msinger/gbreveng/pcb/fpgaboard/bom.ods

Designator | MPN/Seeed SKU | Qty | Link | Unit Price | Qty Price | Footprint | Value
X1 | ASTX-H11-12.000MHZ-T | 1 | https://eu.mouser.com/ProductDetail/ABRACON/ASTX-H11-12000MHZ-T?qs=tfZGHB2PWd3hgco%252bnV3PjQ%3d%3d | $3.170 | $3.170 | 3.2 mm x 2.5 mm | 12 MHz
X2 | LFSPXO054791Cutt | 1 | https://eu.mouser.com/ProductDetail/IQD/LFSPXO054791Cutt?qs=SNm0F99quPHVYfHQp5%2fdgA%3d%3d | $1.680 | $1.680 | 3.2 mm x 2.5 mm | 16.777216 MHz
C1,C2,C3,C9,C16,C17,C29,C81 | CC0603KRX5R6BB106 | 8 | https://statics3.seeedstudio.com/images/opl/datasheet/302010103.pdf | $0.020 | $0.160 | 0603 | 10µF
C12,C13 | CC0805MKX5R5BB226 | 2 | https://statics3.seeedstudio.com/images/opl/datasheet/302010171.pdf | $0.024 | $0.048 | 0805 | 22µF
C109,C110,C111,C113 | GRM31CR60J107ME39L | 4 | https://statics3.seeedstudio.com/images/opl/datasheet/302010183.pdf | $0.400 | $1.600 | 1206 | 100µF
C4,C5,C6,C11,C14,C15,C20,C21,C23,C24,C25,C26,C28,C30,C31,C32,C33,C35,C37,C38,C39,C40,C41,C42,C43,C44,C45,C46,C47,C48,C49,C50,C51,C52,C53,C54,C55,C56,C57,C58,C59,C60,C61,C62,C63,C64,C65,C66,C67,C68,C69,C70,C71,C72,C73,C74,C75,C76,C77,C78,C79,C80,C83,C85,C86,C91,C92,C93,C94,C95,C96,C97,C98,C99,C100,C104,C105,C112 | CC0402KRX7R8BB104 | 78 | https://statics3.seeedstudio.com/images/opl/datasheet/302010024.pdf | $0.010 | $0.780 | 0402 | 100nF
C7,C8,C22,C27,C84 | CC0402KRX7R9BB103 | 5 | https://statics3.seeedstudio.com/images/opl/datasheet/302010006.pdf | $0.010 | $0.050 | 0402 | 10nF
C10,C34,C36 | CC0603KRX5R6BB475 | 3 | https://statics3.seeedstudio.com/images/opl/datasheet/302010111.pdf | $0.010 | $0.030 | 0603 | 4.7µF
C18,C19,C82,C101,C102,C103 | CC0402KRX5R6BB105 | 6 | https://statics3.seeedstudio.com/images/opl/datasheet/302010040.pdf | $0.010 | $0.060 | 0402 | 1µF
C87,C88,C89,C90 | CC0402JRNPO9BN101 | 4 | https://statics3.seeedstudio.com/images/opl/datasheet/302010012.pdf | $0.010 | $0.040 | 0402 | 100pF
C106,C107,C108 | CC0402KRX7R8BB473 | 3 | https://statics3.seeedstudio.com/images/opl/datasheet/302010002.pdf | $0.010 | $0.030 | 0402 | 47nF
R1,R2,R13 | RC0805JR-07100RL | 3 | https://statics3.seeedstudio.com/images/opl/datasheet/301010319.pdf | $0.010 | $0.030 | 0805 | 100Ω
R3,R4,R20,R124 | RC0402JR-071ML | 4 | https://statics3.seeedstudio.com/images/opl/datasheet/301010009.pdf | $0.010 | $0.040 | 0402 | 1MΩ
R5,R6,R7,R8,R9,R17,R19,R21,R27,R28,R29,R30,R32,R33,R37,R38,R39,R40,R41,R42,R43,R44,R47,R48,R49,R50,R51,R52,R53,R54,R55,R56,R57,R58,R59,R60,R61,R62,R63,R64,R65,R66,R83,R84,R85,R86,R87,R88,R89,R91,R92,R93,R94,R103,R104,R105,R106,R107,R108,R109,R110,R111,R112,R114,R115,R125,R126,R128,R129,R135,R136,R137,R138,R139 | RC0402JR-0710KL | 74 | https://statics3.seeedstudio.com/images/opl/datasheet/301010004.pdf | $0.010 | $0.740 | 0402 | 10kΩ
R10 | WR04X3573FTL | 1 | https://eu.mouser.com/ProductDetail/Walsin/WR04X3573FTL?qs=t1sE%252bOcWp5vGlB9Bewecbg%3d%3d | $0.124 | $0.124 | 0402 | 1% 357kΩ
R11 | AC0402FR-07210KL | 1 | https://eu.mouser.com/ProductDetail/Yageo/AC0402FR-07210KL?qs=ygRr%2ftkhtev38ZlIvvgTpQ%3d%3d | $0.100 | $0.100 | 0402 | 1% 210kΩ
R18,R67,R68,R69,R70,R71,R72,R73,R74,R75,R76,R77,R78,R79,R80,R81,R82 | RC0402JR-071KL | 17 | https://statics3.seeedstudio.com/images/opl/datasheet/301010006.pdf | $0.010 | $0.170 | 0402 | 1kΩ
R22,R24 | RC0402JR-072K2L | 2 | https://statics3.seeedstudio.com/images/opl/datasheet/301010039.pdf | $0.011 | $0.022 | 0402 | 2.2kΩ
R23 | RC0402FR-0712KL | 1 | https://statics3.seeedstudio.com/images/opl/datasheet/resistance-series.pdf | $0.010 | $0.010 | 0402 | 1% 12kΩ
R36 | RC0402FR-07649RL | 1 | https://eu.mouser.com/ProductDetail/Yageo/RC0402FR-07649RL?qs=Is6ZsIPfHkYMbt18SYSi%252bQ%3d%3d | $0.100 | $0.100 | 0402 | 1% 649Ω
R95,R96,R97,R98,R99,R100,R101,R102,R116,R117,R118,R119,R120,R121,R122,R123 | RC0603JR-0710RL | 16 | https://statics3.seeedstudio.com/images/opl/datasheet/301010096.pdf | $0.010 | $0.160 | 0603 | 10Ω
R12,R130,R131,R132,R133 | RC0805JR-07220RL | 5 | https://statics3.seeedstudio.com/images/opl/datasheet/301010315.pdf | $0.010 | $0.050 | 0805 | 220Ω
R140,R141,R142 | RC0402JR-0747RL | 3 | https://statics3.seeedstudio.com/images/opl/datasheet/resistance-series.pdf | $0.010 | $0.030 | 0402 | 47Ω
RV1,RV2,RV3 | TS53YL102MR10 | 3 | https://eu.mouser.com/ProductDetail/Vishay-Sfernice/TS53YL102MR10?qs=R4%2fAj8xQbdWvnedTKTFTKg%3d%3d | $1.660 | $4.980 | Vishay TS53YL | 1kΩ
Q1,Q2 | BSS138W-7-F | 2 | https://statics3.seeedstudio.com/images/opl/datasheet/305030000.pdf | $0.033 | $0.066 | SOT-323 | BSS138
L5,L6 | Murata;LQW15AN33NJ00D | 2 | https://statics3.seeedstudio.com/images/opl/datasheet/303010106.pdf | $0.024 | $0.048 | 0402 | 33nH
L1,L2,L3,L4 | MMZ1608B601C | 4 | https://eu.mouser.com/ProductDetail/TDK/MMZ1608B601C?qs=fOf5s7IOgVG9xKc6xJGMYw%3d%3d | $0.100 | $0.400 | 0603 | 600Ω 500mA
SW0,SW1,SW2,SW3 | TD-1183SN-A3N-D1R | 4 | https://statics3.seeedstudio.com/fusion/opl/datasheet/311020740.pdf | $0.256 | $1.024 | 3 mm x 2.5 mm
SW4,SW5 | CTS;206-8 | 2 | https://eu.mouser.com/ProductDetail/CTS-Electronic-Components/206-8?qs=qNzHFtQhdJ%252bV9O%2fUzcUFng%3d%3d | $0.914 | $1.828 | W 7.63 mm
D0,D1,D2,D3,D4,D5,D6,D7,D8,D9,D10,D11,D12,D13,D14,D15 | 17-215SURC/S530-A2/TR8 | 16 | https://statics3.seeedstudio.com/images/opl/datasheet/304090046.pdf | $0.026 | $0.416 | 0805 | red
D17,D18 | 17-215SYGC/S530-E2/TR8 | 2 | https://statics3.seeedstudio.com/images/opl/datasheet/304090057.pdf | $0.026 | $0.052 | 0805 | green
D16 | CDBU0520 | 1 | https://eu.mouser.com/ProductDetail/Comchip-Technology/CDBU0520?qs=QrYNfmA0esYvGSGDalbccA%3d%3d | $0.452 | $0.452 | 0603 | CDBU0520
D19,D20,D21,D22 | BAV199WQ-7 | 4 | https://eu.mouser.com/ProductDetail/Diodes-Incorporated/BAV199WQ-7?qs=xLhQT1EE4V%252brO8tFabP6bQ%3d%3d | $0.271 | $1.084 | SOT-323 | BAV199WQ
D23 | BAV100-GS08 | 1 | https://eu.mouser.com/ProductDetail/Vishay-Semiconductors/BAV100-GS08?qs=WLTup5mM6hiycTaKo%2fbC7A%3d%3d | $0.201 | $0.201 | MiniMELF | BAV100
J2 | 105017-0001 | 1 | https://eu.mouser.com/ProductDetail/Molex/105017-0001?qs=hlXxxvYE36k7QcsR97GUKA%3d%3d | $0.783 | $0.783
J11 | DM3AT-SF-PEJM5 | 1 | https://eu.mouser.com/ProductDetail/Hirose-Connector/DM3AT-SF-PEJM5?qs=LZSZKJVF%252b2WTDKp%252bR7IYAQ%3d%3d | $2.630 | $2.630
J28 | SJ1-3533NG | 1 | https://eu.mouser.com/ProductDetail/CUI/SJ1-3533NG?qs=WyjlAZoYn53GjNky%252bNFGCA%3d%3d | $1.170 | $1.170
J6 | 52045-2145 | 1 | https://eu.mouser.com/ProductDetail/Molex/52045-2145?qs=g5f4E6w8l8i4Jv%252bBEK7mDw%3d%3d | $0.794 | $0.794
U1 | LT3030EFE#PBF | 1 | https://www.digikey.com/short/pcf4ht | $7.120 | $7.120 | 20-ETSSOP
U2 | W25Q32JVSSIM TR | 1 | https://eu.mouser.com/ProductDetail/Winbond/W25Q32JVSSIM-TR?qs=qSfuJ%252bfl%2fd55hO45Ox4sXQ%3d%3d | $0.823 | $0.823 | SOIC-8 208 | 4M x 8bit
U3 | ICE40HX8K-CT256 | 1 | https://eu.mouser.com/ProductDetail/Lattice/iCE40HX8K-CT256?qs=F9A14TELRMtUXwpvAxLNcw%3d%3d | $11.350 | $11.350 | 256-CABGA
U4 | 93LC56BT-I/SN | 1 | https://eu.mouser.com/ProductDetail/Microchip-Technology/93LC56BT-I-SN?qs=lQv0JY93vreW%252bBssv4v8RA%3d%3d | $0.251 | $0.251 | SOIC-8 150 | 128 x 16bit
U5 | FT2232HL-REEL | 1 | https://eu.mouser.com/ProductDetail/FTDI/FT2232HL-REEL?qs=D1%2fPMqvA100v7FHcEx164g%3d%3d | $6.740 | $6.740 | LQFP-64
U6,U7,U8,U9,U10,U11,U12,U13,U14,U15,U16 | SN74LVCH8T245PWR | 11 | https://eu.mouser.com/ProductDetail/Texas-Instruments/SN74LVCH8T245PWR?qs=H8TbSl0SgbH0mxJKLczsYg%3d%3d | $1.320 | $14.520 | 24-TSSOP
U19 | SN74AHC1GU04DCK3 | 1 | https://eu.mouser.com/ProductDetail/Texas-Instruments/SN74AHC1GU04DCK3?qs=HtiCF%252bSLVmeK2lzXvlFtoA%3d%3d | $0.412 | $0.412 | SC-70-5
U18,U21 | IS62WV10248EBLL-45TLI | 2 | https://eu.mouser.com/ProductDetail/ISSI/IS62WV10248EBLL-45TLI?qs=uCnMRCNammlHlbXwB0OS3A%3d%3d | $6.080 | $12.160 | 44-400mil-TSOP-2 | 1M x 8bit
U17,U20,U22 | IS62WV1288BLL-55QLI | 3 | https://eu.mouser.com/ProductDetail/ISSI/IS62WV1288BLL-55QLI?qs=YdQ7Kj7W0byrjrEhKf64%2fw%3d%3d | $2.550 | $7.650 | 32-SOP | 128k x 8bit
 |  | 310 |  |  | $86.178
