msinger/gbreveng/(threads)

Thread 1 (2024-06-24):

Missing m1 in TRI_BUF_IF0

ogamespec, 2024-06-24:
Missed a little metal tail here:

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

msinger, 2024-06-24:
Right. Output of P1 is not connected anywhere if this bridge is missing. I wonder why I drew the schematics correctly then without noticing this.

Thread 2 (2024-09-17):

CK1_CK2 Pad

ogamespec, 2024-09-17:
Hi, I rebuilt the CK1_CK2 (OSC) masks and it looks like your transistor circuit and logic interpretation is different from what it actually is.

More details here:
https://github.com/emu-russia/dmgcpu/blob/main/wiki/soc/pads.md#osc

msinger, 2024-09-17:
Oh, nice. Then I should take my schematic of this cell down. It was just a guess, based on the other I/O cells, since I haven't done its layout yet.

Did you look at the SCK pad? It also has more logic than the others. Maybe I got this wrong too.

ogamespec, 2024-09-17:
As part of my analysis, I plan to do cross-checking with your results, everything I can get my hands on, including the rest of the pads :)

ogamespec, 2024-09-20:
Better view of CK1/CK2 internal logic:

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

msinger, 2024-09-20:
Great, thanks. I'm wondering about the bottom part a bit more. Is this what I see?
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

And then the same thing basically mirrored for the ground side?
Do you know why this is? Could this be protection against voltage spikes that may be generated by the crystal? I don't know much about analog stuff. Does a crystal have characteristics of an inductor maybe? If the voltage at the pad rises and then suddenly stops, that the crystal keeps pulling it up further, way past VDD? So, it could work like the diodes. But why aren't the diodes then enough?

My thought is that if you apply a voltage at the pad, which is higher than VDD, then VDD becomes ground, and then the transistor I've drawn at the right gets conductive and pulls the voltage at the pad down to VDD.

What is your thought about these transistors in the bottom part? Did I misunderstand something? I'm not sure.

ogamespec, 2024-09-20:
Yes it is, one of the two transistors in each of the “pieces” is “disabled” for some reason. I see this often, most likely it is just to regulate the power of the output signal (the more transistors “in parallel” - the more powerful the signal).
Analog electronics specialists will tell you more, I am not one of them :-)

Thread 4 (2024-09-25):

Strange sense amp in SRAM

ogamespec, 2024-09-25:
I found that the Sense Amp, which is just above the Column Mux for some reason works “in reverse” - it amplifies the value from the data bus instead of the cell. What do you think about it?

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

msinger, 2024-09-25:
I'm not an expert in SRAM terminology. :)
I think it is not the sense amp. I think the sense amps are the ones at the top in your picture, because they amplify the value read from the cell. I don't know what the "reverse sense amps" are typically called, but you need a strong driver to flip the value in the cells when writing. And those strong drivers need to drive the value through the column muxers at the bottom, so they need to be very big too.

ogamespec, 2024-09-25:
So there is no canonical Sense Amp in the circuit?

msinger, 2024-09-25:
Ah, okay, sorry, I understand. It's a picture of a sense amplifier. I think they don't need a circuit like this, because they use dynamic logic. Since the bit lines go through the column multiplexer, which consists of only NMOS transistors, the bit lines can only drive low states. So in your sense amplifier circuit, M3 and M4 are driven directly by the bit lines, and M1 and M2 provide the complementary, based on the output of M3 and M4. In the Game Boy, they provide the complementary by precharging, using transistors P8 and P9.
I think in a standard SRAM chip, you don't want dynamic logic, because you would need a clock for controlling that, so they use the circuit you provided. In the Game Boy, they have the clock anyway, so maybe it's simpler to implement using precharging.

msinger, 2024-09-26:
After sleeping over it, of course what I wrote makes no sense. You need to precharge the bit lines anyway. I don't know why they implemented the sensing differently.

ogamespec, 2024-09-27:
Thanks, yes I also think that because of precharge they don't need to add Sense Amp and even the output nor latch doesn't play a “sense” role here, it's just used as a flip/flop to keep the bus going (“bus keeper”).
Why I asked all this - you have “sense amp” in your Cells Reference, so I just wanted to clarify.
I think we can close :-)

ogamespec, 2024-09-27:
My part of the SRAM elements research:
https://github.com/ogamespec/dmgcpu/blob/main/wiki/soc/hram.md

It's not finished, but the other elements have already been explored by you and are pretty simple and of little interest (Cell Array, Row Decoder).

Closed 2024-09-27.

Thread 5 (2025-03-09):

/CS link broken

ogamespec, 2025-03-09:
In section: http://iceboy.a-singer.de/doc/dmg_cells.html#obuf_a

If you click on `CS`, it doesn't link anywhere. Probably meant `/CS`.

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

msinger, 2025-03-09:
Yes, thank you!

Closed 2025-03-09.
