msinger/gbreveng/pcb/disp_bridge/disp_bridge.kicad_pcb

## KiCad design pcb/disp_bridge/disp_bridge.kicad_pcb (2024-06-20)

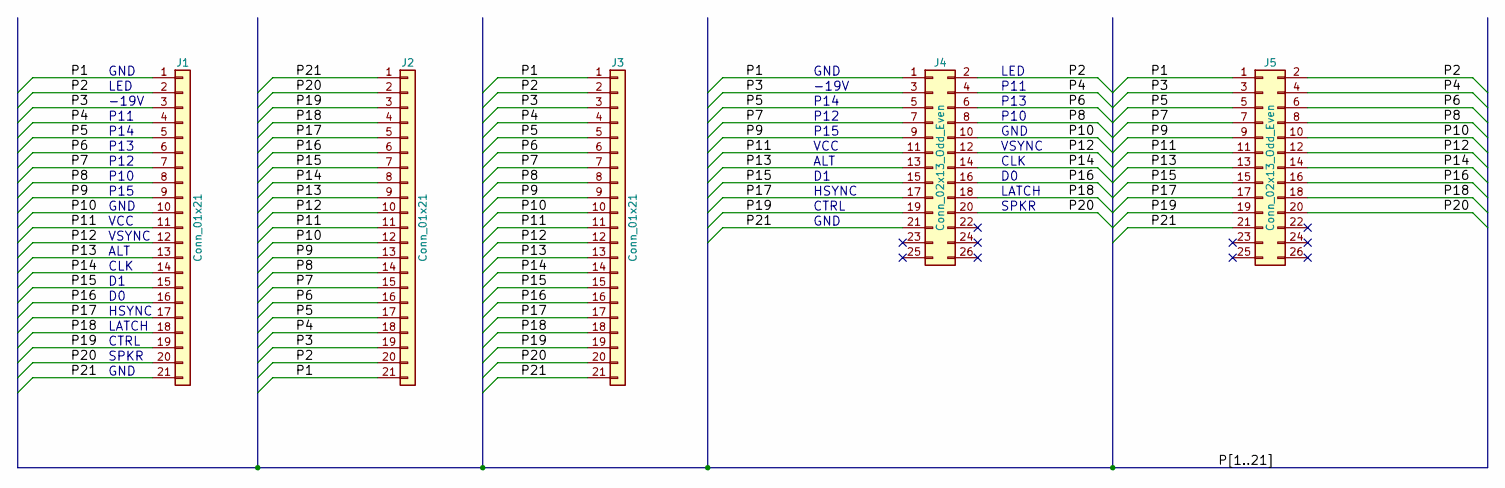
[picture p1: schematic disp_bridge.kicad_sch, Display Bridge]

Parts:
J1, J2, J3: Conn_01x21; DMG_FFC_LCD-Board_21Pin
J4, J5: Conn_02x13_Odd_Even; PinHeader_2x13_P2.54mm_Vertical

Connections:
/P1: J1.1, J2.21, J3.1, J4.1, J5.1
/P2: J1.2, J2.20, J3.2, J4.2, J5.2
/P3: J1.3, J2.19, J3.3, J4.3, J5.3
/P4: J1.4, J2.18, J3.4, J4.4, J5.4
/P5: J1.5, J2.17, J3.5, J4.5, J5.5
/P6: J1.6, J2.16, J3.6, J4.6, J5.6
/P7: J1.7, J2.15, J3.7, J4.7, J5.7
/P8: J1.8, J2.14, J3.8, J4.8, J5.8
/P9: J1.9, J2.13, J3.9, J4.9, J5.9
/P10: J1.10, J2.12, J3.10, J4.10, J5.10
/P11: J1.11, J2.11, J3.11, J4.11, J5.11
/P12: J1.12, J2.10, J3.12, J4.12, J5.12
/P13: J1.13, J2.9, J3.13, J4.13, J5.13
/P14: J1.14, J2.8, J3.14, J4.14, J5.14
/P15: J1.15, J2.7, J3.15, J4.15, J5.15
/P16: J1.16, J2.6, J3.16, J4.16, J5.16
/P17: J1.17, J2.5, J3.17, J4.17, J5.17
/P18: J1.18, J2.4, J3.18, J4.18, J5.18
/P19: J1.19, J2.3, J3.19, J4.19, J5.19
/P20: J1.20, J2.2, J3.20, J4.20, J5.20
/P21: J1.21, J2.1, J3.21, J4.21, J5.21

Notes on the sheet:
SPKR
LATCH
P15
VSYNC
P11
P13
GND
P14
HSYNC
P12
-19V
VCC
P10
CLK
ALT
LED
CTRL

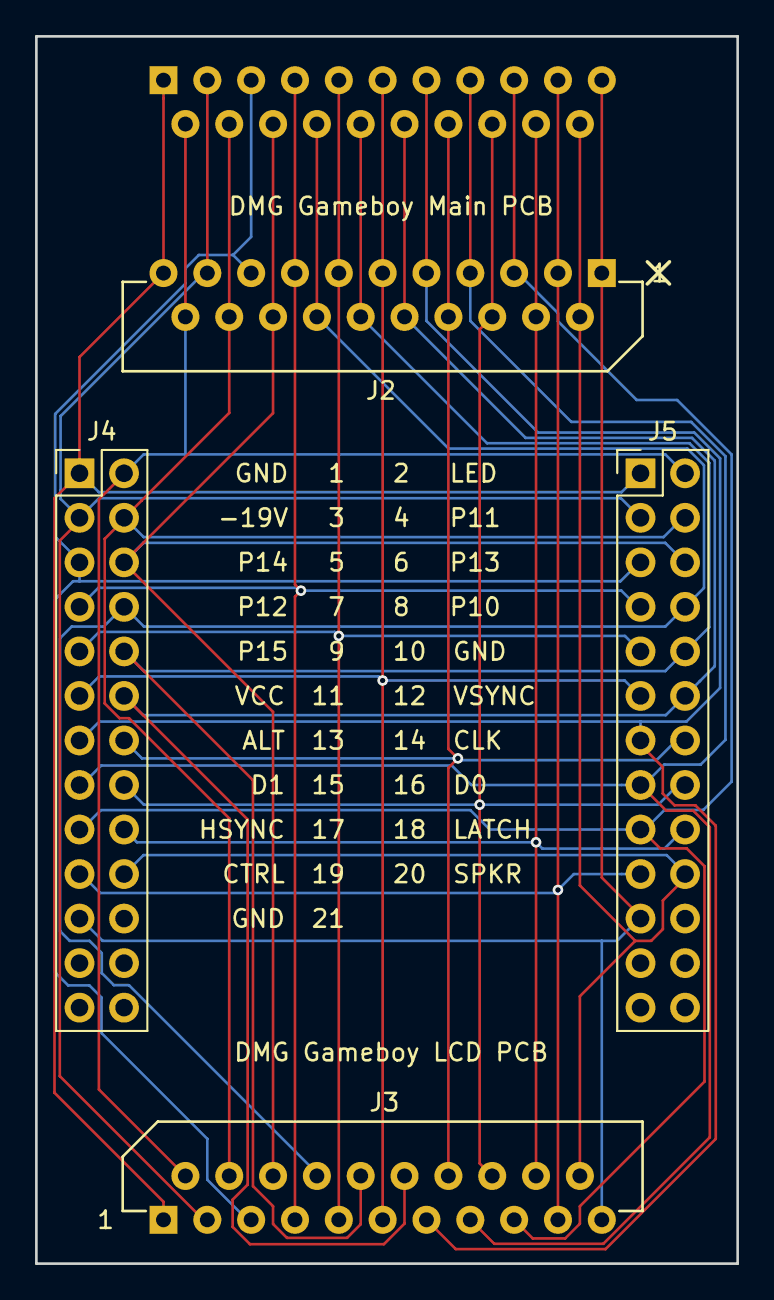
[picture p2: board disp_bridge.kicad_pcb from above]

Board: 2 copper layers, 40.0 x 70.0 mm, 5 parts (1 on the bottom side), 21 nets.
