msinger/gbreveng/pcb/lcdpwr/lcdpwr.kicad_pcb

## KiCad design pcb/lcdpwr/lcdpwr.kicad_pcb (2024-06-20)

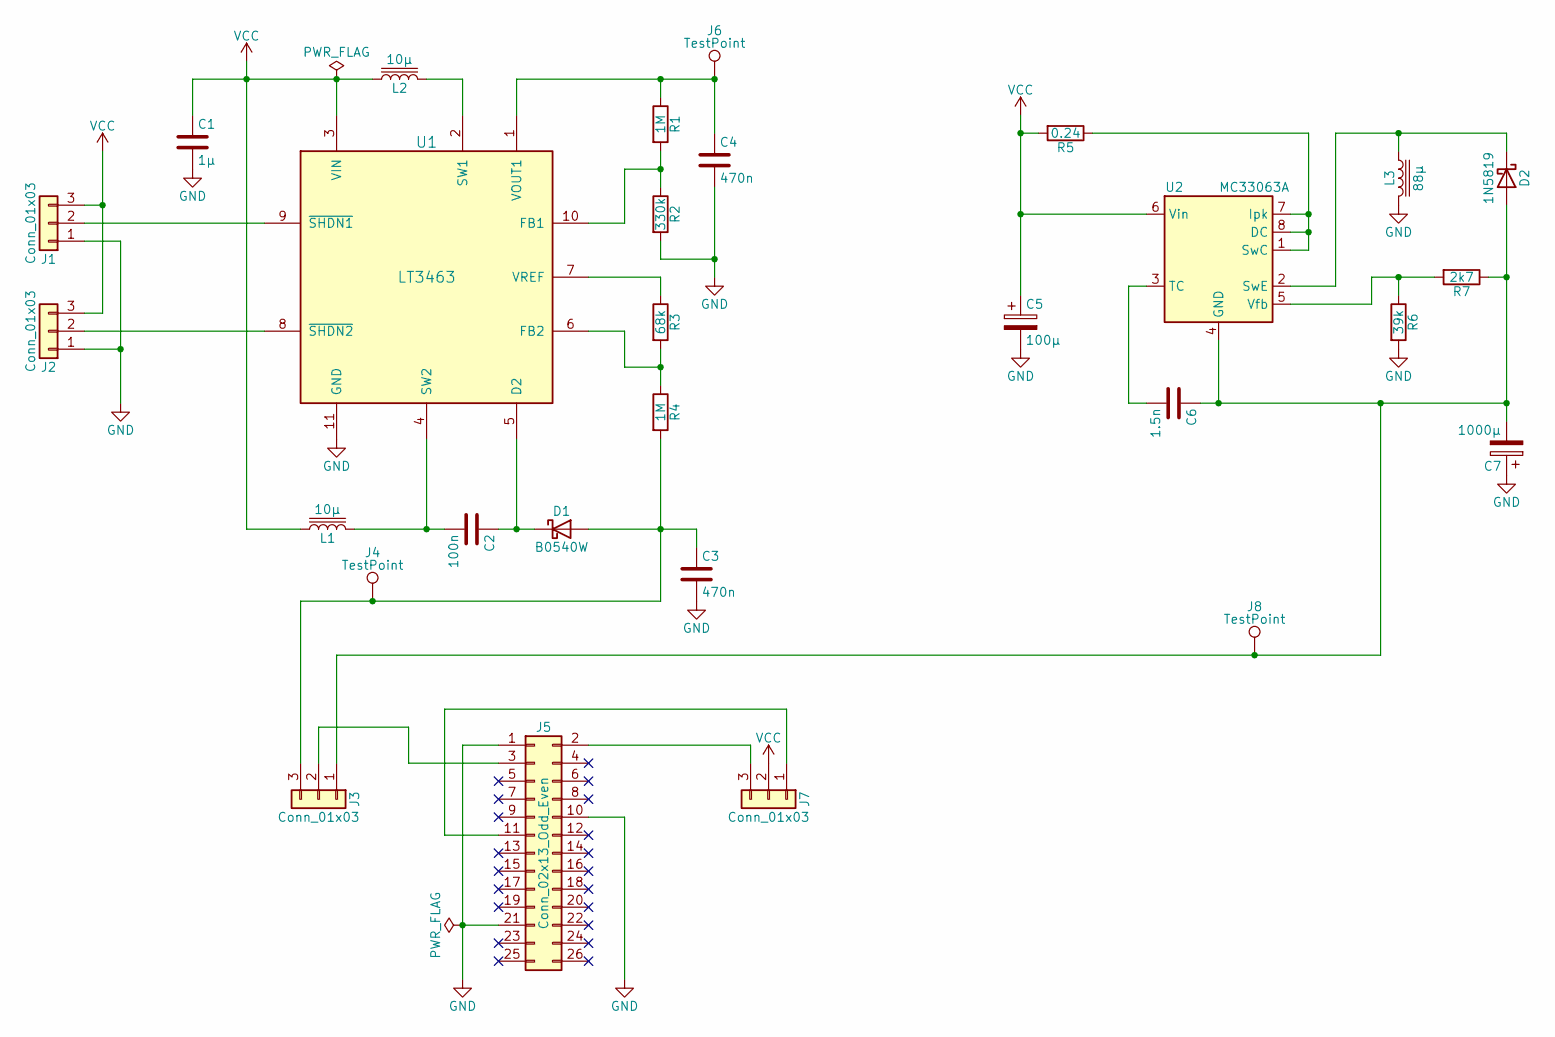
[picture p3: schematic lcdpwr.kicad_sch, DMG LCD Power]

Parts:
C1: 1µ; C_Disc_D4.3mm_W1.9mm_P5.00mm
C2: 100n; C_Disc_D3.0mm_W1.6mm_P2.50mm
C3, C4: 470n; C_Rect_L13.0mm_W4.0mm_P10.00mm_FKS3_FKP3_MKS4
C5: 100µ; CP_Radial_D5.0mm_P2.50mm
C6: 1.5n; C_Disc_D4.3mm_W1.9mm_P5.00mm
C7: 1000µ; CP_Radial_D10.0mm_P5.00mm
D1: B0540W; D_SOD-123
D2: 1N5819; D_A-405_P10.16mm_Horizontal
J1, J2, J3, J7: Conn_01x03; PinHeader_1x03_P2.54mm_Vertical
J4, J6, J8: TestPoint; TestPoint_Keystone_5010-5014_Multipurpose
J5: Conn_02x13_Odd_Even; PinHeader_2x13_P2.54mm_Vertical
L1, L2: 10µ; L_Radial_D7.0mm_P3.00mm
L3: 88µ; L_Radial_D12.5mm_P7.00mm_Fastron_09HCP
R1, R4: 1M; R_Axial_DIN0207_L6.3mm_D2.5mm_P10.16mm_Horizontal
R2: 330k; R_Axial_DIN0207_L6.3mm_D2.5mm_P10.16mm_Horizontal
R3: 68k; R_Axial_DIN0207_L6.3mm_D2.5mm_P10.16mm_Horizontal
R5: 0.24; R_Axial_DIN0411_L9.9mm_D3.6mm_P12.70mm_Horizontal
R6: 39k; R_Axial_DIN0207_L6.3mm_D2.5mm_P10.16mm_Horizontal
R7: 2k7; R_Axial_DIN0207_L6.3mm_D2.5mm_P10.16mm_Horizontal
U1: LT3463; DFN-10-1EP_3x3mm_P0.5mm_EP1.55x2.48mm
U2: MC33063A; DIP-8_W7.62mm_Socket_LongPads

Connections:
GND: C1.2, C3.2, C4.2, C5.2, C7.1, J1.1, J2.1, J5.1, J5.10, J5.21, L3.2, R2.2, R6.2, U1.11 (GND)
unnamed: C3.1, D1.2 (A), J3.3, J4.1, R4.2
unnamed: C2.1, D1.1 (K), U1.5 (D2)
unnamed: C6.1, C7.2, D2.2 (A), J3.1, J8.1, R7.1, U2.4 (GND)
unnamed: D2.1 (K), L3.1, U2.2 (SwE)
unnamed: J1.2, U1.9 (~SHDN1)
unnamed: J2.2, U1.8 (~SHDN2)
unnamed: J3.2, J5.3
unnamed: J5.2, J7.3
unnamed: J5.11, J7.1
unnamed: R1.2, R2.1, U1.10 (FB1)
unnamed: R3.2, R4.1, U1.6 (FB2)
unnamed: L2.2, U1.2 (SW1)
unnamed: C2.2, L1.2, U1.4 (SW2)
unnamed: C4.1, J6.1, R1.1, U1.1 (VOUT1)
unnamed: R3.1, U1.7 (VREF)
unnamed: R5.1, U2.1 (SwC), U2.7 (Ipk), U2.8 (DC)
unnamed: C6.2, U2.3 (TC)
unnamed: R6.1, R7.2, U2.5 (Vfb)
VCC: C1.1, C5.1, J1.3, J2.3, J7.2, L1.1, L2.1, R5.2, U1.3 (VIN), U2.6 (Vin)

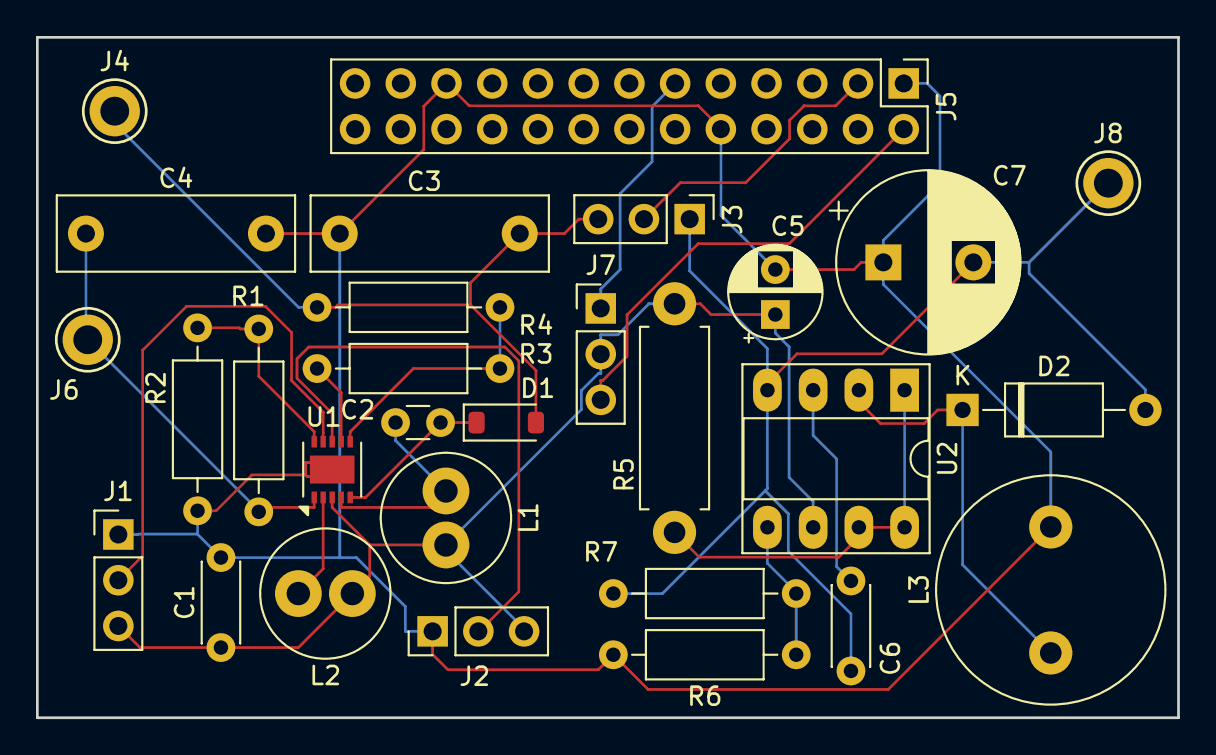
[picture p4: board lcdpwr.kicad_pcb from above]

Board: 2 copper layers, 63.4 x 37.8 mm, 29 parts (0 on the bottom side), 20 nets.
