msinger/gbreveng/pcb/soundfix/soundfix.kicad_pcb

## KiCad design pcb/soundfix/soundfix.kicad_pcb (2024-06-20)

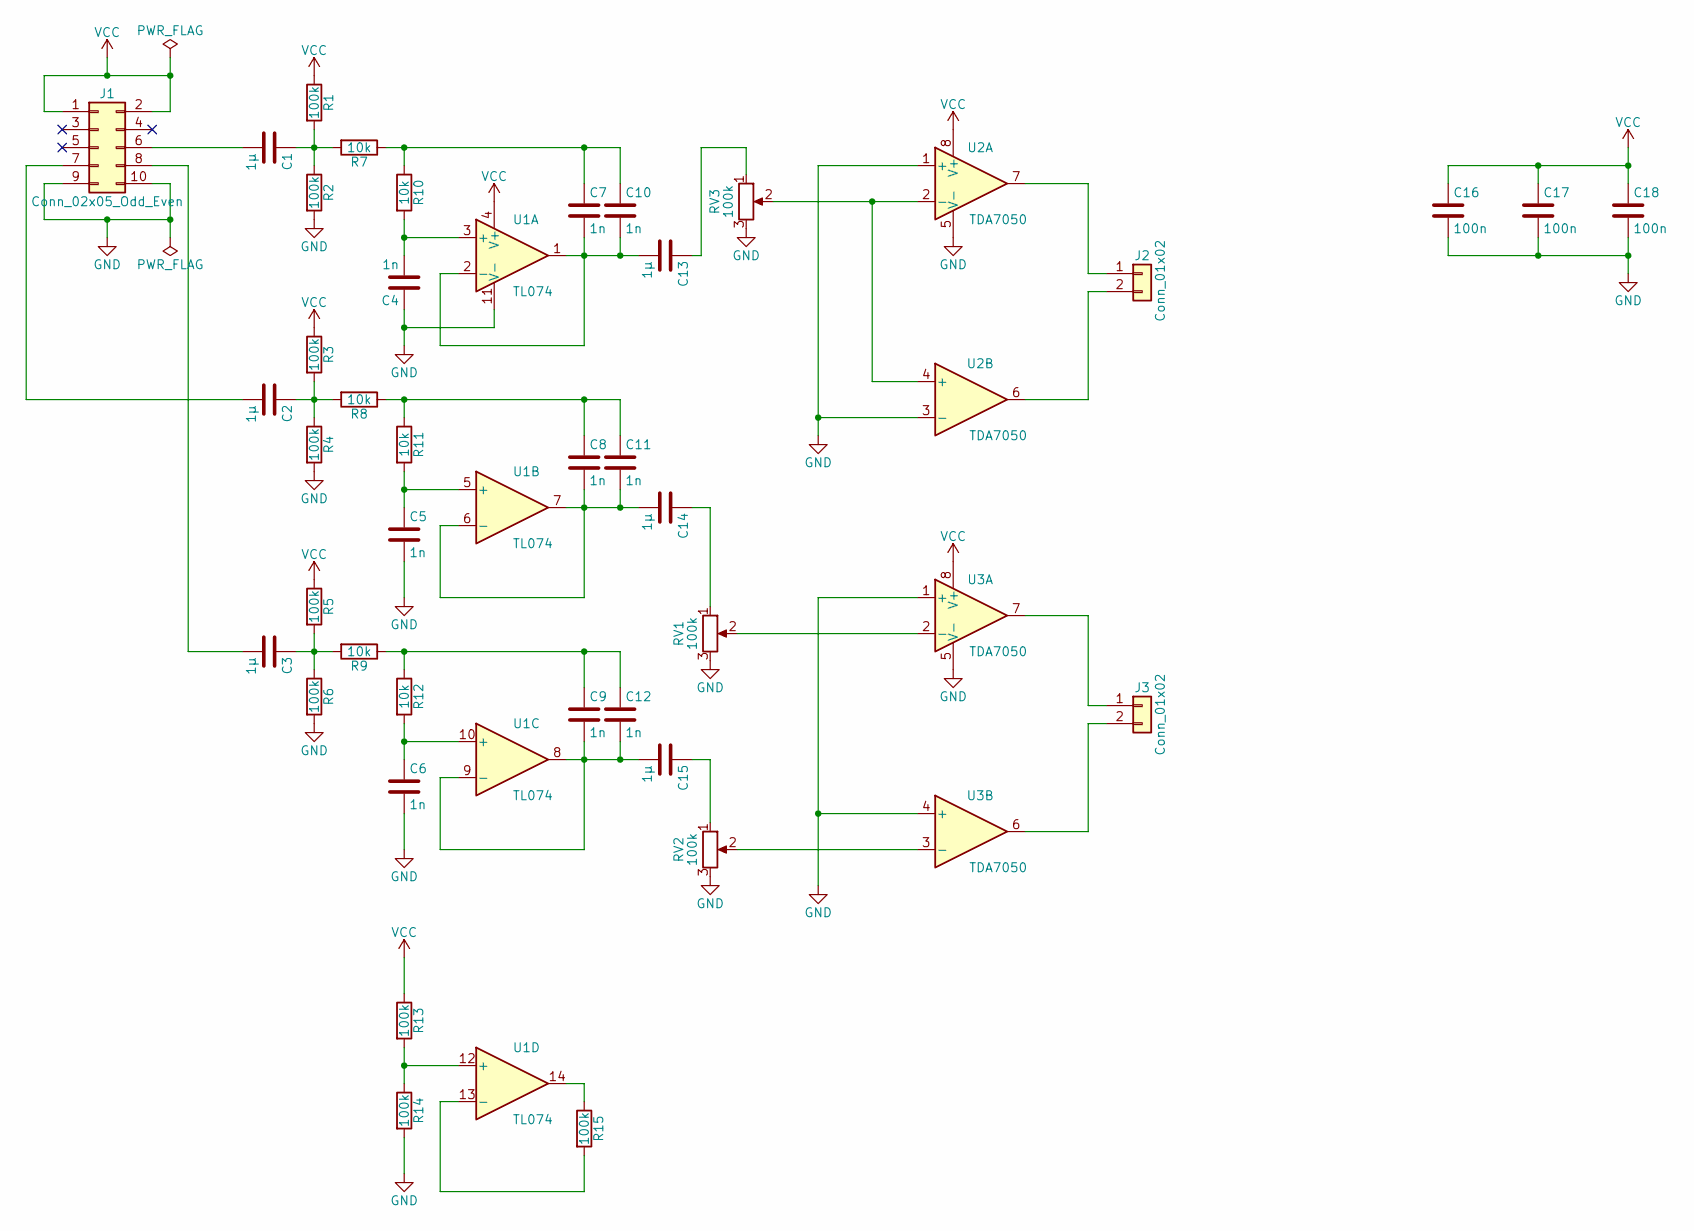
[picture p5: schematic soundfix.kicad_sch, Sound Fix for gbreveng board]

Parts:
C1, C2, C3, C13, C14, C15: 1µ; C_Disc_D5.0mm_W2.5mm_P5.00mm
C4, C5, C6, C7, C8, C9, C10, C11, C12: 1n; C_Disc_D3.0mm_W2.0mm_P2.50mm
C16, C17, C18: 100n; C_Disc_D3.0mm_W2.0mm_P2.50mm
J1: Conn_02x05_Odd_Even; PinSocket_2x05_P2.54mm_Vertical
J2, J3: Conn_01x02; PinHeader_1x02_P2.54mm_Vertical
R1, R2, R3, R4, R5, R6, R13, R14, R15: 100k; R_Axial_DIN0207_L6.3mm_D2.5mm_P2.54mm_Vertical
R7, R8, R9, R10, R11, R12: 10k; R_Axial_DIN0207_L6.3mm_D2.5mm_P2.54mm_Vertical
RV1, RV2, RV3: 100k; Potentiometer_ACP_CA9-H2,5_Horizontal
U1: TL074; DIP-14_W7.62mm_Socket
U2, U3: TDA7050; DIP-8_W7.62mm_Socket

Connections:
GND: C4.1, C5.2, C6.2, C16.2, C17.2, C18.2, J1.9, J1.10, R2.2, R4.2, R6.2, R14.2, RV1.3, RV2.3, RV3.3, U1.11 (V-), U2.1 (+), U2.3 (-), U2.5 (V-), U3.1 (+), U3.4 (+), U3.5 (V-)
unnamed: C1.1, R1.2, R2.1, R7.2
unnamed: C2.1, R3.2, R4.1, R8.2
unnamed: C3.1, R5.2, R6.1, R9.2
unnamed: C7.1, C10.1, R7.1, R10.1
unnamed: C8.1, C11.1, R8.1, R11.1
unnamed: C9.1, C12.1, R9.1, R12.1
unnamed: C13.1, RV3.1
unnamed: C14.1, RV1.1
unnamed: C15.1, RV2.1
unnamed: C1.2, J1.6
unnamed: C2.2, J1.7
unnamed: C3.2, J1.8
unnamed: J2.1, U2.7
unnamed: J2.2, U2.6
unnamed: J3.1, U3.7
unnamed: J3.2, U3.6
unnamed: R15.1, U1.14
unnamed: C4.2, R10.2, U1.3 (+)
unnamed: C7.2, C10.2, C13.2, U1.1, U1.2 (-)
unnamed: C5.1, R11.2, U1.5 (+)
unnamed: C8.2, C11.2, C14.2, U1.6 (-), U1.7
unnamed: C6.1, R12.2, U1.10 (+)
unnamed: C9.2, C12.2, C15.2, U1.8, U1.9 (-)
unnamed: R13.2, R14.1, U1.12 (+)
unnamed: R15.2, U1.13 (-)
unnamed: RV3.2, U2.2 (-), U2.4 (+)
unnamed: RV1.2, U3.2 (-)
unnamed: RV2.2, U3.3 (-)
VCC: C16.1, C17.1, C18.1, J1.1, J1.2, R1.1, R3.1, R5.1, R13.1, U1.4 (V+), U2.8 (V+), U3.8 (V+)

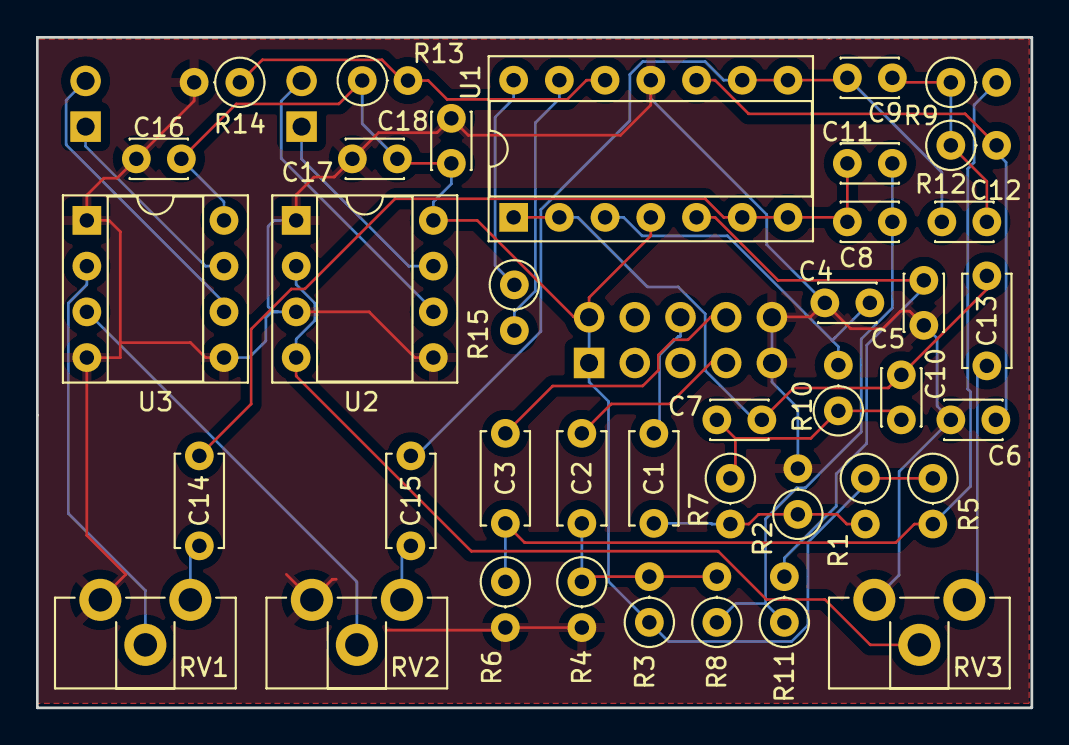
[picture p6: board soundfix.kicad_pcb from above]

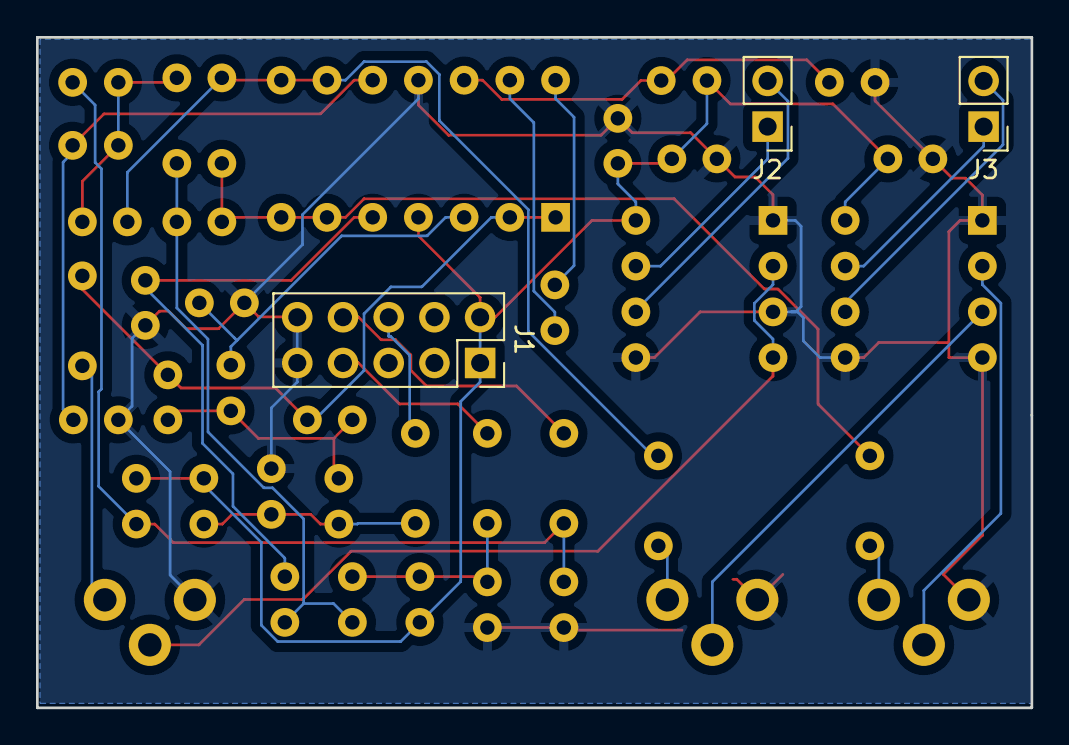
[picture p7: board soundfix.kicad_pcb from below]

Board: 2 copper layers, 55.2 x 37.2 mm, 42 parts (3 on the bottom side), 30 nets.
