msinger/gbreveng/pcb/fpgaboard/fpgaboard.kicad_pcb

## KiCad design pcb/fpgaboard/fpgaboard.kicad_pcb (2021-10-21)

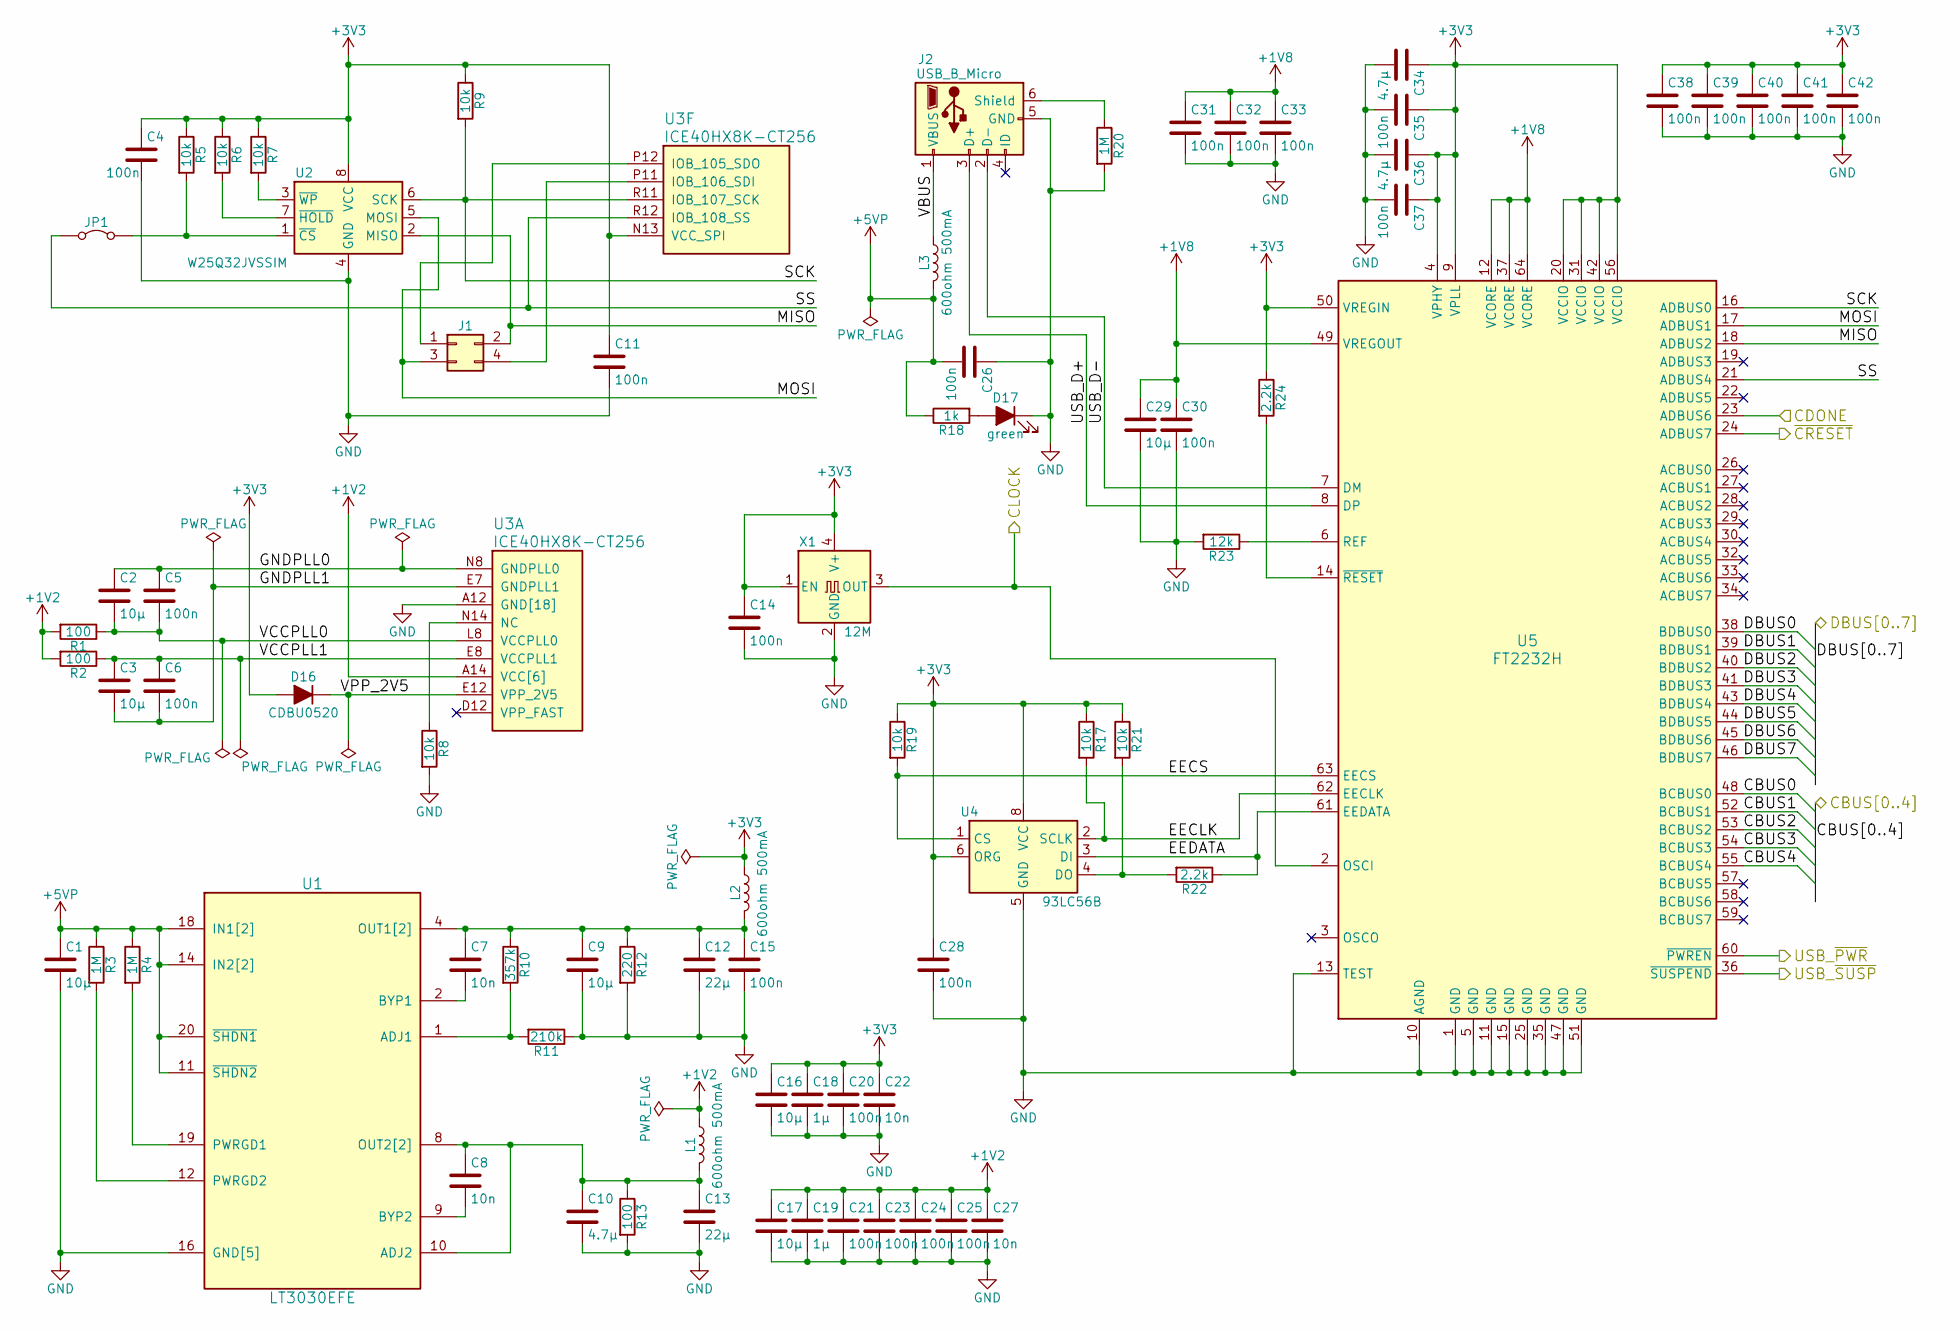
[picture p8: schematic power.kicad_sch, Game Boy reverse eng. FPGA board]

Parts:
C1, C2, C3, C9, C16, C17, C29: 10µ; C_0603_1608Metric
C4, C5, C6, C11, C14, C15, C20, C25, C26, C28, C30, C31, C32, C33, C35, C37, C38, C39, C40, C41, C42: 100n; C_0402_1005Metric_Pad0.74x0.62mm_HandSolder
C7, C8, C22: 10n; C_0402_1005Metric_Pad0.74x0.62mm_HandSolder
C10, C34, C36: 4.7µ; C_0603_1608Metric
C12, C13: 22µ; C_0805_2012Metric
C18, C19: 1µ; C_0402_1005Metric_Pad0.74x0.62mm_HandSolder
C21, C23, C24: 100n; C_0402_1005Metric
C27: 10n; C_0402_1005Metric
D16: CDBU0520; D_0603_1608Metric
D17: green; LED_0805_2012Metric_Pad1.15x1.40mm_HandSolder
J1: Conn_02x02_Odd_Even; PinHeader_2x02_P2.54mm_Vertical
J2: USB_B_Micro; USB_Micro-B_Molex-105017-0001
JP1: Jumper_2_Bridged; PinHeader_1x02_P2.54mm_Vertical
L1, L2, L3: 600ohm 500mA; L_0603_1608Metric
R1, R2, R13: 100; R_0805_2012Metric
R3, R4, R20: 1M; R_0402_1005Metric
R5, R6, R7, R8, R9, R17, R19, R21: 10k; R_0402_1005Metric
R10: 357k; R_0402_1005Metric
R11: 210k; R_0402_1005Metric
R12: 220; R_0805_2012Metric
R18: 1k; R_0402_1005Metric
R22, R24: 2.2k; R_0402_1005Metric
R23: 12k; R_0402_1005Metric
U1: LT3030EFE; ETSSOP-20-1EP_4.4x6.5mm_P0.65mm_EP3x4.2mm
U2: W25Q32JVSSIM; SOIC-8W_5.3x5.3mm_P1.27mm
U3: ICE40HX8K-CT256; BGA-256_14.0x14.0mm_Layout16x16_P0.8mm_Ball0.45mm_Pad0.32mm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
U4: 93LC56B; SOIC-8_3.9x4.9mm_P1.27mm
U5: FT2232H; LQFP-64_10x10mm_P0.5mm
X1: 12M; Oscillator_SMD_EuroQuartz_XO32-4Pin_3.2x2.5mm_HandSoldering

Connections:
+1V2: C17.1, C19.1, C21.1, C23.1, C24.1, C25.1, C27.1, L1.1, R1.2, R2.2, U3.A14 (VCC[6]), U3.F6 (VCC[6]), U3.F10 (VCC[6]), U3.K6 (VCC[6]), U3.K10 (VCC[6]), U3.L2 (VCC[6])
+1V8: C29.1, C30.1, C31.1, C32.1, C33.1, U5.12 (VCORE), U5.37 (VCORE), U5.49 (VREGOUT), U5.64 (VCORE)
+3V3: C4.1, C11.1, C14.1, C16.1, C18.1, C20.1, C22.1, C28.1, C34.1, C35.1, C36.1, C37.1, C38.1, C39.1, C40.1, C41.1, C42.1, D16.2 (A), L2.1, R5.1, R6.1, R7.1, R9.1, R17.1, R19.1, R21.1, R24.1, U2.8 (VCC), U3.N13 (VCC_SPI), U4.6 (ORG), U4.8 (VCC), U5.4 (VPHY), U5.9 (VPLL), U5.20 (VCCIO), U5.31 (VCCIO), U5.42 (VCCIO), U5.50 (VREGIN), U5.56 (VCCIO), X1.1 (EN), X1.4 (V+); also elsewhere on the board
+5VP: C1.1, C26.2, L3.1, R3.1, R4.1, R18.1, U1.11 (~SHDN2), U1.13 (IN2[2]), U1.14 (IN2[2]), U1.17 (IN1[2]), U1.18 (IN1[2]), U1.20 (~SHDN1); also elsewhere on the board
/Bank0: Display, Keyboard, Clock/CBUS0: U5.48 (BCBUS0); also elsewhere on the board
/Bank0: Display, Keyboard, Clock/CBUS1: U5.52 (BCBUS1); also elsewhere on the board
/Bank0: Display, Keyboard, Clock/CBUS2: U5.53 (BCBUS2); also elsewhere on the board
/Bank0: Display, Keyboard, Clock/CBUS3: U5.54 (BCBUS3); also elsewhere on the board
/Bank0: Display, Keyboard, Clock/CBUS4: U5.55 (BCBUS4); also elsewhere on the board
/Bank0: Display, Keyboard, Clock/DBUS0: U5.38 (BDBUS0); also elsewhere on the board
/Bank0: Display, Keyboard, Clock/DBUS1: U5.39 (BDBUS1); also elsewhere on the board
/Bank0: Display, Keyboard, Clock/DBUS2: U5.40 (BDBUS2); also elsewhere on the board
/Bank0: Display, Keyboard, Clock/DBUS3: U5.41 (BDBUS3); also elsewhere on the board
/Bank0: Display, Keyboard, Clock/DBUS4: U5.43 (BDBUS4); also elsewhere on the board
/Bank0: Display, Keyboard, Clock/DBUS5: U5.44 (BDBUS5); also elsewhere on the board
/Bank0: Display, Keyboard, Clock/DBUS6: U5.45 (BDBUS6); also elsewhere on the board
/Bank0: Display, Keyboard, Clock/DBUS7: U5.46 (BDBUS7); also elsewhere on the board
/Bank0: Display, Keyboard, Clock/USB_~PWR: U5.60 (~PWREN); also elsewhere on the board
/Bank0: Display, Keyboard, Clock/USB_~SUSP: U5.36 (~SUSPEND); also elsewhere on the board
/Bank2: SDCard/CDONE: U5.23 (ADBUS6); also elsewhere on the board
/Bank2: SDCard/~CRESET: U5.24 (ADBUS7); also elsewhere on the board
/Bank3: LEDs, Switches/CLOCK: U5.2 (OSCI), X1.3 (OUT); also elsewhere on the board
/Power, USB, SPI/EECLK: R17.2, U4.2 (SCLK), U5.62 (EECLK)
/Power, USB, SPI/EECS: R19.2, U4.1 (CS), U5.63 (EECS)
/Power, USB, SPI/EEDATA: R22.1, U4.3 (DI), U5.61 (EEDATA)
/Power, USB, SPI/GNDPLL0: C2.1, C5.1, U3.N8 (GNDPLL0)
/Power, USB, SPI/GNDPLL1: C3.2, C6.2, U3.E7 (GNDPLL1)
/Power, USB, SPI/MISO: J1.2, U2.2 (MISO), U5.18 (ADBUS2)
/Power, USB, SPI/MOSI: J1.3, U2.5 (MOSI), U5.17 (ADBUS1)
/Power, USB, SPI/SCK: R9.2, U2.6 (SCK), U3.R11 (IOB_107_SCK), U5.16 (ADBUS0)
/Power, USB, SPI/SS: JP1.1 (A), U3.R12 (IOB_108_SS), U5.21 (ADBUS4)
/Power, USB, SPI/USB_D+: J2.3 (D+), U5.8 (DP)
/Power, USB, SPI/USB_D-: J2.2 (D-), U5.7 (DM)
/Power, USB, SPI/VBUS: J2.1 (VBUS), L3.2
/Power, USB, SPI/VCCPLL0: C2.2, C5.2, R1.1, U3.L8 (VCCPLL0)
/Power, USB, SPI/VCCPLL1: C3.1, C6.1, R2.1, U3.E8 (VCCPLL1)
/Power, USB, SPI/VPP_2V5: D16.1 (K), U3.E12 (VPP_2V5)
GND: C1.2, C4.2, C9.2, C10.2, C11.2, C12.2, C13.2, C14.2, C15.2, C16.2, C17.2, C18.2, C19.2, C20.2, C21.2, C22.2, C23.2, C24.2, C25.2, C26.1, C27.2, C28.2, C29.2, C30.2, C31.2, C32.2, C33.2, C34.2, C35.2, C36.2, C37.2, C38.2, C39.2, C40.2, C41.2, C42.2, D17.1 (K), J2.5 (GND), R8.2, R11.1, R12.2, R13.2, R20.2, R23.2, U1.5 (GND[5]), U1.6 (GND[5]), U1.15 (GND[5]), U1.16 (GND[5]), U1.21 (GND[5]), U2.4 (GND), U3.A4 (GND[18]), U3.A12 (GND[18]), U3.E15 (GND[18]), U3.G7 (GND[18]), U3.G8 (GND[18]), U3.G9 (GND[18]), U3.H7 (GND[18]), U3.H8 (GND[18]), U3.H9 (GND[18]), U3.J7 (GND[18]), U3.J8 (GND[18]), U3.J9 (GND[18]), U3.K2 (GND[18]), U3.K7 (GND[18]), U3.L15 (GND[18]), U3.R7 (GND[18]), U3.T4 (GND[18]), U3.T12 (GND[18]), U4.5 (GND), U5.1 (GND), U5.5 (GND), U5.10 (AGND), U5.11 (GND), U5.13 (TEST), U5.15 (GND), U5.25 (GND), U5.35 (GND), U5.47 (GND), U5.51 (GND), X1.2 (GND); also elsewhere on the board
unnamed: C7.2, U1.2 (BYP1)
unnamed: C8.2, U1.9 (BYP2)
unnamed: C8.1, C10.1, C13.1, L1.2, R13.1, U1.7 (OUT2[2]), U1.8 (OUT2[2]), U1.10 (ADJ2)
unnamed: C7.1, C9.1, C12.1, C15.1, L2.2, R10.1, R12.1, U1.3 (OUT1[2]), U1.4 (OUT1[2])
unnamed: D17.2 (A), R18.2
unnamed: J1.1, U3.P12 (IOB_105_SDO)
unnamed: J1.4, U3.P11 (IOB_106_SDI)
unnamed: J2.6 (Shield), R20.1
unnamed: JP1.2 (B), R5.2, U2.1 (~CS)
unnamed: R3.2, U1.12 (PWRGD2)
unnamed: R4.2, U1.19 (PWRGD1)
unnamed: R6.2, U2.7 (~HOLD)
unnamed: R7.2, U2.3 (~WP)
unnamed: R8.1, U3.N14 (NC)
unnamed: R10.2, R11.2, U1.1 (ADJ1)
unnamed: R21.2, R22.2, U4.4 (DO)
unnamed: R23.1, U5.6 (REF)
unnamed: R24.2, U5.14 (~RESET)
