msinger/gbreveng/pcb/fpgaboard/fpgaboard.kicad_pcb

## KiCad design pcb/fpgaboard/fpgaboard.kicad_pcb (continued)

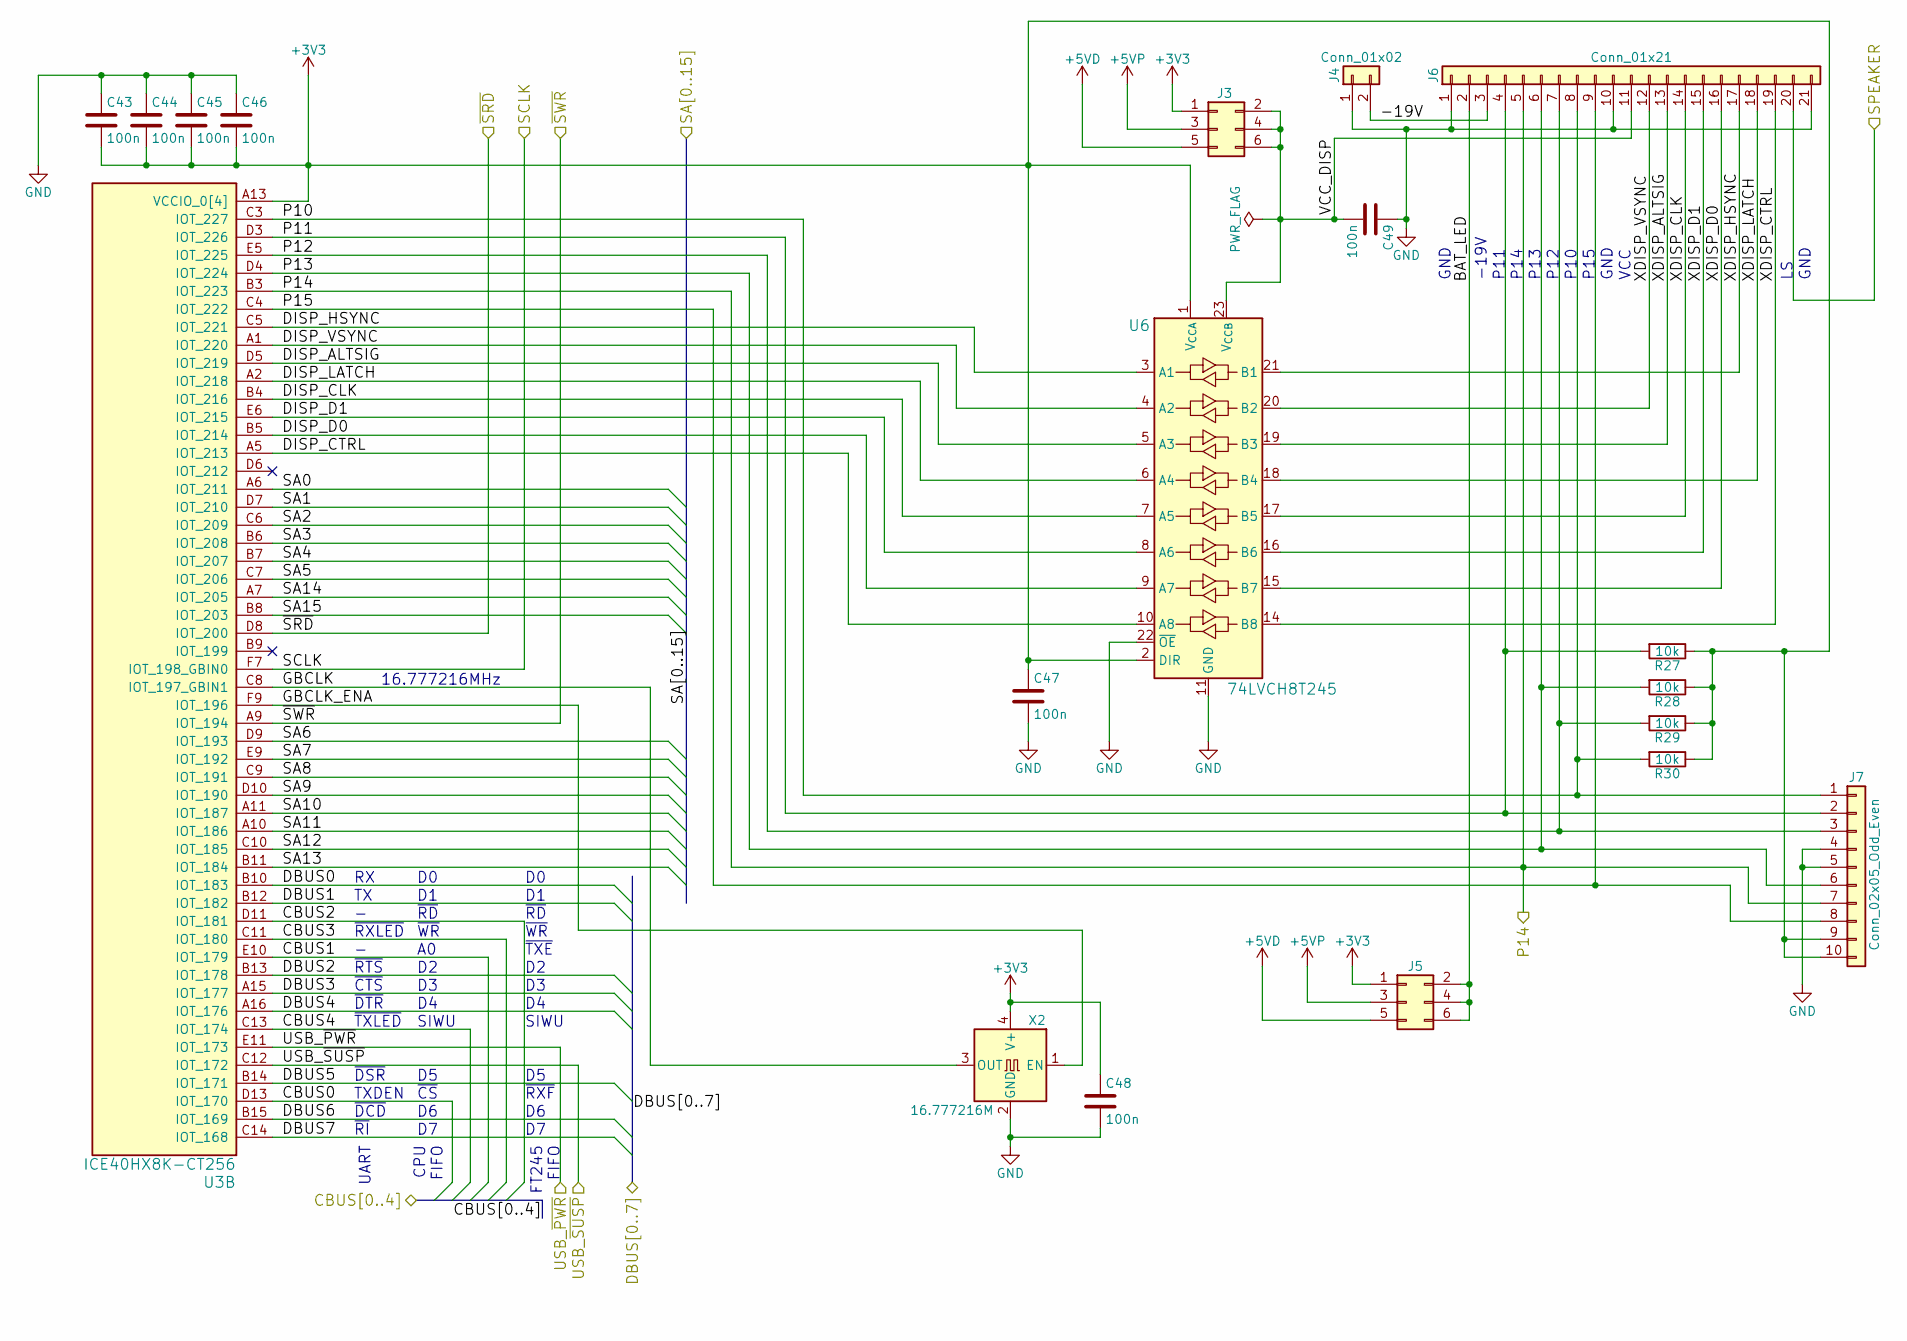
[picture p9: schematic bank0.kicad_sch, Game Boy reverse eng. FPGA board]

Parts:
C43, C44, C45, C46, C47, C48, C49: 100n; C_0402_1005Metric_Pad0.74x0.62mm_HandSolder
J3, J5: Conn_02x03_Odd_Even; PinHeader_2x03_P2.54mm_Vertical
J4: Conn_01x02; PinHeader_1x02_P2.54mm_Vertical
J6: Conn_01x21; DMG_FFC_LCD-Board_21Pin
J7: Conn_02x05_Odd_Even; PinHeader_2x05_P2.54mm_Vertical
R27, R28, R29, R30: 10k; R_0402_1005Metric
U3: ICE40HX8K-CT256; BGA-256_14.0x14.0mm_Layout16x16_P0.8mm_Ball0.45mm_Pad0.32mm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
U6: 74LVCH8T245; TSSOP-24_4.4x7.8mm_P0.65mm
X2: 16.777216M; Oscillator_SMD_EuroQuartz_XO32-4Pin_3.2x2.5mm_HandSoldering

Connections:
+3V3: C43.2, C44.2, C45.2, C46.2, C47.1, C48.1, J3.1, J5.1, J7.9, J7.10, R27.1, R28.1, R29.1, R30.1, U3.A3 (VCCIO_0[4]), U3.A8 (VCCIO_0[4]), U3.A13 (VCCIO_0[4]), U3.F8 (VCCIO_0[4]), U6.1 (V_{CCA}), U6.2 (DIR), X2.4 (V+); also elsewhere on the board
+5VD: J3.5, J5.5; also elsewhere on the board
+5VP: J3.3, J5.3; also elsewhere on the board
/Audio/SPEAKER: J6.20; also elsewhere on the board
/Bank0: Display, Keyboard, Clock/-19V: J4.2, J6.3
/Bank0: Display, Keyboard, Clock/A0: U3.A6 (IOT_211); also elsewhere on the board
/Bank0: Display, Keyboard, Clock/A1: U3.D7 (IOT_210); also elsewhere on the board
/Bank0: Display, Keyboard, Clock/A2: U3.C6 (IOT_209); also elsewhere on the board
/Bank0: Display, Keyboard, Clock/A3: U3.B6 (IOT_208); also elsewhere on the board
/Bank0: Display, Keyboard, Clock/A4: U3.B7 (IOT_207); also elsewhere on the board
/Bank0: Display, Keyboard, Clock/A5: U3.C7 (IOT_206); also elsewhere on the board
/Bank0: Display, Keyboard, Clock/A6: U3.D9 (IOT_193); also elsewhere on the board
/Bank0: Display, Keyboard, Clock/A7: U3.E9 (IOT_192); also elsewhere on the board
/Bank0: Display, Keyboard, Clock/A8: U3.C9 (IOT_191); also elsewhere on the board
/Bank0: Display, Keyboard, Clock/A9: U3.D10 (IOT_190); also elsewhere on the board
/Bank0: Display, Keyboard, Clock/A10: U3.A11 (IOT_187); also elsewhere on the board
/Bank0: Display, Keyboard, Clock/A11: U3.A10 (IOT_186); also elsewhere on the board
/Bank0: Display, Keyboard, Clock/A12: U3.C10 (IOT_185); also elsewhere on the board
/Bank0: Display, Keyboard, Clock/A13: U3.B11 (IOT_184); also elsewhere on the board
/Bank0: Display, Keyboard, Clock/A14: U3.A7 (IOT_205); also elsewhere on the board
/Bank0: Display, Keyboard, Clock/A15: U3.B8 (IOT_203); also elsewhere on the board
/Bank0: Display, Keyboard, Clock/BAT_LED: J5.2, J5.4, J5.6, J6.2
/Bank0: Display, Keyboard, Clock/CART_SL_CLK: U3.F7 (IOT_198_GBIN0); also elsewhere on the board
/Bank0: Display, Keyboard, Clock/CART_SL_~RD: U3.D8 (IOT_200); also elsewhere on the board
/Bank0: Display, Keyboard, Clock/CART_SL_~WR: U3.A9 (IOT_194); also elsewhere on the board
/Bank0: Display, Keyboard, Clock/CBUS0: U3.D13 (IOT_170); also elsewhere on the board
/Bank0: Display, Keyboard, Clock/CBUS1: U3.E10 (IOT_179); also elsewhere on the board
/Bank0: Display, Keyboard, Clock/CBUS2: U3.D11 (IOT_181); also elsewhere on the board
/Bank0: Display, Keyboard, Clock/CBUS3: U3.C11 (IOT_180); also elsewhere on the board
/Bank0: Display, Keyboard, Clock/CBUS4: U3.C13 (IOT_174); also elsewhere on the board
/Bank0: Display, Keyboard, Clock/DBUS0: U3.B10 (IOT_183); also elsewhere on the board
/Bank0: Display, Keyboard, Clock/DBUS1: U3.B12 (IOT_182); also elsewhere on the board
/Bank0: Display, Keyboard, Clock/DBUS2: U3.B13 (IOT_178); also elsewhere on the board
/Bank0: Display, Keyboard, Clock/DBUS3: U3.A15 (IOT_177); also elsewhere on the board
/Bank0: Display, Keyboard, Clock/DBUS4: U3.A16 (IOT_176); also elsewhere on the board
/Bank0: Display, Keyboard, Clock/DBUS5: U3.B14 (IOT_171); also elsewhere on the board
/Bank0: Display, Keyboard, Clock/DBUS6: U3.B15 (IOT_169); also elsewhere on the board
/Bank0: Display, Keyboard, Clock/DBUS7: U3.C14 (IOT_168); also elsewhere on the board
/Bank0: Display, Keyboard, Clock/DISP_ALTSIG: U3.D5 (IOT_219), U6.5 (A3)
/Bank0: Display, Keyboard, Clock/DISP_CLK: U3.B4 (IOT_216), U6.7 (A5)
/Bank0: Display, Keyboard, Clock/DISP_CTRL: U3.A5 (IOT_213), U6.10 (A8)
/Bank0: Display, Keyboard, Clock/DISP_D0: U3.B5 (IOT_214), U6.9 (A7)
/Bank0: Display, Keyboard, Clock/DISP_D1: U3.E6 (IOT_215), U6.8 (A6)
/Bank0: Display, Keyboard, Clock/DISP_HSYNC: U3.C5 (IOT_221), U6.3 (A1)
/Bank0: Display, Keyboard, Clock/DISP_LATCH: U3.A2 (IOT_218), U6.6 (A4)
/Bank0: Display, Keyboard, Clock/DISP_VSYNC: U3.A1 (IOT_220), U6.4 (A2)
/Bank0: Display, Keyboard, Clock/GBCLK: U3.C8 (IOT_197_GBIN1), X2.3 (OUT)
/Bank0: Display, Keyboard, Clock/GBCLK_ENA: U3.F9 (IOT_196), X2.1 (EN)
/Bank0: Display, Keyboard, Clock/P10: J6.8, J7.1, R30.2, U3.C3 (IOT_227)
/Bank0: Display, Keyboard, Clock/P11: J6.4, J7.2, R27.2, U3.D3 (IOT_226)
/Bank0: Display, Keyboard, Clock/P12: J6.7, J7.3, R29.2, U3.E5 (IOT_225)
/Bank0: Display, Keyboard, Clock/P13: J6.6, J7.6, R28.2, U3.D4 (IOT_224)
/Bank0: Display, Keyboard, Clock/P14: J6.5, J7.7, U3.B3 (IOT_223); also elsewhere on the board
/Bank0: Display, Keyboard, Clock/P15: J6.9, J7.8, U3.C4 (IOT_222)
/Bank0: Display, Keyboard, Clock/USB_~PWR: U3.E11 (IOT_173); also elsewhere on the board
/Bank0: Display, Keyboard, Clock/USB_~SUSP: U3.C12 (IOT_172); also elsewhere on the board
/Bank0: Display, Keyboard, Clock/VCC_DISP: C49.2, J3.2, J3.4, J3.6, J6.11, U6.23 (V_{CCB}), U6.24 (V_{CCB})
/Bank0: Display, Keyboard, Clock/XDISP_ALTSIG: J6.13, U6.19 (B3)
/Bank0: Display, Keyboard, Clock/XDISP_CLK: J6.14, U6.17 (B5)
/Bank0: Display, Keyboard, Clock/XDISP_CTRL: J6.19, U6.14 (B8)
/Bank0: Display, Keyboard, Clock/XDISP_D0: J6.16, U6.15 (B7)
/Bank0: Display, Keyboard, Clock/XDISP_D1: J6.15, U6.16 (B6)
/Bank0: Display, Keyboard, Clock/XDISP_HSYNC: J6.17, U6.21 (B1)
/Bank0: Display, Keyboard, Clock/XDISP_LATCH: J6.18, U6.18 (B4)
/Bank0: Display, Keyboard, Clock/XDISP_VSYNC: J6.12, U6.20 (B2)
GND: C43.1, C44.1, C45.1, C46.1, C47.2, C48.2, C49.1, J4.1, J6.1, J6.10, J6.21, J7.4, J7.5, U6.11 (GND), U6.12 (GND), U6.13 (GND), U6.22 (~OE), X2.2 (GND); also elsewhere on the board

Notes on the sheet:
~{TXLED}
~{WR}
~{RXLED}
~{RI}
CPU FIFO
SIWU
16.777216MHz
P11
P12
-19V
VCC
FT245 FIFO
GND
~{DSR}
~{RTS}
~{DCD}
~{DTR}
P14
~{CTS}
P15
UART
~{RD}
~{CS}
TXDEN
~{RXF}
~{TXE}
P13
P10

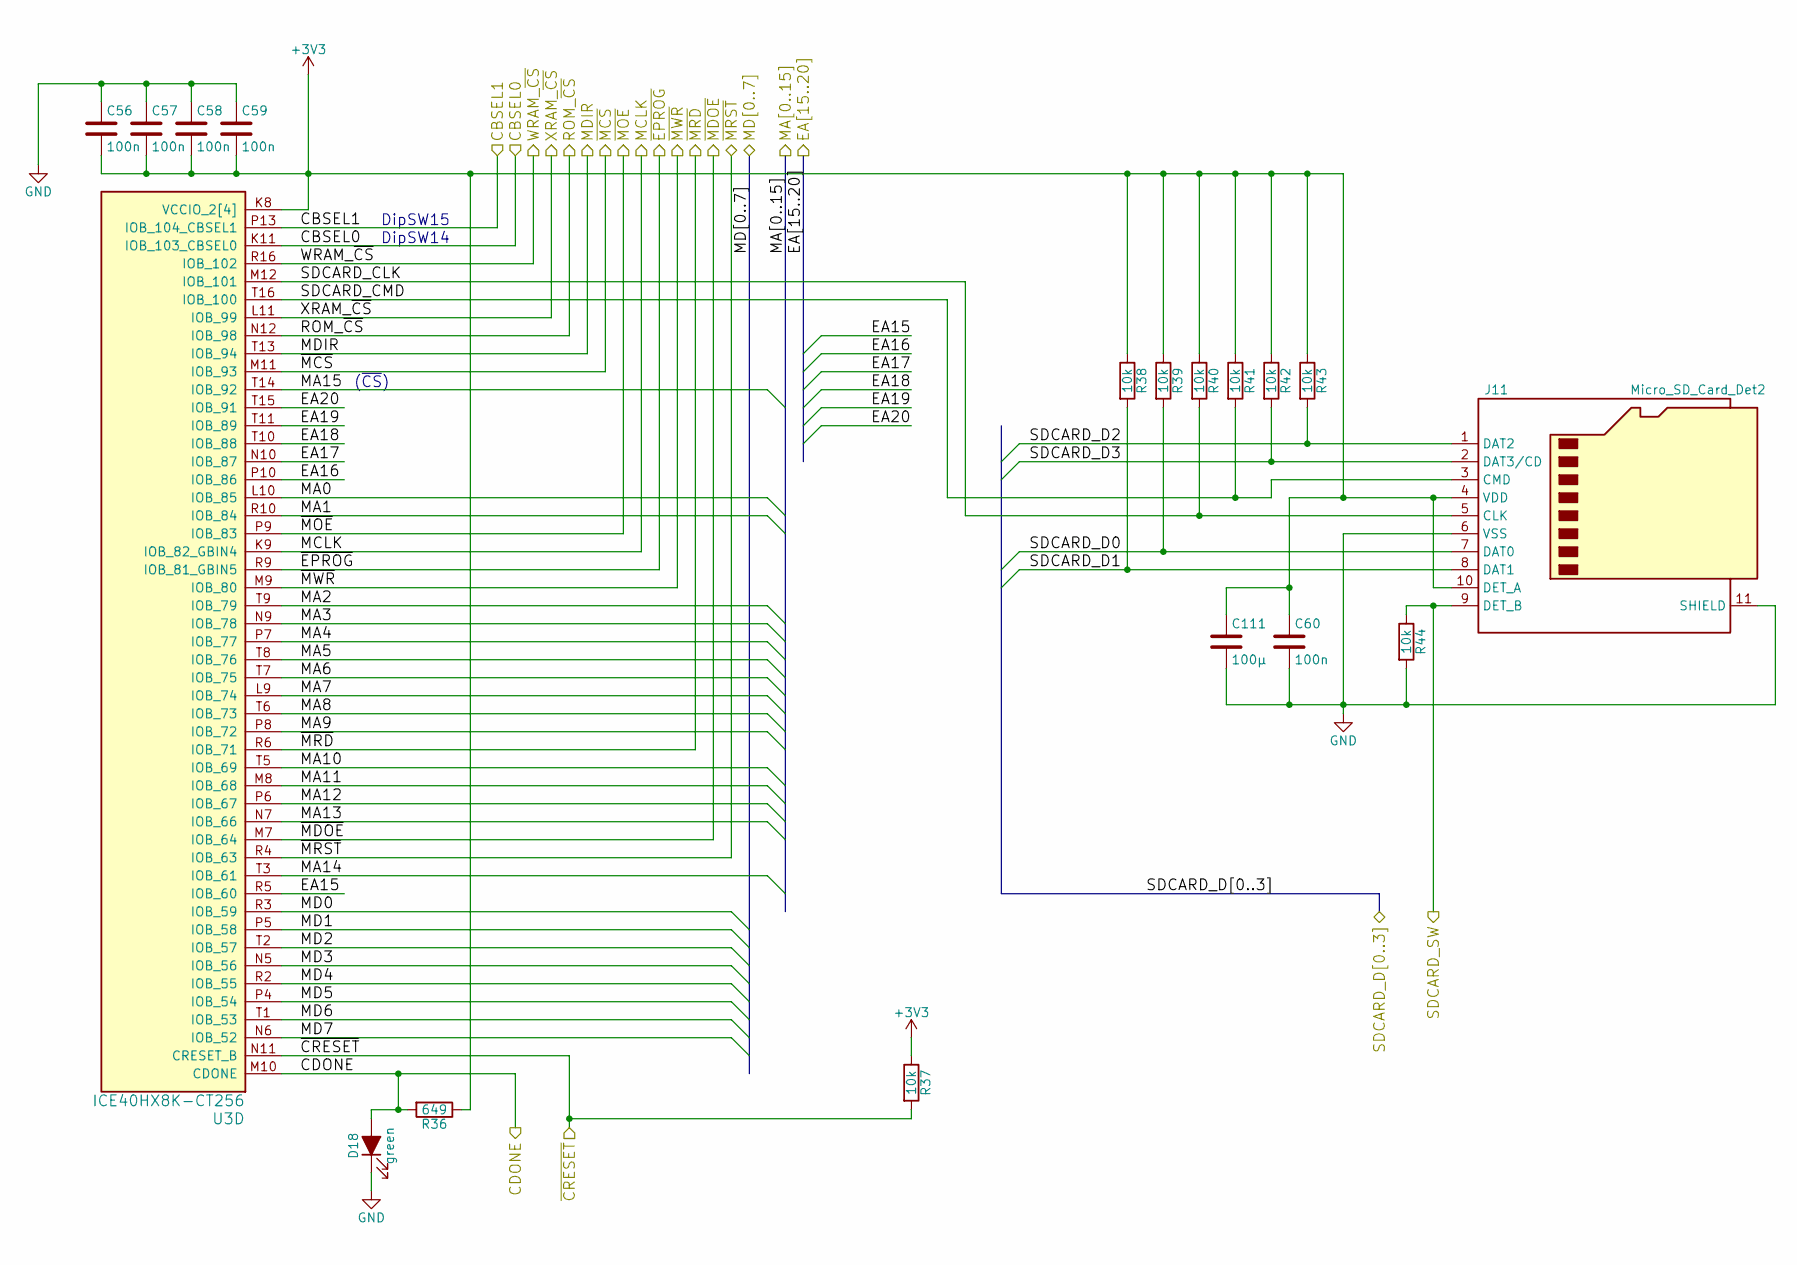
[picture p10: schematic bank2.kicad_sch, Game Boy reverse eng. FPGA board]

Parts:
C56, C57, C58, C59, C60: 100n; C_0402_1005Metric_Pad0.74x0.62mm_HandSolder
C111: 100µ; C_1206_3216Metric
D18: green; LED_0805_2012Metric_Pad1.15x1.40mm_HandSolder
J11: Micro_SD_Card_Det2; microSD_HC_Hirose_DM3AT-SF-PEJM5
R36: 649; R_0402_1005Metric
R37, R38, R39, R40, R41, R42, R43, R44: 10k; R_0402_1005Metric
U3: ICE40HX8K-CT256; BGA-256_14.0x14.0mm_Layout16x16_P0.8mm_Ball0.45mm_Pad0.32mm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

Connections:
+3V3: C56.2, C57.2, C58.2, C59.2, C60.1, C111.1, J11.4 (VDD), J11.10 (DET_A), R36.1, R37.1, R38.1, R39.1, R40.1, R41.1, R42.1, R43.1, U3.K8 (VCCIO_2[4]), U3.P3 (VCCIO_2[4]), U3.R8 (VCCIO_2[4]), U3.R13 (VCCIO_2[4]); also elsewhere on the board
/Bank1: GPIOA/SDCARD_SW: J11.9 (DET_B), R44.1; also elsewhere on the board
/Bank2: SDCard/CART_MA_CLK: U3.K9 (IOB_82_GBIN4); also elsewhere on the board
/Bank2: SDCard/CART_MA_DIR: U3.T13 (IOB_94); also elsewhere on the board
/Bank2: SDCard/CART_MA_~CS: U3.M11 (IOB_93); also elsewhere on the board
/Bank2: SDCard/CART_MA_~OE: U3.P9 (IOB_83); also elsewhere on the board
/Bank2: SDCard/CART_MA_~OE~_DATA: U3.M7 (IOB_64); also elsewhere on the board
/Bank2: SDCard/CART_MA_~RST: U3.R4 (IOB_63); also elsewhere on the board
/Bank2: SDCard/CBSEL0: U3.K11 (IOB_103_CBSEL0); also elsewhere on the board
/Bank2: SDCard/CBSEL1: U3.P13 (IOB_104_CBSEL1); also elsewhere on the board
/Bank2: SDCard/CDONE: D18.2 (A), R36.2, U3.M10 (CDONE); also elsewhere on the board
/Bank2: SDCard/EA15: U3.R5 (IOB_60); also elsewhere on the board
/Bank2: SDCard/EA16: U3.P10 (IOB_86); also elsewhere on the board
/Bank2: SDCard/EA17: U3.N10 (IOB_87); also elsewhere on the board
/Bank2: SDCard/EA18: U3.T10 (IOB_88); also elsewhere on the board
/Bank2: SDCard/EA19: U3.T11 (IOB_89); also elsewhere on the board
/Bank2: SDCard/EA20: U3.T15 (IOB_91); also elsewhere on the board
/Bank2: SDCard/MA0: U3.L10 (IOB_85); also elsewhere on the board
/Bank2: SDCard/MA1: U3.R10 (IOB_84); also elsewhere on the board
/Bank2: SDCard/MA2: U3.T9 (IOB_79); also elsewhere on the board
/Bank2: SDCard/MA3: U3.N9 (IOB_78); also elsewhere on the board
/Bank2: SDCard/MA4: U3.P7 (IOB_77); also elsewhere on the board
/Bank2: SDCard/MA5: U3.T8 (IOB_76); also elsewhere on the board
/Bank2: SDCard/MA6: U3.T7 (IOB_75); also elsewhere on the board
/Bank2: SDCard/MA7: U3.L9 (IOB_74); also elsewhere on the board
/Bank2: SDCard/MA8: U3.T6 (IOB_73); also elsewhere on the board
/Bank2: SDCard/MA9: U3.P8 (IOB_72); also elsewhere on the board
/Bank2: SDCard/MA10: U3.T5 (IOB_69); also elsewhere on the board
/Bank2: SDCard/MA11: U3.M8 (IOB_68); also elsewhere on the board
/Bank2: SDCard/MA12: U3.P6 (IOB_67); also elsewhere on the board
/Bank2: SDCard/MA13: U3.N7 (IOB_66); also elsewhere on the board
/Bank2: SDCard/MA14: U3.T3 (IOB_61); also elsewhere on the board
/Bank2: SDCard/MA15: U3.T14 (IOB_92); also elsewhere on the board
/Bank2: SDCard/MD0: U3.R3 (IOB_59); also elsewhere on the board
/Bank2: SDCard/MD1: U3.P5 (IOB_58); also elsewhere on the board
/Bank2: SDCard/MD2: U3.T2 (IOB_57); also elsewhere on the board
/Bank2: SDCard/MD3: U3.N5 (IOB_56); also elsewhere on the board
/Bank2: SDCard/MD4: U3.R2 (IOB_55); also elsewhere on the board
/Bank2: SDCard/MD5: U3.P4 (IOB_54); also elsewhere on the board
/Bank2: SDCard/MD6: U3.T1 (IOB_53); also elsewhere on the board
/Bank2: SDCard/MD7: U3.N6 (IOB_52); also elsewhere on the board
/Bank2: SDCard/ONBRD_~PROG: U3.R9 (IOB_81_GBIN5); also elsewhere on the board
/Bank2: SDCard/ROM_~CS: U3.N12 (IOB_98); also elsewhere on the board
/Bank2: SDCard/SD0: J11.7 (DAT0), R39.2; also elsewhere on the board
/Bank2: SDCard/SD1: J11.8 (DAT1), R38.2; also elsewhere on the board
/Bank2: SDCard/SD2: J11.1 (DAT2), R43.2; also elsewhere on the board
/Bank2: SDCard/SD3: J11.2 (DAT3/CD), R42.2; also elsewhere on the board
/Bank2: SDCard/SDCARD_CLK: J11.5 (CLK), R40.2, U3.M12 (IOB_101)
/Bank2: SDCard/SDCARD_CMD: J11.3 (CMD), R41.2, U3.T16 (IOB_100)
/Bank2: SDCard/WRAM_~CS: U3.R16 (IOB_102); also elsewhere on the board
/Bank2: SDCard/XRAM_~CS: U3.L11 (IOB_99); also elsewhere on the board
/Bank2: SDCard/~CRESET: R37.2, U3.N11 (CRESET_B); also elsewhere on the board
/~MRD: U3.R6 (IOB_71); also elsewhere on the board
/~MWR: U3.M9 (IOB_80); also elsewhere on the board
GND: C56.1, C57.1, C58.1, C59.1, C60.2, C111.2, D18.1 (K), J11.6 (VSS), J11.11 (SHIELD), R44.2; also elsewhere on the board

Notes on the sheet:
DipSW14
(~{CS})
DipSW15

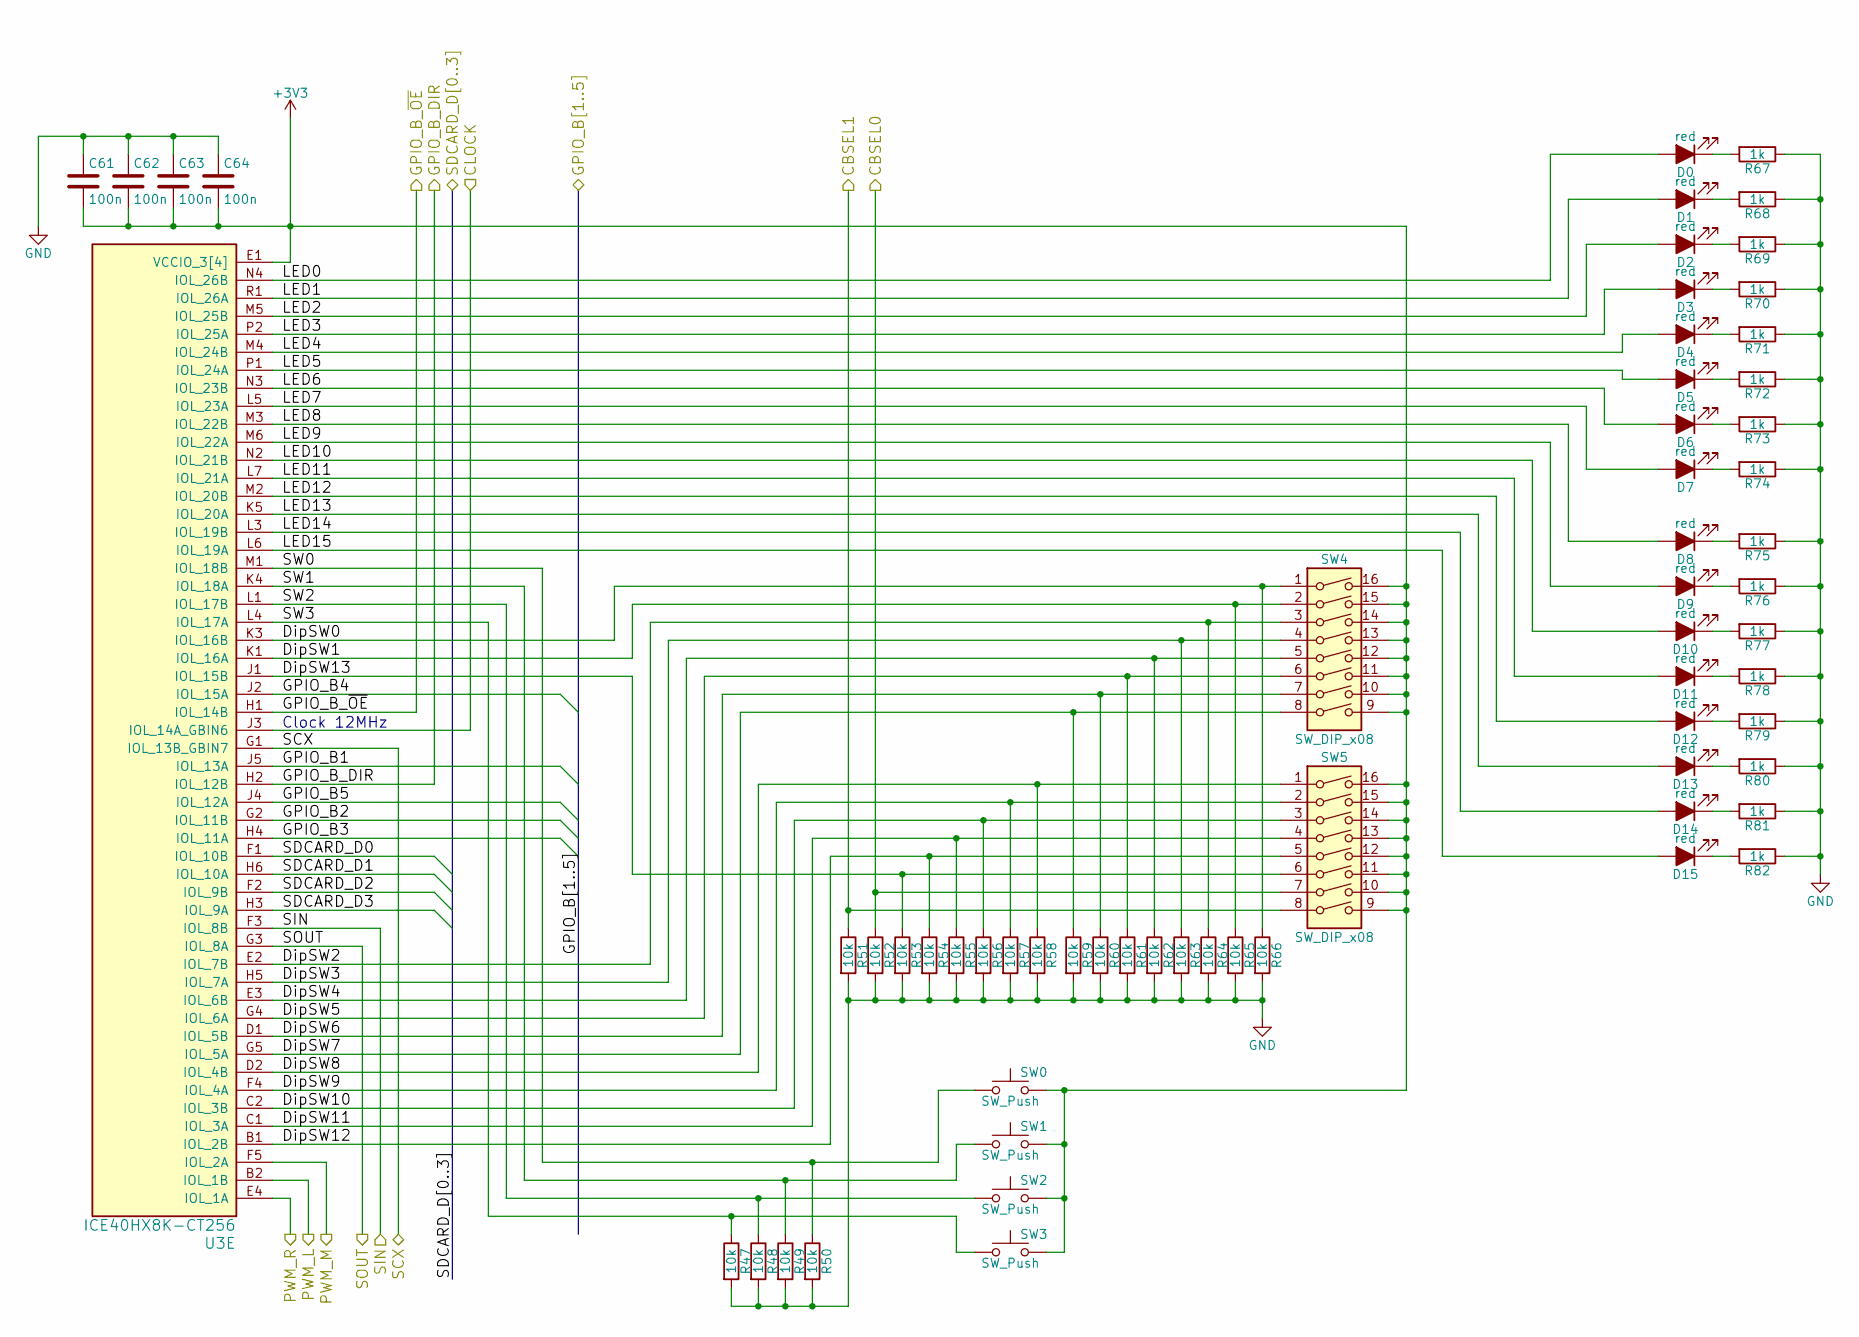
[picture p11: schematic bank3.kicad_sch, Game Boy reverse eng. FPGA board]

Parts:
C61, C62, C63, C64: 100n; C_0402_1005Metric_Pad0.74x0.62mm_HandSolder
D0, D1, D2, D3, D4, D5, D6, D7, D8, D9, D10, D11, D12, D13, D14, D15: red; LED_0805_2012Metric_Pad1.15x1.40mm_HandSolder
R47, R48, R49, R50, R51, R52, R53, R54, R55, R56, R57, R58, R59, R60, R61, R62, R63, R64, R65, R66: 10k; R_0402_1005Metric
R67, R68, R69, R70, R71, R72, R73, R74, R75, R76, R77, R78, R79, R80, R81, R82: 1k; R_0402_1005Metric
SW0, SW1, SW2, SW3: SW_Push; SW_SPST_B3U-1000P-B
SW4, SW5: SW_DIP_x08; SW_DIP_SPSTx08_Slide_9.78x22.5mm_W7.62mm_P2.54mm
U3: ICE40HX8K-CT256; BGA-256_14.0x14.0mm_Layout16x16_P0.8mm_Ball0.45mm_Pad0.32mm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

Connections:
+3V3: C61.2, C62.2, C63.2, C64.2, SW0.2, SW1.2, SW2.2, SW3.2, SW4.9, SW4.10, SW4.11, SW4.12, SW4.13, SW4.14, SW4.15, SW4.16, SW5.9, SW5.10, SW5.11, SW5.12, SW5.13, SW5.14, SW5.15, SW5.16, U3.E1 (VCCIO_3[4]), U3.G6 (VCCIO_3[4]), U3.J6 (VCCIO_3[4]), U3.N1 (VCCIO_3[4]); also elsewhere on the board
/Audio/PWM_L: U3.B2 (IOL_1B); also elsewhere on the board
/Audio/PWM_M: U3.F5 (IOL_2A); also elsewhere on the board
/Audio/PWM_R: U3.E4 (IOL_1A); also elsewhere on the board
/Bank2: SDCard/CBSEL0: R52.1, SW5.7; also elsewhere on the board
/Bank2: SDCard/CBSEL1: R51.1, SW5.8; also elsewhere on the board
/Bank2: SDCard/SD0: U3.F1 (IOL_10B); also elsewhere on the board
/Bank2: SDCard/SD1: U3.H6 (IOL_10A); also elsewhere on the board
/Bank2: SDCard/SD2: U3.F2 (IOL_9B); also elsewhere on the board
/Bank2: SDCard/SD3: U3.H3 (IOL_9A); also elsewhere on the board
/Bank3: LEDs, Switches/CLOCK: U3.J3 (IOL_14A_GBIN6); also elsewhere on the board
/Bank3: LEDs, Switches/DipSW0: R66.1, SW4.1, U3.K3 (IOL_16B)
/Bank3: LEDs, Switches/DipSW1: R65.1, SW4.2, U3.K1 (IOL_16A)
/Bank3: LEDs, Switches/DipSW2: R64.1, SW4.3, U3.E2 (IOL_7B)
/Bank3: LEDs, Switches/DipSW3: R63.1, SW4.4, U3.H5 (IOL_7A)
/Bank3: LEDs, Switches/DipSW4: R62.1, SW4.5, U3.E3 (IOL_6B)
/Bank3: LEDs, Switches/DipSW5: R61.1, SW4.6, U3.G4 (IOL_6A)
/Bank3: LEDs, Switches/DipSW6: R60.1, SW4.7, U3.D1 (IOL_5B)
/Bank3: LEDs, Switches/DipSW7: R59.1, SW4.8, U3.G5 (IOL_5A)
/Bank3: LEDs, Switches/DipSW8: R58.1, SW5.1, U3.D2 (IOL_4B)
/Bank3: LEDs, Switches/DipSW9: R57.1, SW5.2, U3.F4 (IOL_4A)
/Bank3: LEDs, Switches/DipSW10: R56.1, SW5.3, U3.C2 (IOL_3B)
/Bank3: LEDs, Switches/DipSW11: R55.1, SW5.4, U3.C1 (IOL_3A)
/Bank3: LEDs, Switches/DipSW12: R54.1, SW5.5, U3.B1 (IOL_2B)
/Bank3: LEDs, Switches/DipSW13: R53.1, SW5.6, U3.J1 (IOL_15B)
/Bank3: LEDs, Switches/GPIO_B1: U3.J5 (IOL_13A); also elsewhere on the board
/Bank3: LEDs, Switches/GPIO_B2: U3.G2 (IOL_11B); also elsewhere on the board
/Bank3: LEDs, Switches/GPIO_B3: U3.H4 (IOL_11A); also elsewhere on the board
/Bank3: LEDs, Switches/GPIO_B4: U3.J2 (IOL_15A); also elsewhere on the board
/Bank3: LEDs, Switches/GPIO_B5: U3.J4 (IOL_12A); also elsewhere on the board
/Bank3: LEDs, Switches/GPIO_B_~OE: U3.H1 (IOL_14B); also elsewhere on the board
/Bank3: LEDs, Switches/LED0: D0.2 (A), U3.N4 (IOL_26B)
/Bank3: LEDs, Switches/LED1: D1.2 (A), U3.R1 (IOL_26A)
/Bank3: LEDs, Switches/LED2: D2.2 (A), U3.M5 (IOL_25B)
/Bank3: LEDs, Switches/LED3: D3.2 (A), U3.P2 (IOL_25A)
/Bank3: LEDs, Switches/LED4: D4.2 (A), U3.M4 (IOL_24B)
/Bank3: LEDs, Switches/LED5: D5.2 (A), U3.P1 (IOL_24A)
/Bank3: LEDs, Switches/LED6: D6.2 (A), U3.N3 (IOL_23B)
/Bank3: LEDs, Switches/LED7: D7.2 (A), U3.L5 (IOL_23A)
/Bank3: LEDs, Switches/LED8: D8.2 (A), U3.M3 (IOL_22B)
/Bank3: LEDs, Switches/LED9: D9.2 (A), U3.M6 (IOL_22A)
/Bank3: LEDs, Switches/LED10: D10.2 (A), U3.N2 (IOL_21B)
/Bank3: LEDs, Switches/LED11: D11.2 (A), U3.L7 (IOL_21A)
/Bank3: LEDs, Switches/LED12: D12.2 (A), U3.M2 (IOL_20B)
/Bank3: LEDs, Switches/LED13: D13.2 (A), U3.K5 (IOL_20A)
/Bank3: LEDs, Switches/LED14: D14.2 (A), U3.L3 (IOL_19B)
/Bank3: LEDs, Switches/LED15: D15.2 (A), U3.L6 (IOL_19A)
/Bank3: LEDs, Switches/SCX: U3.G1 (IOL_13B_GBIN7); also elsewhere on the board
/Bank3: LEDs, Switches/SOUT: U3.G3 (IOL_8A); also elsewhere on the board
/Bank3: LEDs, Switches/SW0: R50.1, SW0.1, U3.M1 (IOL_18B)
/Bank3: LEDs, Switches/SW1: R49.1, SW1.1, U3.K4 (IOL_18A)
/Bank3: LEDs, Switches/SW2: R48.1, SW2.1, U3.L1 (IOL_17B)
/Bank3: LEDs, Switches/SW3: R47.1, SW3.1, U3.L4 (IOL_17A)
/External Link Port, GPIOB/DIR: U3.H2 (IOL_12B); also elsewhere on the board
/SIN: U3.F3 (IOL_8B); also elsewhere on the board
GND: C61.1, C62.1, C63.1, C64.1, R47.2, R48.2, R49.2, R50.2, R51.2, R52.2, R53.2, R54.2, R55.2, R56.2, R57.2, R58.2, R59.2, R60.2, R61.2, R62.2, R63.2, R64.2, R65.2, R66.2, R67.1, R68.1, R69.1, R70.1, R71.1, R72.1, R73.1, R74.1, R75.1, R76.1, R77.1, R78.1, R79.1, R80.1, R81.1, R82.1; also elsewhere on the board
unnamed: D0.1 (K), R67.2
unnamed: D1.1 (K), R68.2
unnamed: D2.1 (K), R69.2
unnamed: D3.1 (K), R70.2
unnamed: D4.1 (K), R71.2
unnamed: D5.1 (K), R72.2
unnamed: D6.1 (K), R73.2
unnamed: D7.1 (K), R74.2
unnamed: D8.1 (K), R75.2
unnamed: D9.1 (K), R76.2
unnamed: D10.1 (K), R77.2
unnamed: D11.1 (K), R78.2
unnamed: D12.1 (K), R79.2
unnamed: D13.1 (K), R80.2
unnamed: D14.1 (K), R81.2
unnamed: D15.1 (K), R82.2

Notes on the sheet:
Clock 12MHz

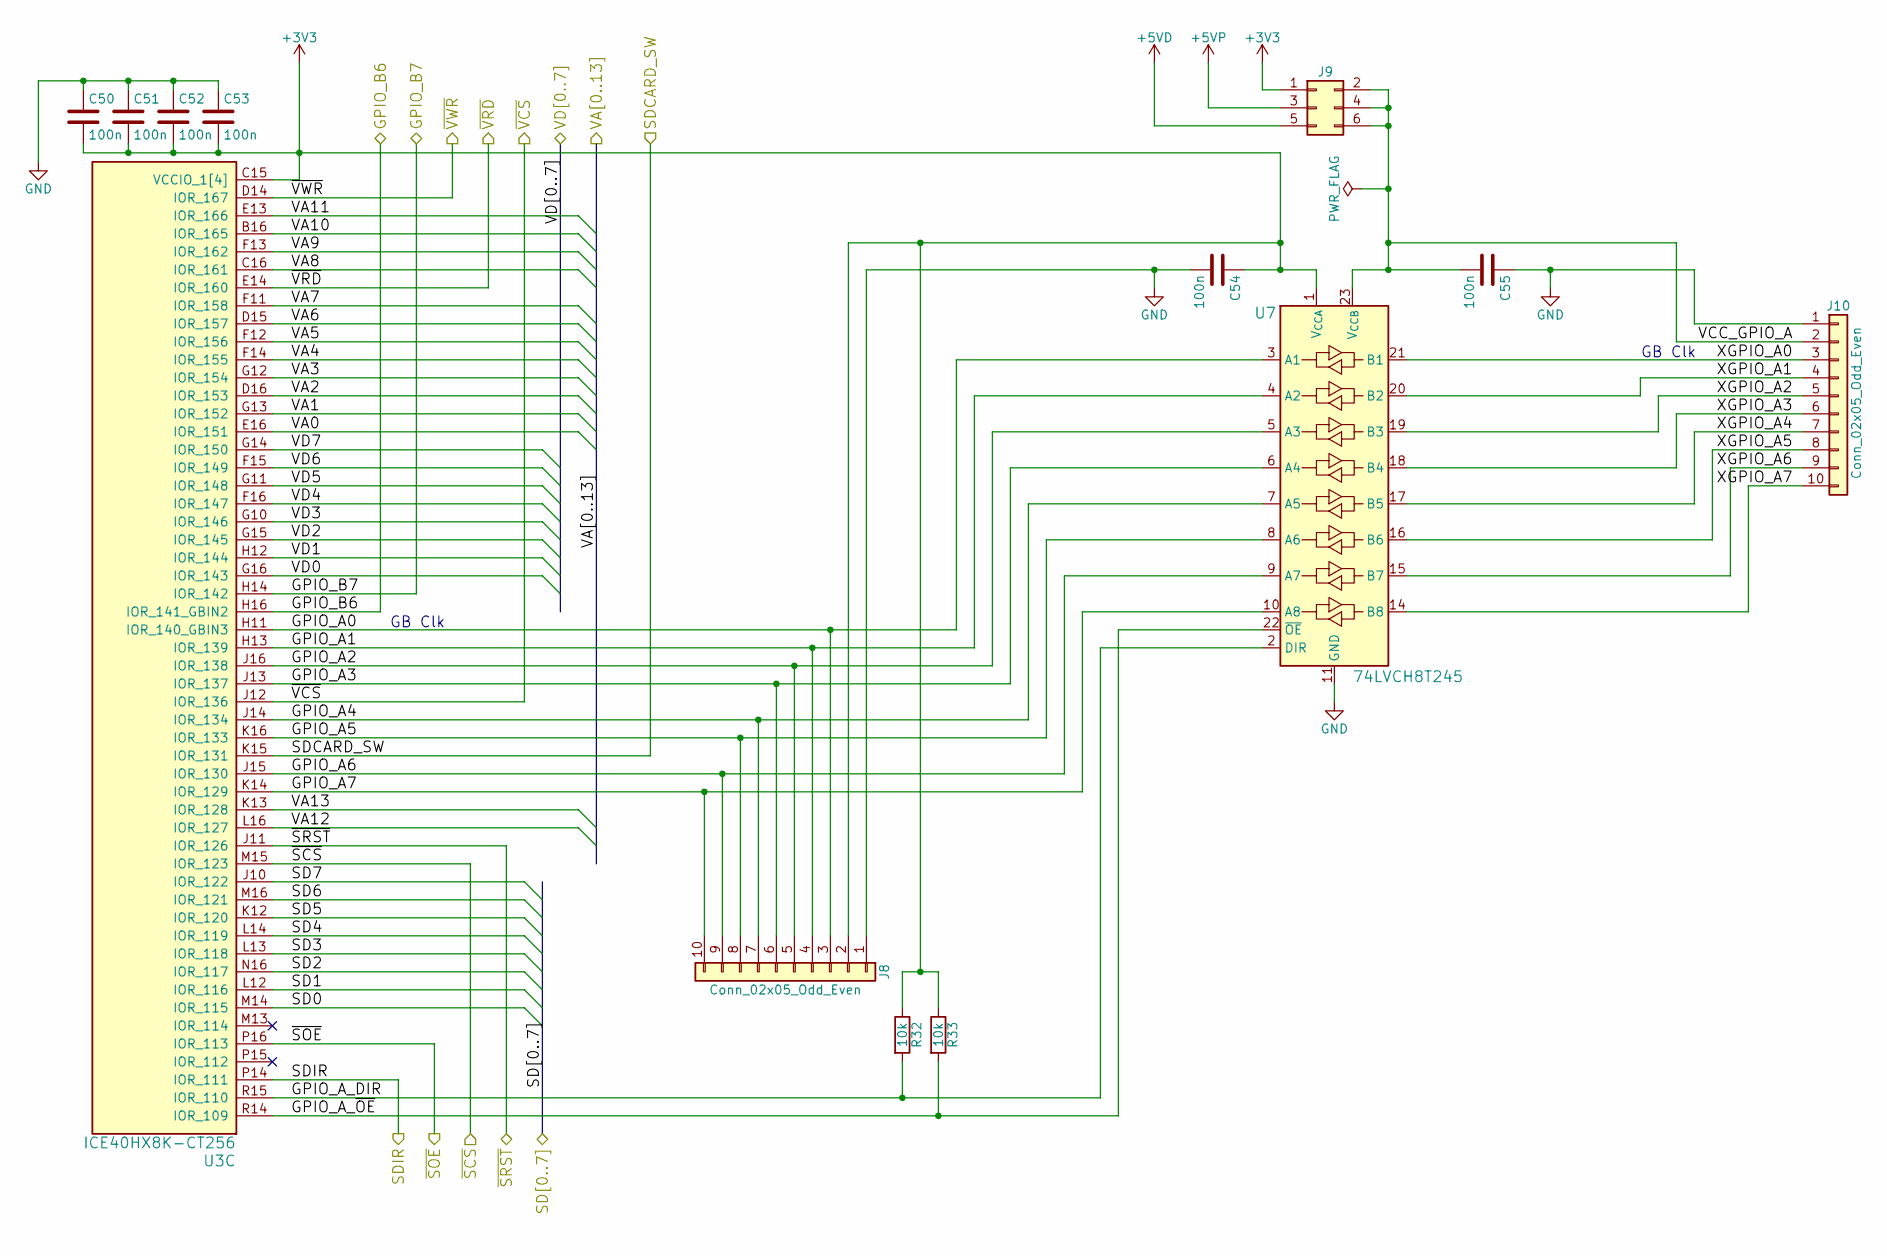
[picture p12: schematic bank1.kicad_sch, Game Boy reverse eng. FPGA board]

Parts:
C50, C51, C52, C53, C54, C55: 100n; C_0402_1005Metric_Pad0.74x0.62mm_HandSolder
J8, J10: Conn_02x05_Odd_Even; PinHeader_2x05_P2.54mm_Vertical
J9: Conn_02x03_Odd_Even; PinHeader_2x03_P2.54mm_Vertical
R32, R33: 10k; R_0402_1005Metric
U3: ICE40HX8K-CT256; BGA-256_14.0x14.0mm_Layout16x16_P0.8mm_Ball0.45mm_Pad0.32mm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
U7: 74LVCH8T245; TSSOP-24_4.4x7.8mm_P0.65mm

Connections:
+3V3: C50.2, C51.2, C52.2, C53.2, C54.1, J8.2, J9.1, R32.1, R33.1, U3.C15 (VCCIO_1[4]), U3.H10 (VCCIO_1[4]), U3.H15 (VCCIO_1[4]), U3.N15 (VCCIO_1[4]), U7.1 (V_{CCA}); also elsewhere on the board
+5VD: J9.5; also elsewhere on the board
+5VP: J9.3; also elsewhere on the board
/Bank1: GPIOA/CART_SL_DIR: U3.P14 (IOR_111); also elsewhere on the board
/Bank1: GPIOA/CART_SL_~CS: U3.M15 (IOR_123); also elsewhere on the board
/Bank1: GPIOA/CART_SL_~OE: U3.P16 (IOR_113); also elsewhere on the board
/Bank1: GPIOA/CART_SL_~RST: U3.J11 (IOR_126); also elsewhere on the board
/Bank1: GPIOA/D0: U3.M14 (IOR_115); also elsewhere on the board
/Bank1: GPIOA/D1: U3.L12 (IOR_116); also elsewhere on the board
/Bank1: GPIOA/D2: U3.N16 (IOR_117); also elsewhere on the board
/Bank1: GPIOA/D3: U3.L13 (IOR_118); also elsewhere on the board
/Bank1: GPIOA/D4: U3.L14 (IOR_119); also elsewhere on the board
/Bank1: GPIOA/D5: U3.K12 (IOR_120); also elsewhere on the board
/Bank1: GPIOA/D6: U3.M16 (IOR_121); also elsewhere on the board
/Bank1: GPIOA/D7: U3.J10 (IOR_122); also elsewhere on the board
/Bank1: GPIOA/GPIO_A0: J8.3, U3.H11 (IOR_140_GBIN3), U7.3 (A1)
/Bank1: GPIOA/GPIO_A1: J8.4, U3.H13 (IOR_139), U7.4 (A2)
/Bank1: GPIOA/GPIO_A2: J8.5, U3.J16 (IOR_138), U7.5 (A3)
/Bank1: GPIOA/GPIO_A3: J8.6, U3.J13 (IOR_137), U7.6 (A4)
/Bank1: GPIOA/GPIO_A4: J8.7, U3.J14 (IOR_134), U7.7 (A5)
/Bank1: GPIOA/GPIO_A5: J8.8, U3.K16 (IOR_133), U7.8 (A6)
/Bank1: GPIOA/GPIO_A6: J8.9, U3.J15 (IOR_130), U7.9 (A7)
/Bank1: GPIOA/GPIO_A7: J8.10, U3.K14 (IOR_129), U7.10 (A8)
/Bank1: GPIOA/GPIO_A_DIR: R32.2, U3.R15 (IOR_110), U7.2 (DIR)
/Bank1: GPIOA/GPIO_A_~OE: R33.2, U3.R14 (IOR_109), U7.22 (~OE)
/Bank1: GPIOA/SDCARD_SW: U3.K15 (IOR_131); also elsewhere on the board
/Bank1: GPIOA/VA0: U3.E16 (IOR_151); also elsewhere on the board
/Bank1: GPIOA/VA1: U3.G13 (IOR_152); also elsewhere on the board
/Bank1: GPIOA/VA2: U3.D16 (IOR_153); also elsewhere on the board
/Bank1: GPIOA/VA3: U3.G12 (IOR_154); also elsewhere on the board
/Bank1: GPIOA/VA4: U3.F14 (IOR_155); also elsewhere on the board
/Bank1: GPIOA/VA5: U3.F12 (IOR_156); also elsewhere on the board
/Bank1: GPIOA/VA6: U3.D15 (IOR_157); also elsewhere on the board
/Bank1: GPIOA/VA7: U3.F11 (IOR_158); also elsewhere on the board
/Bank1: GPIOA/VA8: U3.C16 (IOR_161); also elsewhere on the board
/Bank1: GPIOA/VA9: U3.F13 (IOR_162); also elsewhere on the board
/Bank1: GPIOA/VA10: U3.B16 (IOR_165); also elsewhere on the board
/Bank1: GPIOA/VA11: U3.E13 (IOR_166); also elsewhere on the board
/Bank1: GPIOA/VA12: U3.L16 (IOR_127); also elsewhere on the board
/Bank1: GPIOA/VA13: U3.K13 (IOR_128); also elsewhere on the board
/Bank1: GPIOA/VCC_GPIO_A: C55.2, J9.2, J9.4, J9.6, J10.2, U7.23 (V_{CCB}), U7.24 (V_{CCB})
/Bank1: GPIOA/VD0: U3.G16 (IOR_143); also elsewhere on the board
/Bank1: GPIOA/VD1: U3.H12 (IOR_144); also elsewhere on the board
/Bank1: GPIOA/VD2: U3.G15 (IOR_145); also elsewhere on the board
/Bank1: GPIOA/VD3: U3.G10 (IOR_146); also elsewhere on the board
/Bank1: GPIOA/VD4: U3.F16 (IOR_147); also elsewhere on the board
/Bank1: GPIOA/VD5: U3.G11 (IOR_148); also elsewhere on the board
/Bank1: GPIOA/VD6: U3.F15 (IOR_149); also elsewhere on the board
/Bank1: GPIOA/VD7: U3.G14 (IOR_150); also elsewhere on the board
/Bank1: GPIOA/XGPIO_A0: J10.3, U7.21 (B1)
/Bank1: GPIOA/XGPIO_A1: J10.4, U7.20 (B2)
/Bank1: GPIOA/XGPIO_A2: J10.5, U7.19 (B3)
/Bank1: GPIOA/XGPIO_A3: J10.6, U7.18 (B4)
/Bank1: GPIOA/XGPIO_A4: J10.7, U7.17 (B5)
/Bank1: GPIOA/XGPIO_A5: J10.8, U7.16 (B6)
/Bank1: GPIOA/XGPIO_A6: J10.9, U7.15 (B7)
/Bank1: GPIOA/XGPIO_A7: J10.10, U7.14 (B8)
/GPIO_B6: U3.H16 (IOR_141_GBIN2); also elsewhere on the board
/GPIO_B7: U3.H14 (IOR_142); also elsewhere on the board
/~VCS: U3.J12 (IOR_136); also elsewhere on the board
/~VRD: U3.E14 (IOR_160); also elsewhere on the board
/~VWR: U3.D14 (IOR_167); also elsewhere on the board
GND: C50.1, C51.1, C52.1, C53.1, C54.2, C55.1, J8.1, J10.1, U7.11 (GND), U7.12 (GND), U7.13 (GND); also elsewhere on the board

Notes on the sheet:
GB Clk
