msinger/gbreveng/pcb/fpgaboard/fpgaboard.kicad_pcb

## KiCad design pcb/fpgaboard/fpgaboard.kicad_pcb (continued)

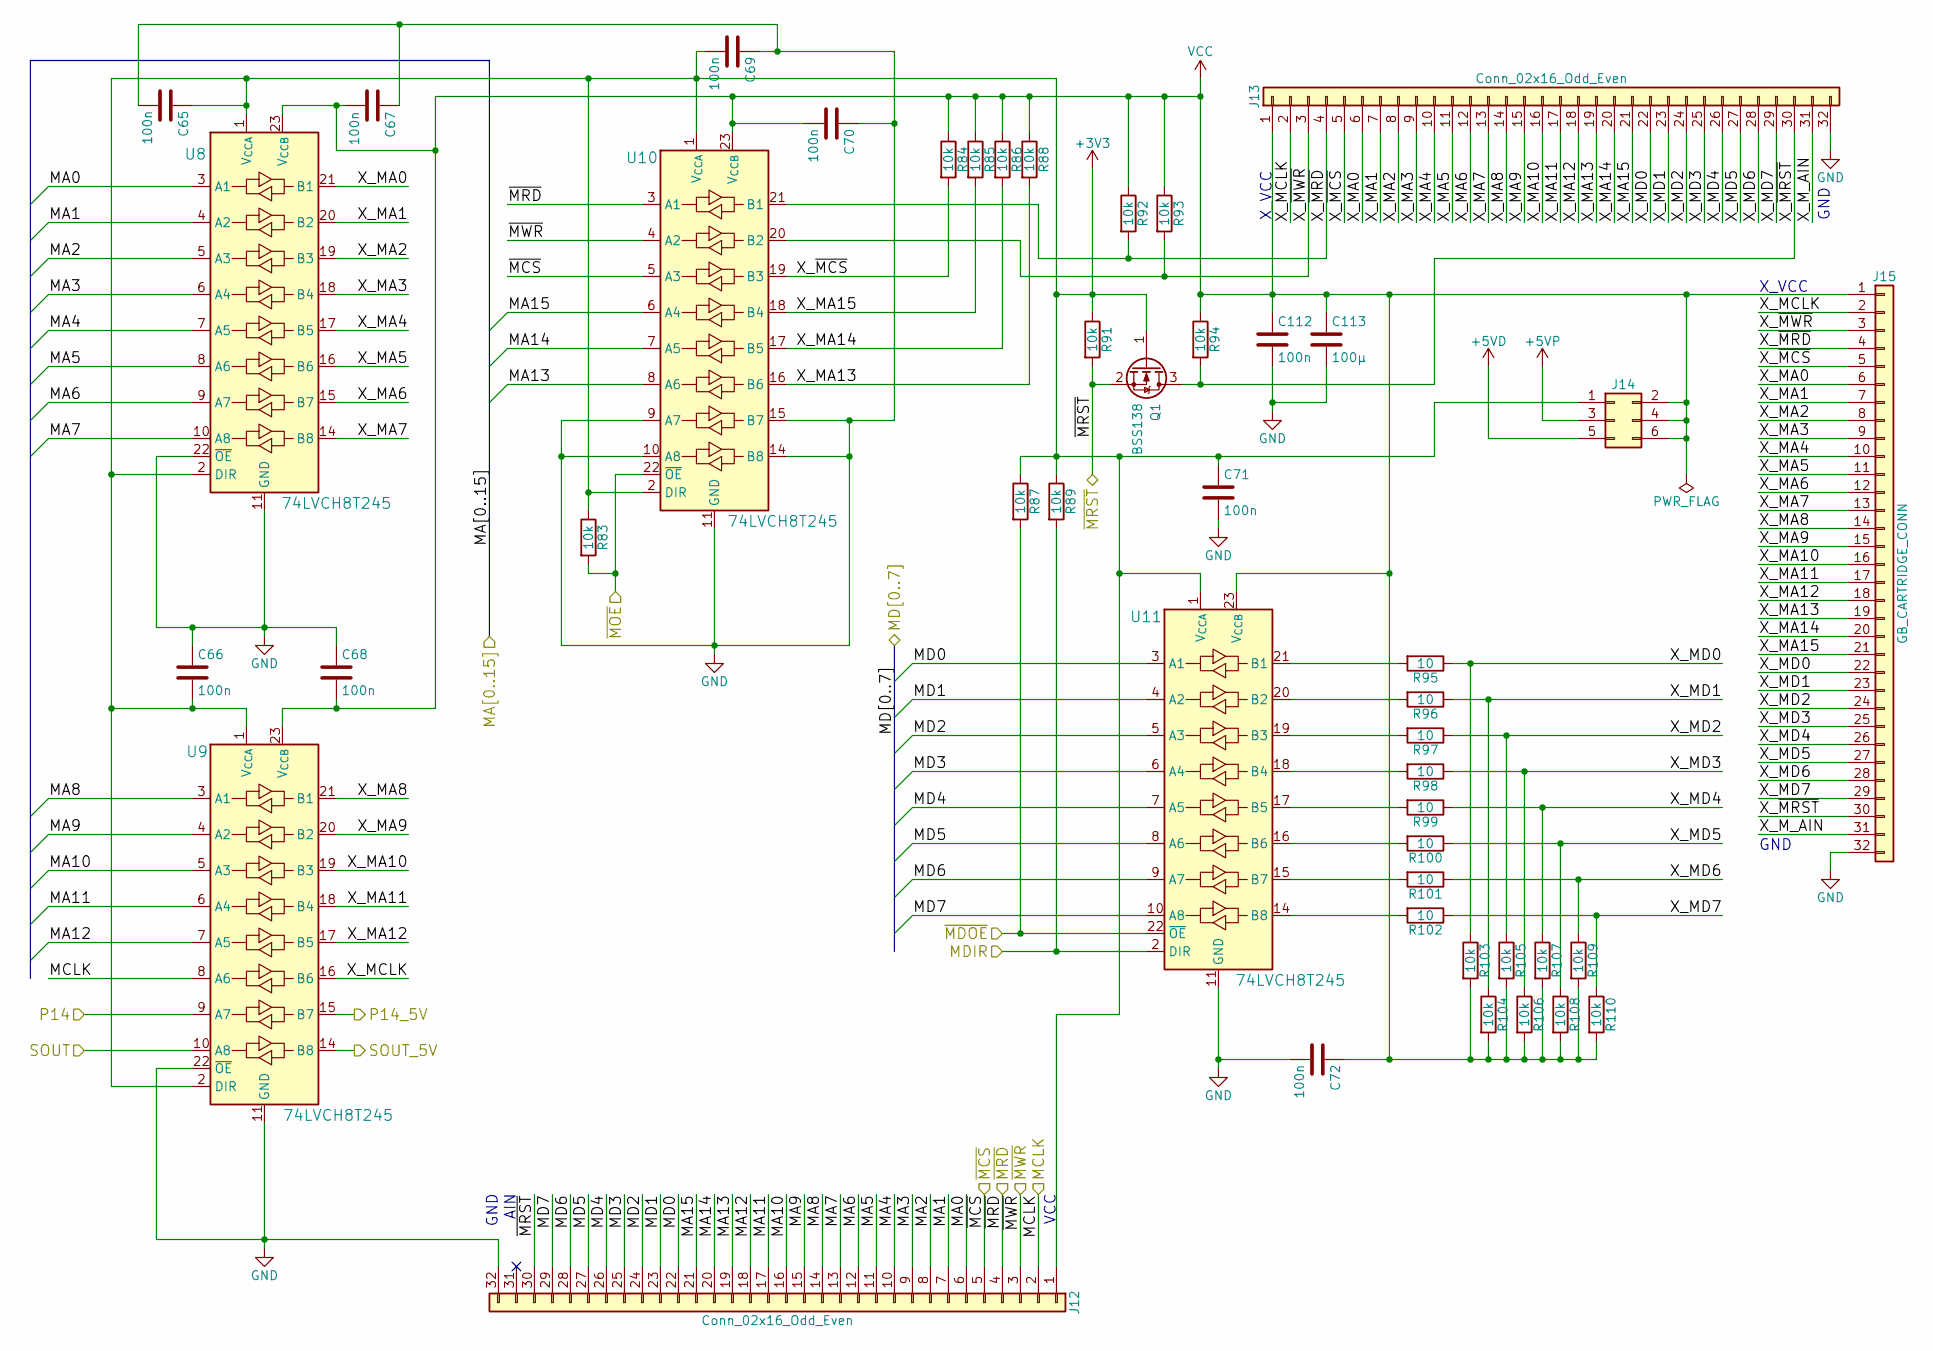
[picture p13: schematic cart_ma.kicad_sch, Game Boy reverse eng. FPGA board]

Parts:
C65, C66, C67, C68, C69, C70, C71, C72, C112: 100n; C_0402_1005Metric_Pad0.74x0.62mm_HandSolder
C113: 100µ; C_1206_3216Metric
J12, J13: Conn_02x16_Odd_Even; PinHeader_2x16_P2.54mm_Vertical
J14: Conn_02x03_Odd_Even; PinHeader_2x03_P2.54mm_Vertical
J15: GB_CARTRIDGE_CONN; Cartridge_Socket_SMD
Q1: BSS138; SOT-323_SC-70
R83, R84, R85, R86, R87, R88, R89, R91, R92, R93, R94, R103, R104, R105, R106, R107, R108, R109, R110: 10k; R_0402_1005Metric
R95, R96, R97, R98, R99, R100, R101, R102: 10; R_0603_1608Metric
U8, U9, U10, U11: 74LVCH8T245; TSSOP-24_4.4x7.8mm_P0.65mm

Connections:
+3V3: C65.1, C66.2, C69.2, C71.1, J12.1, J14.1, Q1.1 (G), R83.1, R87.1, R89.1, R91.1, U8.1 (V_{CCA}), U8.2 (DIR), U9.1 (V_{CCA}), U9.2 (DIR), U10.1 (V_{CCA}), U10.2 (DIR), U11.1 (V_{CCA}); also elsewhere on the board
+5VD: J14.5; also elsewhere on the board
+5VP: J14.3; also elsewhere on the board
/Bank0: Display, Keyboard, Clock/P14: U9.9 (A7); also elsewhere on the board
/Bank2: SDCard/CART_MA_CLK: J12.2, U9.8 (A6); also elsewhere on the board
/Bank2: SDCard/CART_MA_DIR: R89.2, U11.2 (DIR); also elsewhere on the board
/Bank2: SDCard/CART_MA_~CS: J12.5, U10.5 (A3); also elsewhere on the board
/Bank2: SDCard/CART_MA_~OE: R83.2, U10.22 (~OE); also elsewhere on the board
/Bank2: SDCard/CART_MA_~OE~_DATA: R87.2, U11.22 (~OE); also elsewhere on the board
/Bank2: SDCard/CART_MA_~RST: J12.30, Q1.2 (S), R91.2; also elsewhere on the board
/Bank2: SDCard/MA0: J12.6, U8.3 (A1); also elsewhere on the board
/Bank2: SDCard/MA1: J12.7, U8.4 (A2); also elsewhere on the board
/Bank2: SDCard/MA2: J12.8, U8.5 (A3); also elsewhere on the board
/Bank2: SDCard/MA3: J12.9, U8.6 (A4); also elsewhere on the board
/Bank2: SDCard/MA4: J12.10, U8.7 (A5); also elsewhere on the board
/Bank2: SDCard/MA5: J12.11, U8.8 (A6); also elsewhere on the board
/Bank2: SDCard/MA6: J12.12, U8.9 (A7); also elsewhere on the board
/Bank2: SDCard/MA7: J12.13, U8.10 (A8); also elsewhere on the board
/Bank2: SDCard/MA8: J12.14, U9.3 (A1); also elsewhere on the board
/Bank2: SDCard/MA9: J12.15, U9.4 (A2); also elsewhere on the board
/Bank2: SDCard/MA10: J12.16, U9.5 (A3); also elsewhere on the board
/Bank2: SDCard/MA11: J12.17, U9.6 (A4); also elsewhere on the board
/Bank2: SDCard/MA12: J12.18, U9.7 (A5); also elsewhere on the board
/Bank2: SDCard/MA13: J12.19, U10.8 (A6); also elsewhere on the board
/Bank2: SDCard/MA14: J12.20, U10.7 (A5); also elsewhere on the board
/Bank2: SDCard/MA15: J12.21, U10.6 (A4); also elsewhere on the board
/Bank2: SDCard/MD0: J12.22, U11.3 (A1); also elsewhere on the board
/Bank2: SDCard/MD1: J12.23, U11.4 (A2); also elsewhere on the board
/Bank2: SDCard/MD2: J12.24, U11.5 (A3); also elsewhere on the board
/Bank2: SDCard/MD3: J12.25, U11.6 (A4); also elsewhere on the board
/Bank2: SDCard/MD4: J12.26, U11.7 (A5); also elsewhere on the board
/Bank2: SDCard/MD5: J12.27, U11.8 (A6); also elsewhere on the board
/Bank2: SDCard/MD6: J12.28, U11.9 (A7); also elsewhere on the board
/Bank2: SDCard/MD7: J12.29, U11.10 (A8); also elsewhere on the board
/Bank3: LEDs, Switches/SOUT: U9.10 (A8); also elsewhere on the board
/Cartridge Master Slot/P14_5V: U9.15 (B7); also elsewhere on the board
/Cartridge Master Slot/SOUT_5V: U9.14 (B8); also elsewhere on the board
/Cartridge Master Slot/X_AIN: J13.31, J15.31
/Cartridge Master Slot/X_MA0: J13.6, J15.6, U8.21 (B1)
/Cartridge Master Slot/X_MA1: J13.7, J15.7, U8.20 (B2)
/Cartridge Master Slot/X_MA2: J13.8, J15.8, U8.19 (B3)
/Cartridge Master Slot/X_MA3: J13.9, J15.9, U8.18 (B4)
/Cartridge Master Slot/X_MA4: J13.10, J15.10, U8.17 (B5)
/Cartridge Master Slot/X_MA5: J13.11, J15.11, U8.16 (B6)
/Cartridge Master Slot/X_MA6: J13.12, J15.12, U8.15 (B7)
/Cartridge Master Slot/X_MA7: J13.13, J15.13, U8.14 (B8)
/Cartridge Master Slot/X_MA8: J13.14, J15.14, U9.21 (B1)
/Cartridge Master Slot/X_MA9: J13.15, J15.15, U9.20 (B2)
/Cartridge Master Slot/X_MA10: J13.16, J15.16, U9.19 (B3)
/Cartridge Master Slot/X_MA11: J13.17, J15.17, U9.18 (B4)
/Cartridge Master Slot/X_MA12: J13.18, J15.18, U9.17 (B5)
/Cartridge Master Slot/X_MA13: J13.19, J15.19, R88.2, U10.16 (B6)
/Cartridge Master Slot/X_MA14: J13.20, J15.20, R86.2, U10.17 (B5)
/Cartridge Master Slot/X_MA15: J13.21, J15.21, R85.2, U10.18 (B4)
/Cartridge Master Slot/X_MCLK: J13.2, J15.2, U9.16 (B6)
/Cartridge Master Slot/X_MD0: J13.22, J15.22, R95.1, R103.1
/Cartridge Master Slot/X_MD1: J13.23, J15.23, R96.1, R104.1
/Cartridge Master Slot/X_MD2: J13.24, J15.24, R97.1, R105.1
/Cartridge Master Slot/X_MD3: J13.25, J15.25, R98.1, R106.1
/Cartridge Master Slot/X_MD4: J13.26, J15.26, R99.1, R107.1
/Cartridge Master Slot/X_MD5: J13.27, J15.27, R100.1, R108.1
/Cartridge Master Slot/X_MD6: J13.28, J15.28, R101.1, R109.1
/Cartridge Master Slot/X_MD7: J13.29, J15.29, R102.1, R110.1
/Cartridge Master Slot/X_~MCS: J13.5, J15.5, R84.2, U10.19 (B3)
/Cartridge Master Slot/X_~MRD: J13.4, J15.4, R92.2, U10.21 (B1)
/Cartridge Master Slot/X_~MRST: J13.30, J15.30, Q1.3 (D), R94.2
/Cartridge Master Slot/X_~MWR: J13.3, J15.3, R93.2, U10.20 (B2)
/~MRD: J12.4, U10.3 (A1); also elsewhere on the board
/~MWR: J12.3, U10.4 (A2); also elsewhere on the board
GND: C65.2, C66.1, C67.2, C68.1, C69.1, C70.1, C71.2, C72.2, C112.2, C113.2, J12.32, J13.32, J15.32, U8.11 (GND), U8.12 (GND), U8.13 (GND), U8.22 (~OE), U9.11 (GND), U9.12 (GND), U9.13 (GND), U9.22 (~OE), U10.9 (A7), U10.10 (A8), U10.11 (GND), U10.12 (GND), U10.13 (GND), U10.14 (B8), U10.15 (B7), U11.11 (GND), U11.12 (GND), U11.13 (GND); also elsewhere on the board
unnamed: R95.2, U11.21 (B1)
unnamed: R96.2, U11.20 (B2)
unnamed: R97.2, U11.19 (B3)
unnamed: R98.2, U11.18 (B4)
unnamed: R99.2, U11.17 (B5)
unnamed: R100.2, U11.16 (B6)
unnamed: R101.2, U11.15 (B7)
unnamed: R102.2, U11.14 (B8)
VCC: C67.1, C68.2, C70.2, C72.1, C112.1, C113.1, J13.1, J14.2, J14.4, J14.6, J15.1, R84.1, R85.1, R86.1, R88.1, R92.1, R93.1, R94.1, R103.2, R104.2, R105.2, R106.2, R107.2, R108.2, R109.2, R110.2, U8.23 (V_{CCB}), U8.24 (V_{CCB}), U9.23 (V_{CCB}), U9.24 (V_{CCB}), U10.23 (V_{CCB}), U10.24 (V_{CCB}), U11.23 (V_{CCB}), U11.24 (V_{CCB}); also elsewhere on the board

Notes on the sheet:
X_VCC
VCC
AIN
GND

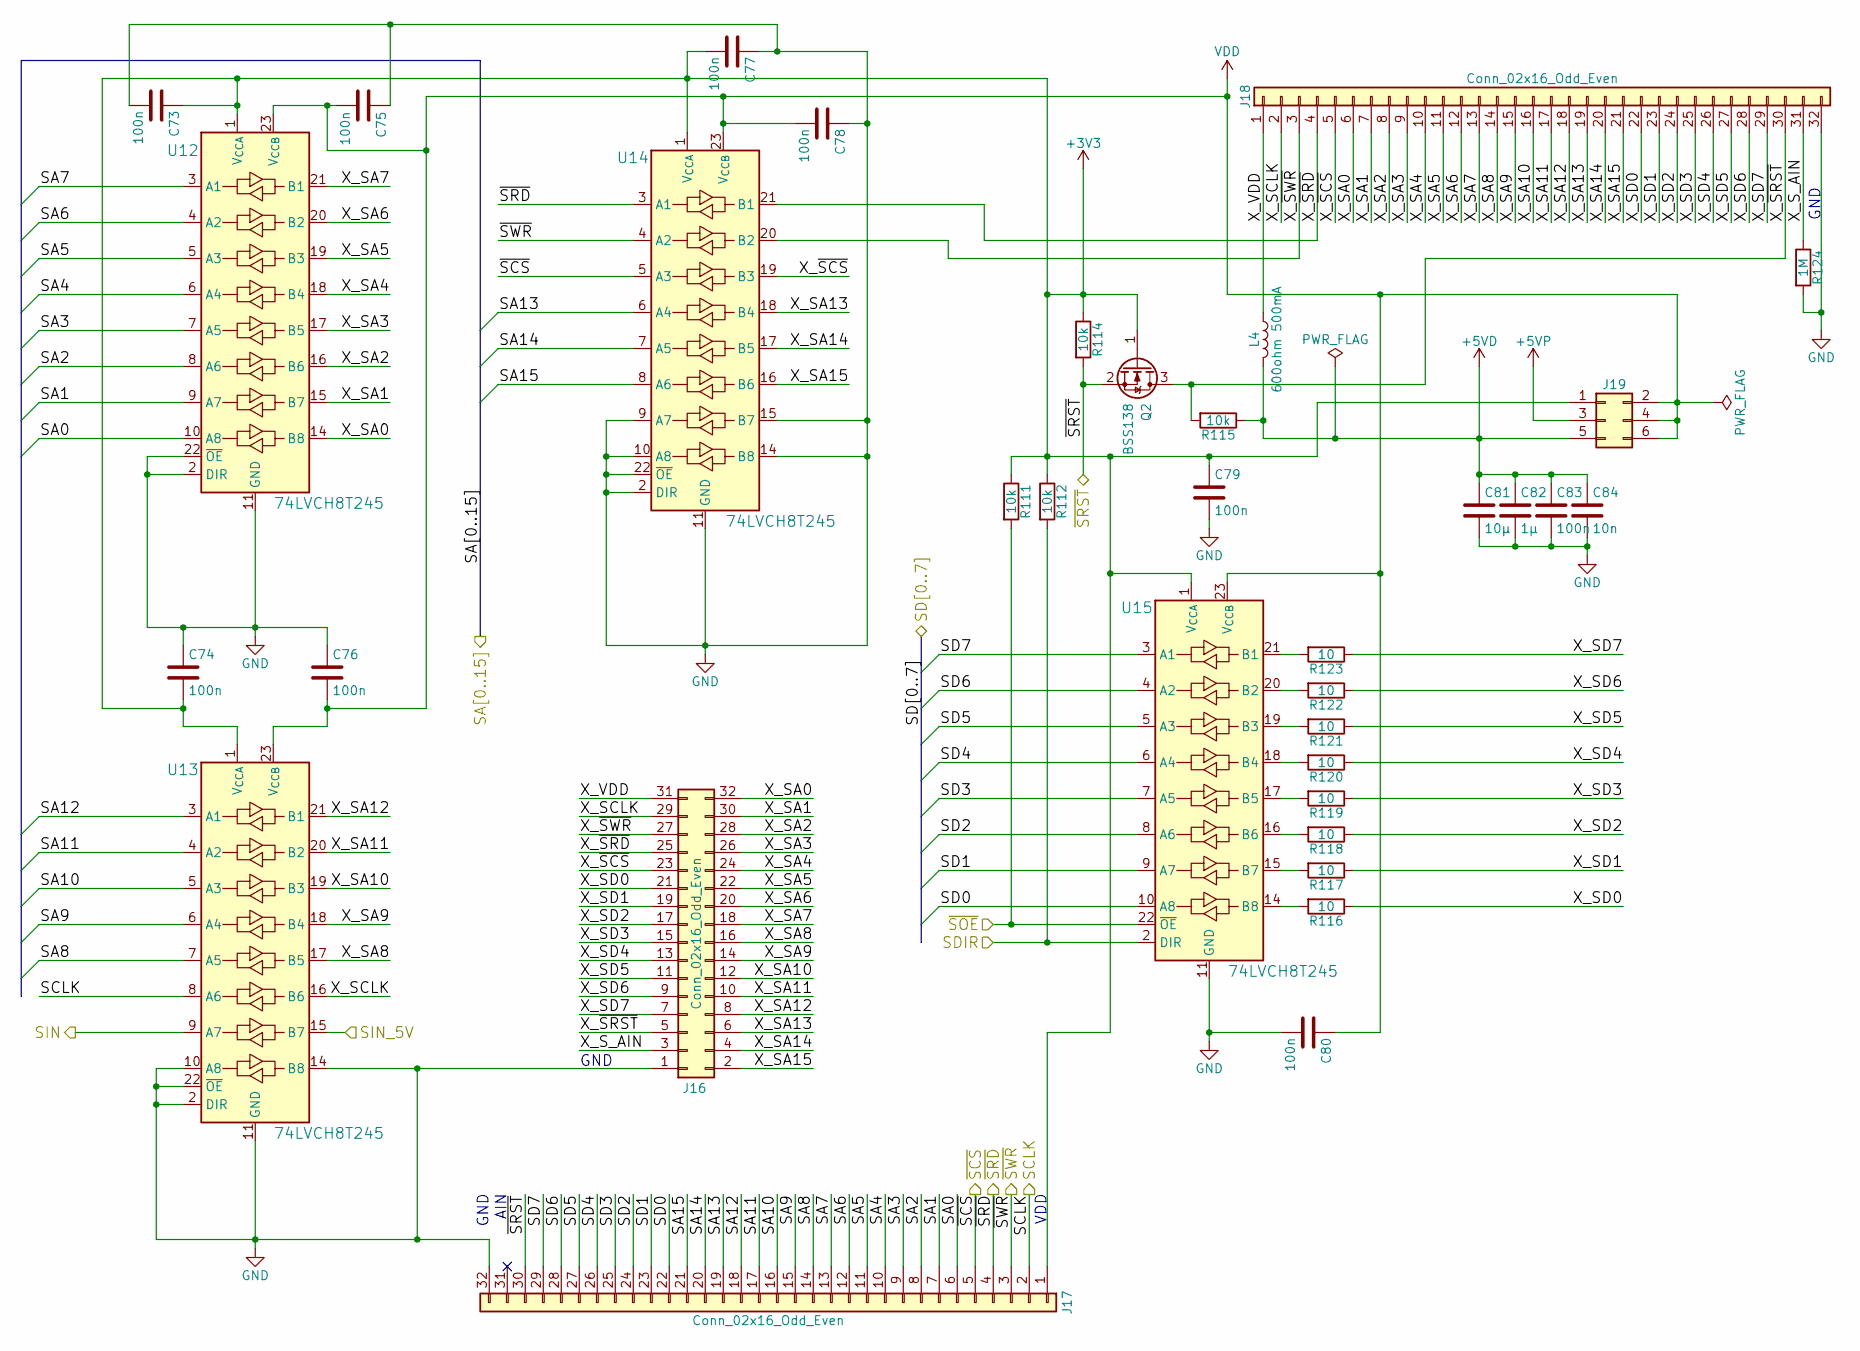
[picture p14: schematic cart_sl.kicad_sch, Game Boy reverse eng. FPGA board]

Parts:
C73, C74, C75, C76, C77, C78, C79, C80, C83: 100n; C_0402_1005Metric_Pad0.74x0.62mm_HandSolder
C81: 10µ; C_0603_1608Metric
C82: 1µ; C_0402_1005Metric_Pad0.74x0.62mm_HandSolder
C84: 10n; C_0402_1005Metric_Pad0.74x0.62mm_HandSolder
J16, J17, J18: Conn_02x16_Odd_Even; PinHeader_2x16_P2.54mm_Vertical
J19: Conn_02x03_Odd_Even; PinHeader_2x03_P2.54mm_Vertical
L4: 600ohm 500mA; L_0603_1608Metric
Q2: BSS138; SOT-323_SC-70
R111, R112, R114, R115: 10k; R_0402_1005Metric
R116, R117, R118, R119, R120, R121, R122, R123: 10; R_0603_1608Metric
R124: 1M; R_0402_1005Metric
U12, U13, U14, U15: 74LVCH8T245; TSSOP-24_4.4x7.8mm_P0.65mm

Connections:
+3V3: C73.1, C74.2, C77.2, C79.1, J17.1, J19.1, Q2.1 (G), R111.1, R112.1, R114.1, U12.1 (V_{CCA}), U13.1 (V_{CCA}), U14.1 (V_{CCA}), U15.1 (V_{CCA}); also elsewhere on the board
+5VD: C81.1, C82.1, C83.1, C84.1, J19.5, L4.2, R115.1; also elsewhere on the board
+5VP: J19.3; also elsewhere on the board
/Bank0: Display, Keyboard, Clock/A0: J17.6, U12.10 (A8); also elsewhere on the board
/Bank0: Display, Keyboard, Clock/A1: J17.7, U12.9 (A7); also elsewhere on the board
/Bank0: Display, Keyboard, Clock/A2: J17.8, U12.8 (A6); also elsewhere on the board
/Bank0: Display, Keyboard, Clock/A3: J17.9, U12.7 (A5); also elsewhere on the board
/Bank0: Display, Keyboard, Clock/A4: J17.10, U12.6 (A4); also elsewhere on the board
/Bank0: Display, Keyboard, Clock/A5: J17.11, U12.5 (A3); also elsewhere on the board
/Bank0: Display, Keyboard, Clock/A6: J17.12, U12.4 (A2); also elsewhere on the board
/Bank0: Display, Keyboard, Clock/A7: J17.13, U12.3 (A1); also elsewhere on the board
/Bank0: Display, Keyboard, Clock/A8: J17.14, U13.7 (A5); also elsewhere on the board
/Bank0: Display, Keyboard, Clock/A9: J17.15, U13.6 (A4); also elsewhere on the board
/Bank0: Display, Keyboard, Clock/A10: J17.16, U13.5 (A3); also elsewhere on the board
/Bank0: Display, Keyboard, Clock/A11: J17.17, U13.4 (A2); also elsewhere on the board
/Bank0: Display, Keyboard, Clock/A12: J17.18, U13.3 (A1); also elsewhere on the board
/Bank0: Display, Keyboard, Clock/A13: J17.19, U14.6 (A4); also elsewhere on the board
/Bank0: Display, Keyboard, Clock/A14: J17.20, U14.7 (A5); also elsewhere on the board
/Bank0: Display, Keyboard, Clock/A15: J17.21, U14.8 (A6); also elsewhere on the board
/Bank0: Display, Keyboard, Clock/CART_SL_CLK: J17.2, U13.8 (A6); also elsewhere on the board
/Bank0: Display, Keyboard, Clock/CART_SL_~RD: J17.4, U14.3 (A1); also elsewhere on the board
/Bank0: Display, Keyboard, Clock/CART_SL_~WR: J17.3, U14.4 (A2); also elsewhere on the board
/Bank1: GPIOA/CART_SL_DIR: R112.2, U15.2 (DIR); also elsewhere on the board
/Bank1: GPIOA/CART_SL_~CS: J17.5, U14.5 (A3); also elsewhere on the board
/Bank1: GPIOA/CART_SL_~OE: R111.2, U15.22 (~OE); also elsewhere on the board
/Bank1: GPIOA/CART_SL_~RST: J17.30, Q2.2 (S), R114.2; also elsewhere on the board
/Bank1: GPIOA/D0: J17.22, U15.10 (A8); also elsewhere on the board
/Bank1: GPIOA/D1: J17.23, U15.9 (A7); also elsewhere on the board
/Bank1: GPIOA/D2: J17.24, U15.8 (A6); also elsewhere on the board
/Bank1: GPIOA/D3: J17.25, U15.7 (A5); also elsewhere on the board
/Bank1: GPIOA/D4: J17.26, U15.6 (A4); also elsewhere on the board
/Bank1: GPIOA/D5: J17.27, U15.5 (A3); also elsewhere on the board
/Bank1: GPIOA/D6: J17.28, U15.4 (A2); also elsewhere on the board
/Bank1: GPIOA/D7: J17.29, U15.3 (A1); also elsewhere on the board
/Cartridge Slave Slot/X_A0: J16.32, J18.6, U12.14 (B8)
/Cartridge Slave Slot/X_A1: J16.30, J18.7, U12.15 (B7)
/Cartridge Slave Slot/X_A2: J16.28, J18.8, U12.16 (B6)
/Cartridge Slave Slot/X_A3: J16.26, J18.9, U12.17 (B5)
/Cartridge Slave Slot/X_A4: J16.24, J18.10, U12.18 (B4)
/Cartridge Slave Slot/X_A5: J16.22, J18.11, U12.19 (B3)
/Cartridge Slave Slot/X_A6: J16.20, J18.12, U12.20 (B2)
/Cartridge Slave Slot/X_A7: J16.18, J18.13, U12.21 (B1)
/Cartridge Slave Slot/X_A8: J16.16, J18.14, U13.17 (B5)
/Cartridge Slave Slot/X_A9: J16.14, J18.15, U13.18 (B4)
/Cartridge Slave Slot/X_A10: J16.12, J18.16, U13.19 (B3)
/Cartridge Slave Slot/X_A11: J16.10, J18.17, U13.20 (B2)
/Cartridge Slave Slot/X_A12: J16.8, J18.18, U13.21 (B1)
/Cartridge Slave Slot/X_A13: J16.6, J18.19, U14.18 (B4)
/Cartridge Slave Slot/X_A14: J16.4, J18.20, U14.17 (B5)
/Cartridge Slave Slot/X_A15: J16.2, J18.21, U14.16 (B6)
/Cartridge Slave Slot/X_AIN: J16.3, J18.31, R124.1
/Cartridge Slave Slot/X_CLK: J16.29, J18.2, U13.16 (B6)
/Cartridge Slave Slot/X_D0: J16.21, J18.22, R116.1
/Cartridge Slave Slot/X_D1: J16.19, J18.23, R117.1
/Cartridge Slave Slot/X_D2: J16.17, J18.24, R118.1
/Cartridge Slave Slot/X_D3: J16.15, J18.25, R119.1
/Cartridge Slave Slot/X_D4: J16.13, J18.26, R120.1
/Cartridge Slave Slot/X_D5: J16.11, J18.27, R121.1
/Cartridge Slave Slot/X_D6: J16.9, J18.28, R122.1
/Cartridge Slave Slot/X_D7: J16.7, J18.29, R123.1
/Cartridge Slave Slot/X_VDD: J16.31, J18.1, L4.1
/Cartridge Slave Slot/X_~CS: J16.23, J18.5, U14.19 (B3)
/Cartridge Slave Slot/X_~RD: J16.25, J18.4, U14.21 (B1)
/Cartridge Slave Slot/X_~RST: J16.5, J18.30, Q2.3 (D), R115.2
/Cartridge Slave Slot/X_~WR: J16.27, J18.3, U14.20 (B2)
/SIN: U13.9 (A7); also elsewhere on the board
/SIN_5V: U13.15 (B7); also elsewhere on the board
GND: C73.2, C74.1, C75.2, C76.1, C77.1, C78.1, C79.2, C80.2, C81.2, C82.2, C83.2, C84.2, J16.1, J17.32, J18.32, R124.2, U12.2 (DIR), U12.11 (GND), U12.12 (GND), U12.13 (GND), U12.22 (~OE), U13.2 (DIR), U13.10 (A8), U13.11 (GND), U13.12 (GND), U13.13 (GND), U13.14 (B8), U13.22 (~OE), U14.2 (DIR), U14.9 (A7), U14.10 (A8), U14.11 (GND), U14.12 (GND), U14.13 (GND), U14.14 (B8), U14.15 (B7), U14.22 (~OE), U15.11 (GND), U15.12 (GND), U15.13 (GND); also elsewhere on the board
unnamed: R116.2, U15.14 (B8)
unnamed: R117.2, U15.15 (B7)
unnamed: R118.2, U15.16 (B6)
unnamed: R119.2, U15.17 (B5)
unnamed: R120.2, U15.18 (B4)
unnamed: R121.2, U15.19 (B3)
unnamed: R122.2, U15.20 (B2)
unnamed: R123.2, U15.21 (B1)
VDD: C75.1, C76.2, C78.2, C80.1, J19.2, J19.4, J19.6, U12.23 (V_{CCB}), U12.24 (V_{CCB}), U13.23 (V_{CCB}), U13.24 (V_{CCB}), U14.23 (V_{CCB}), U14.24 (V_{CCB}), U15.23 (V_{CCB}), U15.24 (V_{CCB}); also elsewhere on the board

Notes on the sheet:
GND
AIN
VDD

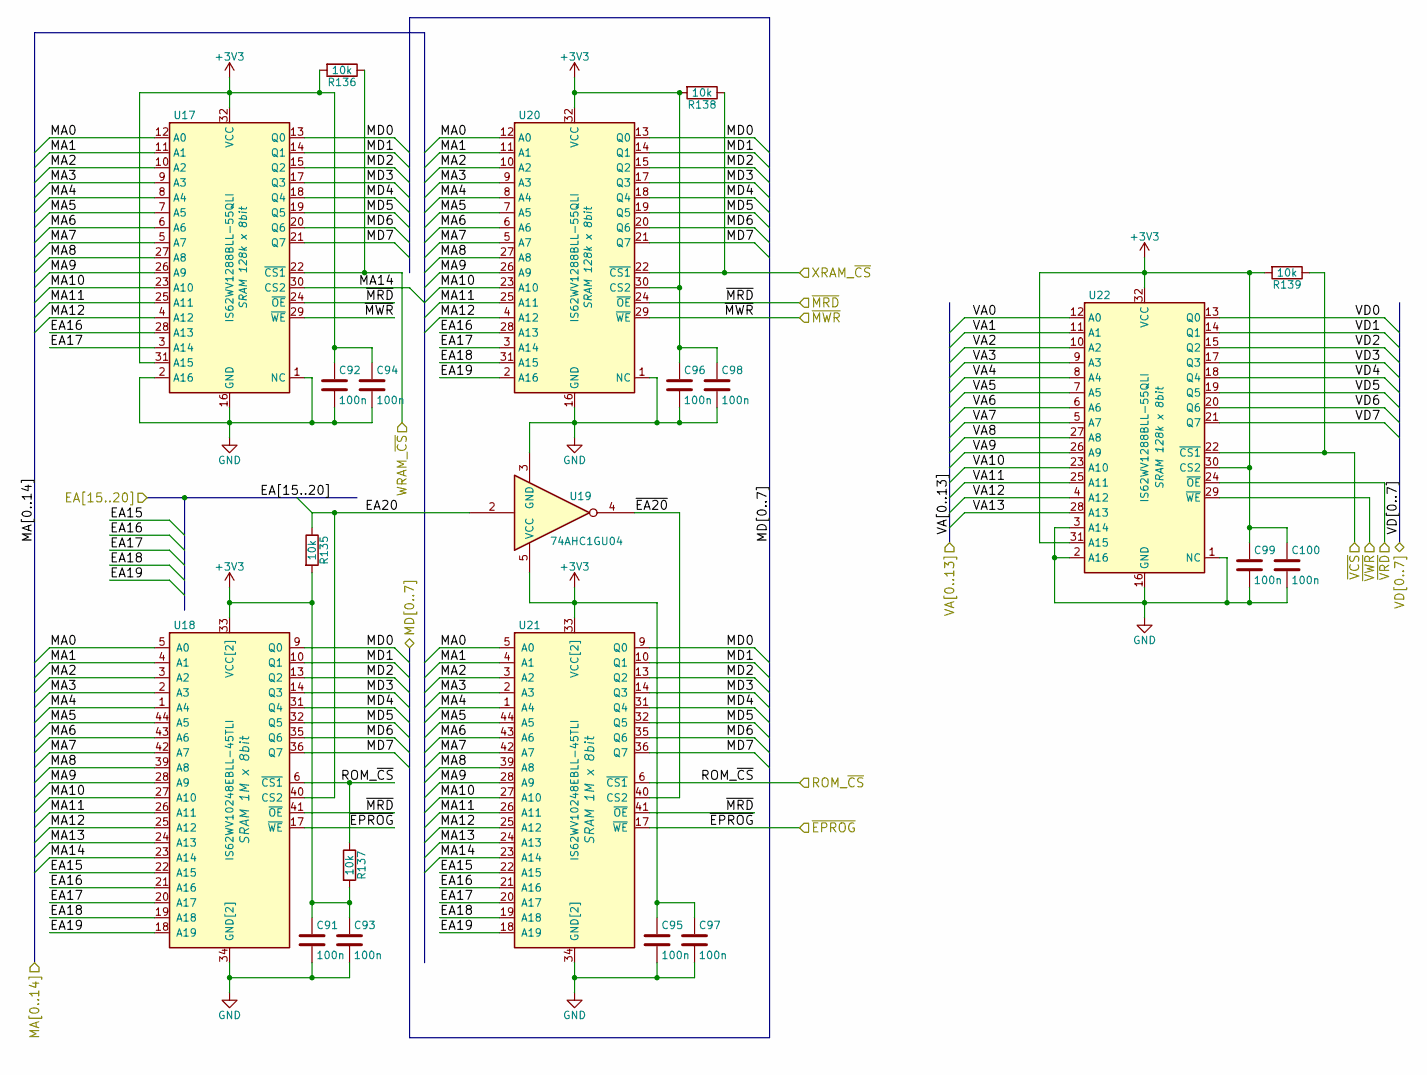
[picture p15: schematic memory.kicad_sch, Game Boy reverse eng. FPGA board]

Parts:
C91, C92, C93, C94, C95, C96, C97, C98, C99, C100: 100n; C_0402_1005Metric_Pad0.74x0.62mm_HandSolder
R135, R136, R137, R138, R139: 10k; R_0402_1005Metric
U17, U20, U22: IS62WV1288BLL-55QLI; SSOP-32_11.305x20.495mm_P1.27mm
U18, U21: IS62WV10248EBLL-45TLI; TSOP-II-44_10.16x18.41mm_P0.8mm
U19: 74AHC1GU04; SOT-353_SC-70-5

Connections:
+3V3: C91.1, C92.1, C93.1, C94.1, C95.1, C96.1, C97.1, C98.1, C99.1, C100.1, R135.2, R136.2, R137.2, R138.2, R139.2, U17.31 (A15), U17.32 (VCC), U18.11 (VCC[2]), U18.33 (VCC[2]), U19.5 (VCC), U20.30 (CS2), U20.32 (VCC), U21.11 (VCC[2]), U21.33 (VCC[2]), U22.30 (CS2), U22.31 (A15), U22.32 (VCC); also elsewhere on the board
/Bank1: GPIOA/VA0: U22.12 (A0); also elsewhere on the board
/Bank1: GPIOA/VA1: U22.11 (A1); also elsewhere on the board
/Bank1: GPIOA/VA2: U22.10 (A2); also elsewhere on the board
/Bank1: GPIOA/VA3: U22.9 (A3); also elsewhere on the board
/Bank1: GPIOA/VA4: U22.8 (A4); also elsewhere on the board
/Bank1: GPIOA/VA5: U22.7 (A5); also elsewhere on the board
/Bank1: GPIOA/VA6: U22.6 (A6); also elsewhere on the board
/Bank1: GPIOA/VA7: U22.5 (A7); also elsewhere on the board
/Bank1: GPIOA/VA8: U22.27 (A8); also elsewhere on the board
/Bank1: GPIOA/VA9: U22.26 (A9); also elsewhere on the board
/Bank1: GPIOA/VA10: U22.23 (A10); also elsewhere on the board
/Bank1: GPIOA/VA11: U22.25 (A11); also elsewhere on the board
/Bank1: GPIOA/VA12: U22.4 (A12); also elsewhere on the board
/Bank1: GPIOA/VA13: U22.28 (A13); also elsewhere on the board
/Bank1: GPIOA/VD0: U22.13 (Q0); also elsewhere on the board
/Bank1: GPIOA/VD1: U22.14 (Q1); also elsewhere on the board
/Bank1: GPIOA/VD2: U22.15 (Q2); also elsewhere on the board
/Bank1: GPIOA/VD3: U22.17 (Q3); also elsewhere on the board
/Bank1: GPIOA/VD4: U22.18 (Q4); also elsewhere on the board
/Bank1: GPIOA/VD5: U22.19 (Q5); also elsewhere on the board
/Bank1: GPIOA/VD6: U22.20 (Q6); also elsewhere on the board
/Bank1: GPIOA/VD7: U22.21 (Q7); also elsewhere on the board
/Bank2: SDCard/EA15: U18.22 (A15), U21.22 (A15); also elsewhere on the board
/Bank2: SDCard/EA16: U17.28 (A13), U18.21 (A16), U20.28 (A13), U21.21 (A16); also elsewhere on the board
/Bank2: SDCard/EA17: U17.3 (A14), U18.20 (A17), U20.3 (A14), U21.20 (A17); also elsewhere on the board
/Bank2: SDCard/EA18: U18.19 (A18), U20.31 (A15), U21.19 (A18); also elsewhere on the board
/Bank2: SDCard/EA19: U18.18 (A19), U20.2 (A16), U21.18 (A19); also elsewhere on the board
/Bank2: SDCard/EA20: R135.1, U18.40 (CS2), U19.2; also elsewhere on the board
/Bank2: SDCard/MA0: U17.12 (A0), U18.5 (A0), U20.12 (A0), U21.5 (A0); also elsewhere on the board
/Bank2: SDCard/MA1: U17.11 (A1), U18.4 (A1), U20.11 (A1), U21.4 (A1); also elsewhere on the board
/Bank2: SDCard/MA2: U17.10 (A2), U18.3 (A2), U20.10 (A2), U21.3 (A2); also elsewhere on the board
/Bank2: SDCard/MA3: U17.9 (A3), U18.2 (A3), U20.9 (A3), U21.2 (A3); also elsewhere on the board
/Bank2: SDCard/MA4: U17.8 (A4), U18.1 (A4), U20.8 (A4), U21.1 (A4); also elsewhere on the board
/Bank2: SDCard/MA5: U17.7 (A5), U18.44 (A5), U20.7 (A5), U21.44 (A5); also elsewhere on the board
/Bank2: SDCard/MA6: U17.6 (A6), U18.43 (A6), U20.6 (A6), U21.43 (A6); also elsewhere on the board
/Bank2: SDCard/MA7: U17.5 (A7), U18.42 (A7), U20.5 (A7), U21.42 (A7); also elsewhere on the board
/Bank2: SDCard/MA8: U17.27 (A8), U18.39 (A8), U20.27 (A8), U21.39 (A8); also elsewhere on the board
/Bank2: SDCard/MA9: U17.26 (A9), U18.28 (A9), U20.26 (A9), U21.28 (A9); also elsewhere on the board
/Bank2: SDCard/MA10: U17.23 (A10), U18.27 (A10), U20.23 (A10), U21.27 (A10); also elsewhere on the board
/Bank2: SDCard/MA11: U17.25 (A11), U18.26 (A11), U20.25 (A11), U21.26 (A11); also elsewhere on the board
/Bank2: SDCard/MA12: U17.4 (A12), U18.25 (A12), U20.4 (A12), U21.25 (A12); also elsewhere on the board
/Bank2: SDCard/MA13: U18.24 (A13), U21.24 (A13); also elsewhere on the board
/Bank2: SDCard/MA14: U17.30 (CS2), U18.23 (A14), U21.23 (A14); also elsewhere on the board
/Bank2: SDCard/MD0: U17.13 (Q0), U18.9 (Q0), U20.13 (Q0), U21.9 (Q0); also elsewhere on the board
/Bank2: SDCard/MD1: U17.14 (Q1), U18.10 (Q1), U20.14 (Q1), U21.10 (Q1); also elsewhere on the board
/Bank2: SDCard/MD2: U17.15 (Q2), U18.13 (Q2), U20.15 (Q2), U21.13 (Q2); also elsewhere on the board
/Bank2: SDCard/MD3: U17.17 (Q3), U18.14 (Q3), U20.17 (Q3), U21.14 (Q3); also elsewhere on the board
/Bank2: SDCard/MD4: U17.18 (Q4), U18.31 (Q4), U20.18 (Q4), U21.31 (Q4); also elsewhere on the board
/Bank2: SDCard/MD5: U17.19 (Q5), U18.32 (Q5), U20.19 (Q5), U21.32 (Q5); also elsewhere on the board
/Bank2: SDCard/MD6: U17.20 (Q6), U18.35 (Q6), U20.20 (Q6), U21.35 (Q6); also elsewhere on the board
/Bank2: SDCard/MD7: U17.21 (Q7), U18.36 (Q7), U20.21 (Q7), U21.36 (Q7); also elsewhere on the board
/Bank2: SDCard/ONBRD_~PROG: U18.17 (~WE), U21.17 (~WE); also elsewhere on the board
/Bank2: SDCard/ROM_~CS: R137.1, U18.6 (~CS1), U21.6 (~CS1); also elsewhere on the board
/Bank2: SDCard/WRAM_~CS: R136.1, U17.22 (~CS1); also elsewhere on the board
/Bank2: SDCard/XRAM_~CS: R138.1, U20.22 (~CS1); also elsewhere on the board
/Memory/~MA20: U19.4, U21.40 (CS2)
/~MRD: U17.24 (~OE), U18.41 (~OE), U20.24 (~OE), U21.41 (~OE); also elsewhere on the board
/~MWR: U17.29 (~WE), U20.29 (~WE); also elsewhere on the board
/~VCS: R139.1, U22.22 (~CS1); also elsewhere on the board
/~VRD: U22.24 (~OE); also elsewhere on the board
/~VWR: U22.29 (~WE); also elsewhere on the board
GND: C91.2, C92.2, C93.2, C94.2, C95.2, C96.2, C97.2, C98.2, C99.2, C100.2, U17.1 (NC), U17.2 (A16), U17.16 (GND), U18.12 (GND[2]), U18.34 (GND[2]), U19.3 (GND), U20.1 (NC), U20.16 (GND), U21.12 (GND[2]), U21.34 (GND[2]), U22.1 (NC), U22.2 (A16), U22.3 (A14), U22.16 (GND); also elsewhere on the board

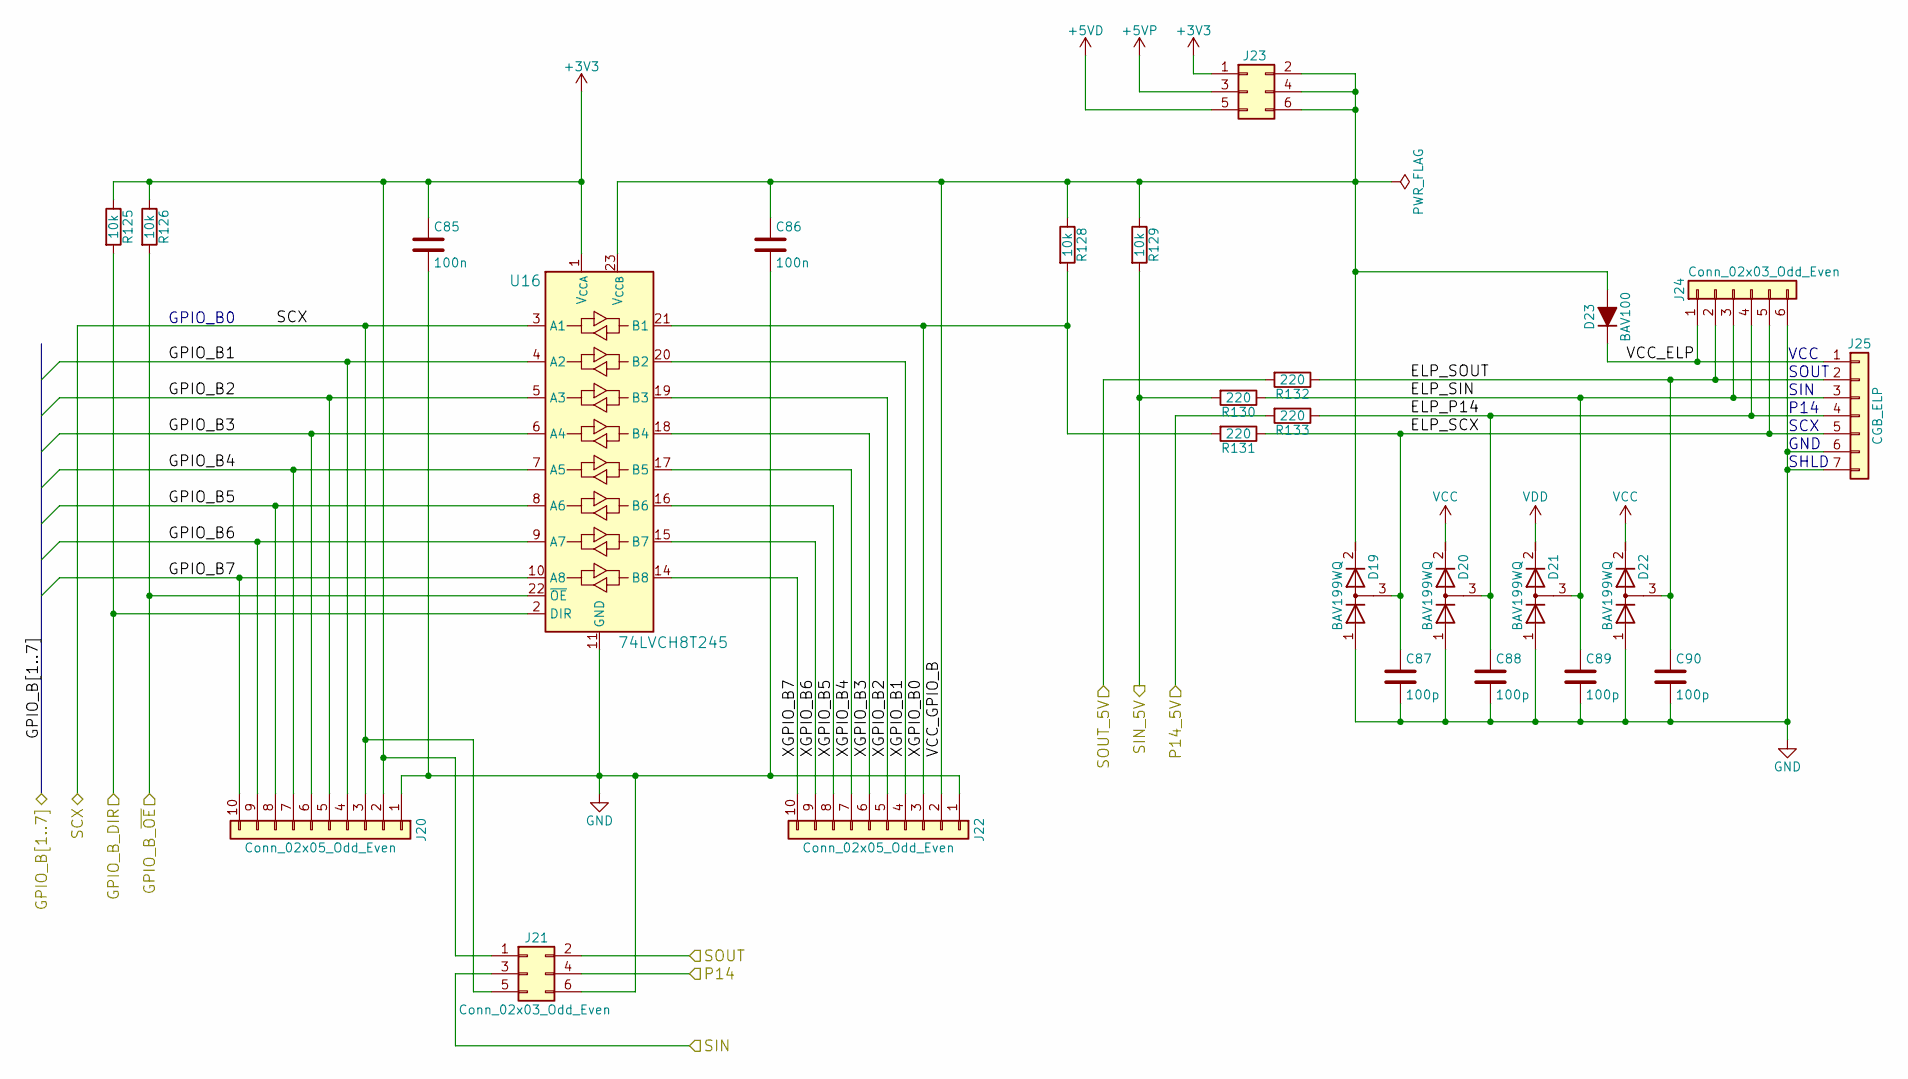
[picture p16: schematic sio.kicad_sch, Game Boy reverse eng. FPGA board]

Parts:
C85, C86: 100n; C_0402_1005Metric_Pad0.74x0.62mm_HandSolder
C87, C88, C89, C90: 100p; C_0402_1005Metric_Pad0.74x0.62mm_HandSolder
D19, D20, D21, D22: BAV199WQ; SOT-323_SC-70
D23: BAV100; D_MiniMELF
J20, J22: Conn_02x05_Odd_Even; PinHeader_2x05_P2.54mm_Vertical
J21, J23, J24: Conn_02x03_Odd_Even; PinHeader_2x03_P2.54mm_Vertical
J25: CGB_ELP; CGB_External-Link-Port
R125, R126, R128, R129: 10k; R_0402_1005Metric
R130, R131, R132, R133: 220; R_0805_2012Metric
U16: 74LVCH8T245; TSSOP-24_4.4x7.8mm_P0.65mm

Connections:
+3V3: C85.1, J20.2, J21.1, J23.1, R125.1, R126.1, U16.1 (V_{CCA}); also elsewhere on the board
+5VD: J23.5; also elsewhere on the board
+5VP: J23.3; also elsewhere on the board
/Bank0: Display, Keyboard, Clock/P14: J21.4; also elsewhere on the board
/Bank3: LEDs, Switches/GPIO_B1: J20.4, U16.4 (A2); also elsewhere on the board
/Bank3: LEDs, Switches/GPIO_B2: J20.5, U16.5 (A3); also elsewhere on the board
/Bank3: LEDs, Switches/GPIO_B3: J20.6, U16.6 (A4); also elsewhere on the board
/Bank3: LEDs, Switches/GPIO_B4: J20.7, U16.7 (A5); also elsewhere on the board
/Bank3: LEDs, Switches/GPIO_B5: J20.8, U16.8 (A6); also elsewhere on the board
/Bank3: LEDs, Switches/GPIO_B_~OE: R126.2, U16.22 (~OE); also elsewhere on the board
/Bank3: LEDs, Switches/SCX: J20.3, J21.5, U16.3 (A1); also elsewhere on the board
/Bank3: LEDs, Switches/SOUT: J21.2; also elsewhere on the board
/Cartridge Master Slot/P14_5V: R133.2; also elsewhere on the board
/Cartridge Master Slot/SOUT_5V: R132.2; also elsewhere on the board
/External Link Port, GPIOB/DIR: R125.2, U16.2 (DIR); also elsewhere on the board
/External Link Port, GPIOB/ELP_P14: C88.1, D20.3 (common), J24.4, J25.4, R133.1
/External Link Port, GPIOB/ELP_SCX: C87.1, D19.3 (common), J24.5, J25.5, R131.1
/External Link Port, GPIOB/ELP_SIN: C89.1, D21.3 (common), J24.3, J25.3, R130.1
/External Link Port, GPIOB/ELP_SOUT: C90.1, D22.3 (common), J24.2, J25.2, R132.1
/External Link Port, GPIOB/VCC_ELP: D23.1 (K), J24.1, J25.1
/External Link Port, GPIOB/VCC_GPIO_B: C86.1, D19.2 (K), D23.2 (A), J22.2, J23.2, J23.4, J23.6, R128.1, R129.1, U16.23 (V_{CCB}), U16.24 (V_{CCB})
/External Link Port, GPIOB/XGPIO_B0: J22.3, R128.2, R131.2, U16.21 (B1)
/External Link Port, GPIOB/XGPIO_B1: J22.4, U16.20 (B2)
/External Link Port, GPIOB/XGPIO_B2: J22.5, U16.19 (B3)
/External Link Port, GPIOB/XGPIO_B3: J22.6, U16.18 (B4)
/External Link Port, GPIOB/XGPIO_B4: J22.7, U16.17 (B5)
/External Link Port, GPIOB/XGPIO_B5: J22.8, U16.16 (B6)
/External Link Port, GPIOB/XGPIO_B6: J22.9, U16.15 (B7)
/External Link Port, GPIOB/XGPIO_B7: J22.10, U16.14 (B8)
/GPIO_B6: J20.9, U16.9 (A7); also elsewhere on the board
/GPIO_B7: J20.10, U16.10 (A8); also elsewhere on the board
/SIN: J21.3; also elsewhere on the board
/SIN_5V: R129.2, R130.2; also elsewhere on the board
GND: C85.2, C86.2, C87.2, C88.2, C89.2, C90.2, D19.1 (A), D20.1 (A), D21.1 (A), D22.1 (A), J20.1, J21.6, J22.1, J24.6, J25.6, J25.7, U16.11 (GND), U16.12 (GND), U16.13 (GND); also elsewhere on the board
VCC: D20.2 (K), D22.2 (K); also elsewhere on the board
VDD: D21.2 (K); also elsewhere on the board

Notes on the sheet:
SHLD
SOUT
SIN
P14
GND
VCC
SCX
GPIO_B0
