msinger/gbreveng/pcb/fpgaboard/fpgaboard.kicad_pcb

## KiCad design pcb/fpgaboard/fpgaboard.kicad_pcb (continued)

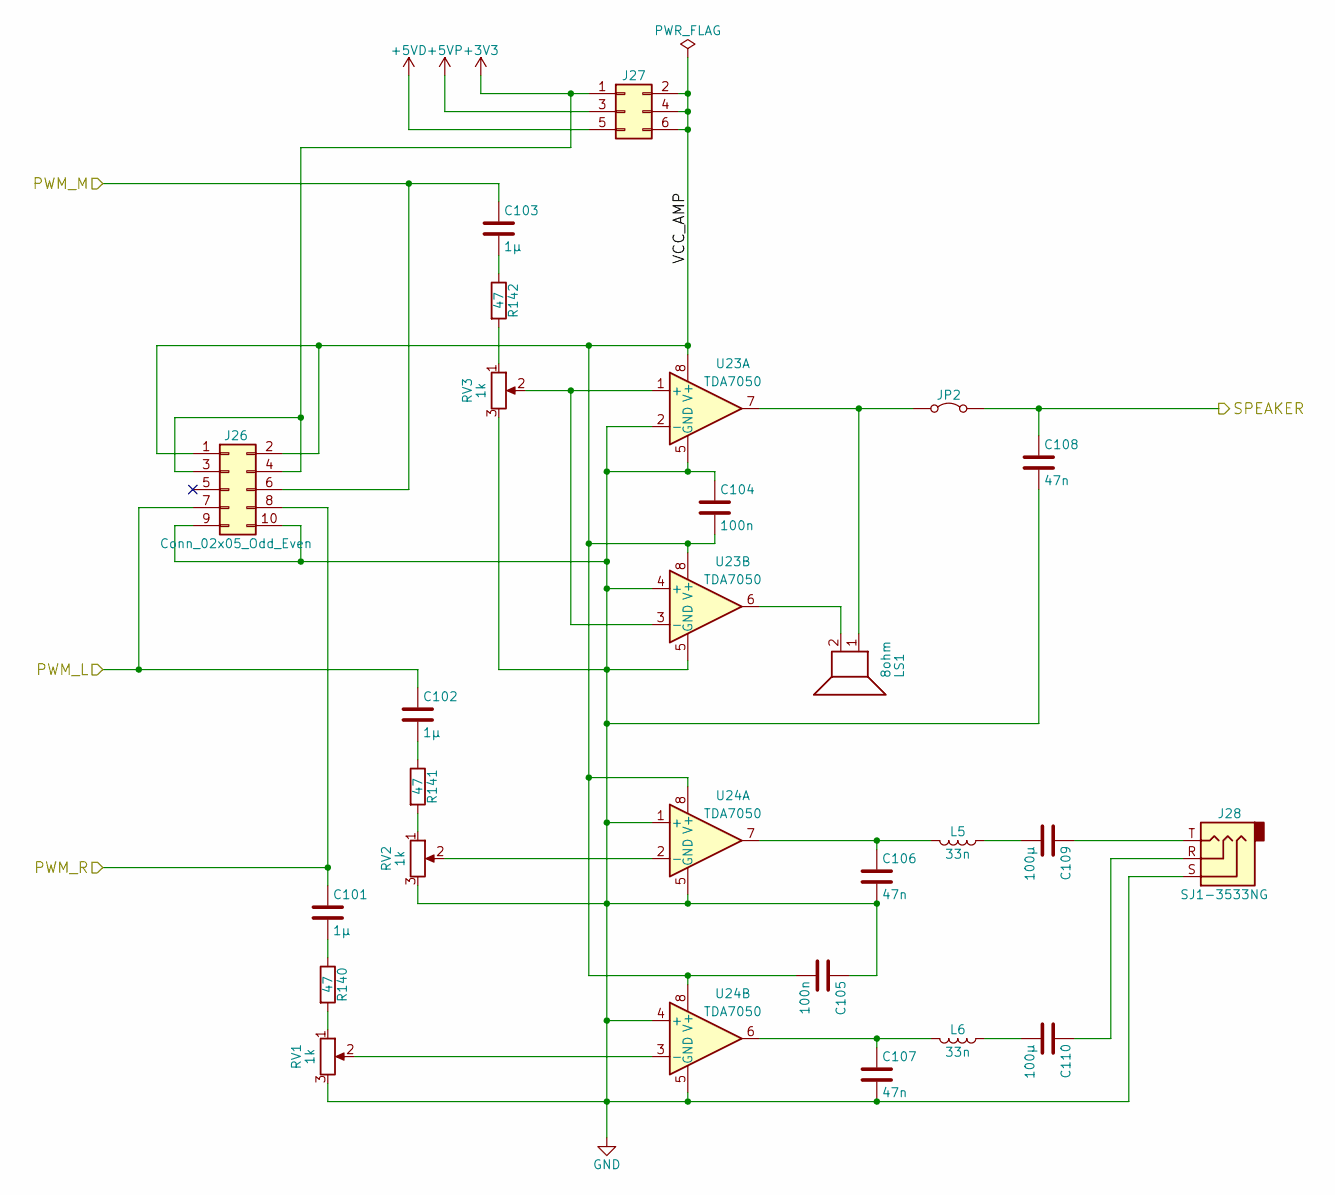
[picture p17: schematic audio.kicad_sch, Game Boy reverse eng. FPGA board]

Parts:
C101, C102, C103: 1µ; C_0402_1005Metric_Pad0.74x0.62mm_HandSolder
C104, C105: 100n; C_0402_1005Metric_Pad0.74x0.62mm_HandSolder
C106, C107, C108: 47n; C_0402_1005Metric_Pad0.74x0.62mm_HandSolder
C109, C110: 100µ; C_1206_3216Metric
J26: Conn_02x05_Odd_Even; PinHeader_2x05_P2.54mm_Vertical
J27: Conn_02x03_Odd_Even; PinHeader_2x03_P2.54mm_Vertical
J28: SJ1-3533NG; Jack_3.5mm_CUI_SJ1-3533NG_Horizontal
JP2: Jumper_2_Bridged; PinHeader_1x02_P2.54mm_Vertical
L5, L6: 33n; L_0402_1005Metric
LS1: 8ohm; PinHeader_1x02_P2.54mm_Vertical
R140, R141, R142: 47; R_0402_1005Metric
RV1, RV2, RV3: 1k; Potentiometer_Vishay_TS53YL_Vertical
U23, U24: TDA7050; DIP-8_W7.62mm_Socket

Connections:
+3V3: J26.3, J26.4, J27.1; also elsewhere on the board
+5VD: J27.5; also elsewhere on the board
+5VP: J27.3; also elsewhere on the board
/Audio/PWM_L: C102.1, J26.7; also elsewhere on the board
/Audio/PWM_M: C103.1, J26.6; also elsewhere on the board
/Audio/PWM_R: C101.1, J26.8; also elsewhere on the board
/Audio/SPEAKER: C108.1, JP2.2 (B); also elsewhere on the board
/Audio/VCC_AMP: C104.2, C105.2, J26.1, J26.2, J27.2, J27.4, J27.6, U23.8 (V+), U24.8 (V+)
GND: C104.1, C105.1, C106.2, C107.2, C108.2, J26.9, J26.10, J28.S, RV1.3, RV2.3, RV3.3, U23.2 (-), U23.4 (+), U23.5 (GND), U24.1 (+), U24.4 (+), U24.5 (GND); also elsewhere on the board
unnamed: C101.2, R140.1
unnamed: C102.2, R141.1
unnamed: C103.2, R142.1
unnamed: C106.1, L5.2, U24.7
unnamed: C107.1, L6.2, U24.6
unnamed: C109.1, J28.T
unnamed: C109.2, L5.1
unnamed: C110.1, J28.R
unnamed: C110.2, L6.1
unnamed: JP2.1 (A), LS1.1, U23.7
unnamed: LS1.2, U23.6
unnamed: R140.2, RV1.1
unnamed: R141.2, RV2.1
unnamed: R142.2, RV3.1
unnamed: RV1.2, U24.3 (-)
unnamed: RV2.2, U24.2 (-)
unnamed: RV3.2, U23.1 (+), U23.3 (-)

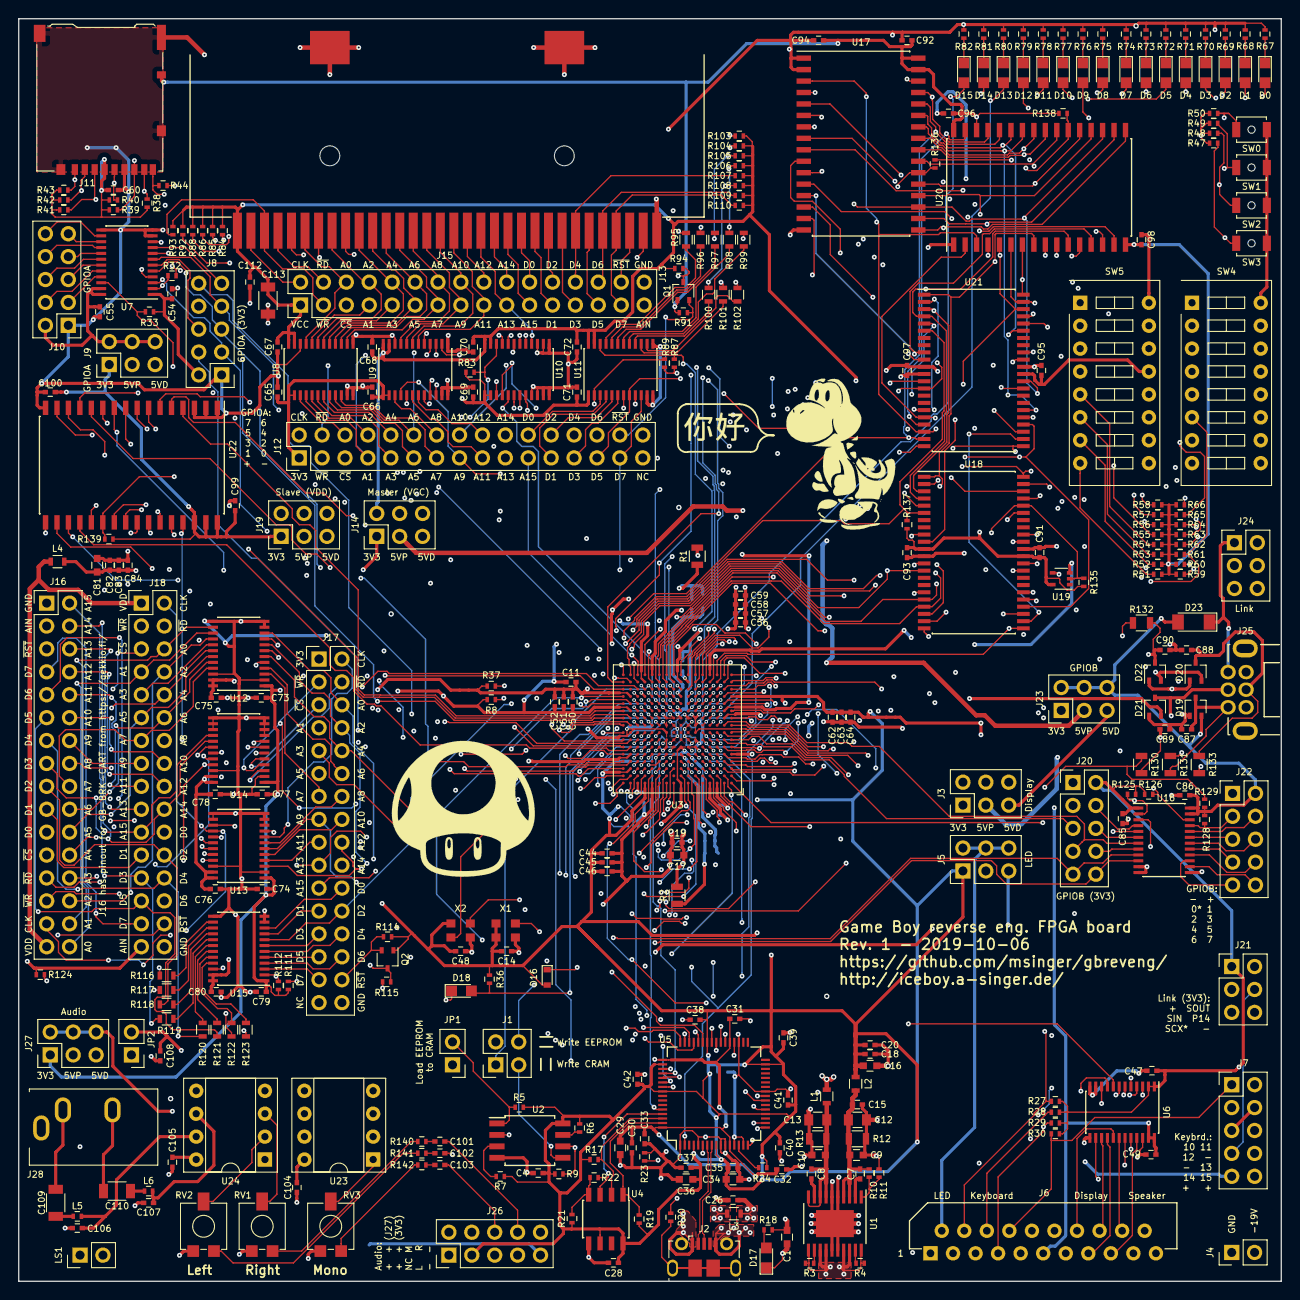
[picture p18: board fpgaboard.kicad_pcb from above]

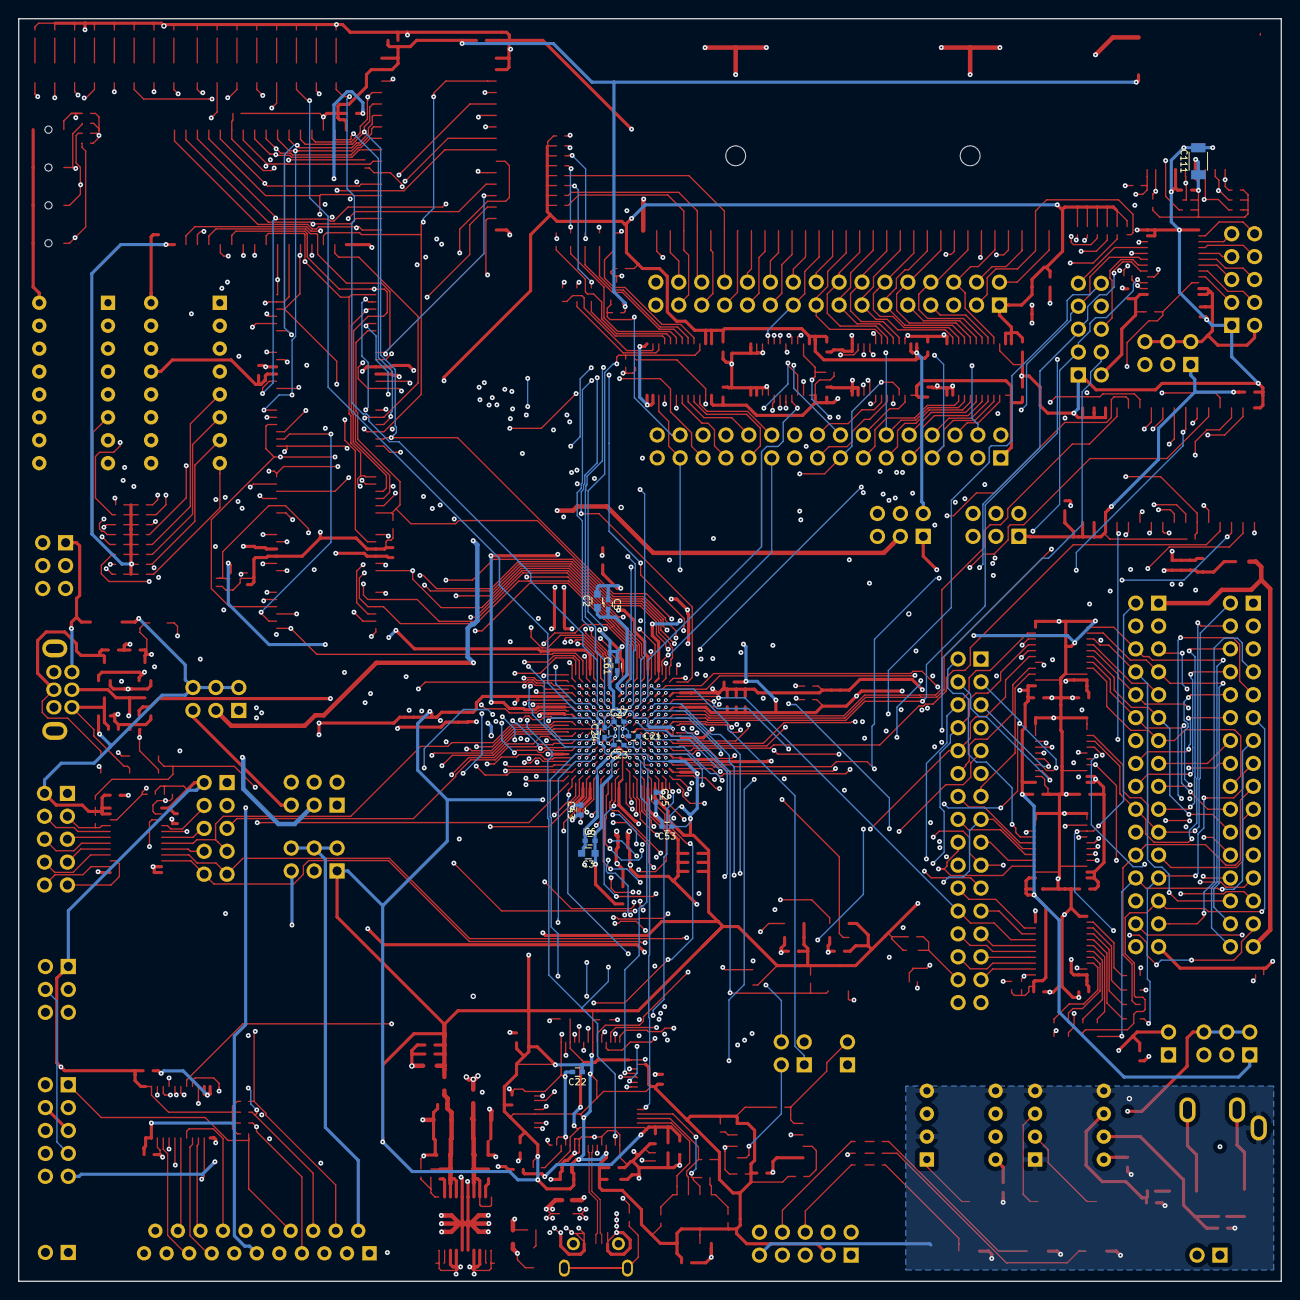
[picture p19: board fpgaboard.kicad_pcb from below]

Board: 4 copper layers, 140.0 x 140.0 mm, 342 parts (14 on the bottom side), 391 nets.

Other parts of the board:
G1: Yoshi
G2: hello
G3: shroom
