msinger/gbreveng/(commit log)

2018-11-11 add dummy tables for DMA bus access
2018-11-13 add comments with DMA and VRAM timings
2018-11-23 print summary after ./configure
2018-11-24 glitch through FF50 write instruction
    Trophy unlocked!
    Ready to mess around with a GameBoy with mapped in boot ROM.
    [skip_ff50.pcf, top.v]
2018-11-25 more precise way of skipping FF50 write
    [top.v]
2019-01-20 fpga board rev. 0
    [audio.sch, bank0.sch, bank1.sch, bank2.sch, bank3.sch, cart_ma.sch, cart_sl.sch, fpgaboard.kicad_pcb]
2019-01-20 add BOM and iomap
    [bom.ods]
2019-03-03 add sum of parts in BOM
    [bom.ods]
2019-04-30 port genclk to gbreveng board
2019-04-30 port skip_ff50 to gbreveng board
    [skip_ff50.pcf, top.v]
2019-05-01 port mrd_test to gbreveng board
2019-05-25 proof that 2-bit machine cycle reg is never reset
    [top.v]
2019-08-09 switch to next-pnr
2019-08-10 make genclk and skip_ff50 restartable
    [top.v]
2019-08-10 cartfix PCB for patching pin swap of gbreveng J16
    [cartfix.kicad_pcb, cartfix.sch]
2019-08-10 add PCB for probing DMG display signals
    [disp_bridge.kicad_pcb, disp_bridge.sch]
2019-08-10 fix pin swap of gbreveng fpga board J16
    [audio.sch, bank0.sch, bank1.sch, bank2.sch, bank3.sch, cart_ma.sch, cart_sl.sch, fpgaboard.kicad_pcb]
2019-08-16 label all external connector pins on gbreveng brd.
    [audio.sch, bank0.sch, bank1.sch, bank2.sch, bank3.sch, cart_ma.sch, cart_sl.sch, fpgaboard.kicad_pcb]
2019-10-06 fix labeling of D0&D1 LCD signals
    [audio.sch, bank0.sch, bank1.sch, bank2.sch, bank3.sch, cart_ma.sch, cart_sl.sch, disp_bridge.kicad_pcb]
2019-10-27 added labels for FT245 configuration of FTDI
    [audio.sch, bank0.sch, bank1.sch, bank2.sch, bank3.sch, cart_ma.sch, cart_sl.sch, fpgaboard.sch]
2019-11-08 fix/update pin list
2019-11-10 shiva: add RAMs, LEDs and switches to bus
2019-12-08 fix lvl converter enable
    [top.v]
2020-04-10 fix underscores in literals
    [top.v]
2020-05-04 add connection in schematic
    [audio.sch, bank0.sch, bank1.sch, bank2.sch, bank3.sch, cart_ma.sch, cart_sl.sch, fpgaboard.sch]
2020-06-05 use wor and wand again; yosys fixed it
    [counter_block.v, top.v]
2020-08-29 add tests for checking BGA soldering
    * test clock inputs
    * test LEDs and switches
    * test p10-15
    * test LCD pins
2020-08-29 fix some ugly PCB traces
    [fpgaboard.kicad_pcb]
2020-08-29 add GB code for testing LCD driver behaviour
2020-08-29 add soundfix PCB for gbreveng rev. 0
    [soundfix.kicad_pcb, soundfix.sch]
2020-08-29 add PCB for testing -19V supply for LCD bias
    [lcdpwr.kicad_pcb, lcdpwr.sch]
2020-08-30 fix VRAM read and write signal
    [shiva.pcf, test_hw.pcf]
2021-05-16 Add Wide-Boy64 AGB 40-pin conn to CPU&FPGA pin#s
2021-05-16 Finish Wide-Boy64 AGB 40-pin conn table
2021-05-26 Fix Flash reset pin in WB64 doc
2021-05-26 Add WB64AGB FPGA pin documentation
2021-08-14 Remove obsolete wideboy clockgen schematic
    There is a complete schematic now that contains the clock generation.
2021-08-14 Add complete Wideboy 64 AGB schematic
2021-08-16 Add note about inverting reset pin
2021-08-17 Rename assembler and linker LR35902->SM83
2021-08-17 Update assembler files
2021-08-28 CPU docs: Fix direction of pin T7 (FROM_CPU5)
2021-08-29 Fix documentation about CPU pin T14
2021-09-16 Add test rom that just makes sure SCK is an input
    for testing for pull-up resistor.
2021-09-18 Modified genclk test for testing T1 and T2
    Found out that the three inputs buffers RST, T1 and T2 of
    the DMG CPU B are all three inverting, which means that the
    reset of the DFFs ADYK, AFUR, ALEF, APUK and AFER is actually
    not working when T1 and T2 are pulled down to GND. They would
    have to be pulled up to VCC for the reset to work properly.
    [genclk.pcf, top.v]
2021-09-18 Disable competitive pull-up resistors
    I thought my dip switches broke, but I just messed up the pull-up
    configuration. I had enebled the pull-ups inside the FPGA even though I
    have pull-downs on the PCB. :/
    [top.v]
2021-09-19 Document IBUFFER pull-up resistors
2021-10-21 Update page infos of fpgaboard KiCad files
    [audio.sch, bank0.sch, bank1.sch, bank2.sch, bank3.sch, cart_ma.sch, cart_sl.sch, fpgaboard.kicad_pcb]
2021-10-22 Update Wide-Boy schematic
2021-10-24 Fix some glitchy feedback loop
    [top.sv]
2022-02-07 Add CMOS circuits to cell reference
2022-03-08 Use simpler MOSFET symbols in documentation
2022-03-08 Add CMOS circuit for MUX and MUXI
2022-03-08 Document layout and schematic of TRI_INV cells
2022-03-11 Add layout and schematics for D-Latches, AO3 and SUPPLY cells
2022-03-13 Add layout and schematic for tri-state buffer cell
2022-03-16 Add schematics for IO pads
2022-10-02 Rename schematic pictures from *_cmos.png to *_sch.png
2022-11-06 Fix OAI, MUX and MUXI pin names
2023-06-18 Add layouts and fixed schematics for IBUFFER cells
2023-07-30 Fix some schematics in documentation
2023-08-04 Add schematic and layout of DFFR_A cell
2023-08-06 Add layouts and schematics for DFFR_B and DFFR_B2
    + Update description of DFFR_A, DFFR_B and DFFR_B2.
    + Update DFFR_A layout.
2023-08-08 Add layout and schematic for DFFSR cell
2023-08-10 Add layout and schematic for TFFD cell
2024-06-19 Migrate fpgaboard from KiCad 4 to KiCad 8
    [audio.kicad_sch, audio.sch, bank0.kicad_sch, bank0.sch, bank1.kicad_sch, bank1.sch, bank2.kicad_sch, bank2.sch]
2024-06-20 Migrate other PCBs from KiCad 4 to KiCad 8
    [audio.kicad_sch, cartfix.kicad_pcb, cartfix.kicad_sch, cartfix.sch, disp_bridge.kicad_pcb, disp_bridge.kicad_sch, disp_bridge.sch, lcdpwr.kicad_pcb]
2024-07-01 Update Wide-Boy documentation
    * Add information about EEPROM content
    * Add information about flash dumping
    * Add code for flash dumping
    * Fix embarrasing spelling errors
    [dump.pcf, dump.sv]
2024-07-01 WB64: Add picture of PCB under flash
2024-08-05 Fix some undefined behavior
    [dp_reg.sv]
2024-09-15 Add documentation about Nintendo Power cartridge
    Uploaded here: http://iceboy.a-singer.de/doc/np_gb_memory.html
2024-09-17 Fix NP GB Memory documentation
    It seems like I made some mistakes while testing the size of the map
    region. It is actually 256 bytes, not 128. I noticed this when I was
    testing it on the flash chip in the Net de Get cartridges.
    Also I didn't include the "unprotect sector 0" command. I unlocked
    sector 0 on the two cartridges I used for testing, and then I thought
    the command isn't necessary, because everything worked without it. It
    didn't cross my mind that this command could be persistent, even after
    power cycling the cartridge. Now I also found the counterpart command
    for re-enabing the protection of sector 0.
2024-09-18 Add Net de Get flash chip to the documentation
2024-09-23 Add link to KiCad project of NP cartridge
2024-09-24 Add reset pin description to NP GB Mem doc
2024-09-29 Update Nintendo Power GB Mem cartride doc
2024-10-01 Update host reset pin description in NP GB Mem doc
2024-10-04 Fix WP# pin in NP GB Mem doc
2024-10-05 Add high-active RESET to WideBoy PROM dumper
    [dump.pcf, dump.sv]
2024-10-17 DMG Cells: Remove wrong schematics of OSC and IOC
    refs #2
2024-12-09 Fix absolute paths and some labels
    [audio.kicad_sch, bank0.kicad_sch, bank1.kicad_sch, bank2.kicad_sch, bank3.kicad_sch, cart_ma.kicad_sch, cart_sl.kicad_sch, fpgaboard.kicad_sch]
2025-03-29 Ignore *.kicad_prl
2025-10-22 Fix schematic in IDU0 documentation
2025-10-31 Cleanup schematic of ALU_PGGEN
2025-11-01 Add missing annotation in IRQ_PRIO_BIT5 schematic
2025-12-25 Add link to SM83 schematics
2026-02-19 DMG Cells: Fix DFFSR schematic
2026-04-13 Update TODOs
    * Remove Iceboy TODOs, since I need to completely rewrite everything
    based on the schematics anyway.
    * Moved Wide Boy TODOs into wideboy file.
