msinger/gbreveng/(notices)

Notices in the files:
pcb/fpgaboard/bank2.kicad_sch:
CC-BY-SA-4.0 Michael Singer
